Tomash1A/FPGAPlatformController/ALTIUM- UPDATED PCB DESIGN/projectHW_ADC_build/adc/adc.runs/impl_1/.init_design.begin.rst

<?xml version="1.0"?>
<ProcessHandle Version="1" Minor="0">
    <Process Command=".planAhead." Owner="shtomer" Host="CS-RO-PC29" Pid="99484">
    </Process>
</ProcessHandle>
