Tomash1A/FPGAPlatformController/ALTIUM- UPDATED PCB DESIGN/DAC_Sources_original_version/Project Outputs for DACֹֹ_Sources/DACֹֹ_Sources.xlsx

Comment | Description | Designator | Footprint | LibRef | Quantity
600F110JT250XT | CAP CER 11PF 50V 5% NP0 0805 | C1, C3, C4, C6, C10, C19, C145, C147, C148, C150, C154, C156, C157, C159, C163, C165, C166, C168, C172, C174, C175, C177, C181, C183, C184, C186, C190, C192, C193, C195, C199, C201 | C0805 | b4654b650e69147ec39a6b967a45e02 | 32
600F120JT250XT | CAP CER 11PF 50V 5% NP0 0805 | C2, C5, C11, C146, C149, C155, C158, C164, C167, C173, C176, C182, C185, C191, C194, C200 | C0805 | b4654b650e69147ec39a6b967a45e02 | 16
GJM1555C1H3R3CB01D | Multi-Layer Ceramic Capacitor 3.3pF C0G ±0.25pF 0402 Paper T/R | C7, C8, C9, C142, C143, C144, C151, C152, C153, C160, C161, C162, C169, C170, C171, C178, C179, C180, C187, C188, C189, C196, C197, C198 | C0402 | 02cd4be3c70576c341d710602a673aa | 24
CL31B103KHFNNNE | Cap Ceramic 10nF 630V X7R ±10% SMD 1206 +125°C Embossed T/R | C12, C14, C16, C18, C21, C22, C25, C26, C27, C29, C32, C309, C310, C311, C312, C313, C314, C315 | C1206 | b4654b650e69147ec39a6b967a45e02 | 18
C1206C150J5GACTU | 1206 C 15pF Ceramic Multilayer Capacitor; 50 VDC; +125degC; C0G Dielec; +/-5% | C13 | C1206 | b4654b650e69147ec39a6b967a45e02 | 1
CL10A475KP8NNNC | Cap Ceramic 4.7uF 10V X5R ±10% Pad SMD 0603 +85°C T/R | C15, C17, C20, C24, C28, C30, C31 | C0603 | b4654b650e69147ec39a6b967a45e02 | 7
C1005X7R1E102K050BA | Multilayer Ceramic Capacitors 1nF ±10% 25V X7R SMD 0402 | C23, C210, C213, C214, C217 | C0402 | b4654b650e69147ec39a6b967a45e02 | 5
GCM188R71C274KA37D | Ceramic Capacitor for Automotive 270nF ±10% 16VDC X7R 0603 Paper T/R | C33 | C0603 | 02cd4be3c70576c341d710602a673aa | 1
C0603C220J5GACTU | Cap Ceramic 22pF 50V C0G 5% SMD 0603 125°C Paper T/R | C34, C295 | C0603 | b4654b650e69147ec39a6b967a45e02 | 2
C1608X7R1C105K080AC | Multilayer Ceramic Capacitors 1μF ±10% 16V X7R SMD 0603 | C35, C39, C42, C53, C58, C64, C66, C71, C73, C88, C93, C99, C101, C106, C108, C289, C293, C297, C300, C304 | C0603 | 236180d848d6139a670b325ea6854c9 | 20
C1005X7R1E103K050BB | Multilayer Ceramic Capacitors 10nF ±10% 25V X7R SMD 0402 | C36, C48, C54, C59, C62, C65, C67, C72, C74, C89, C94, C97, C100, C102, C107, C109, C115, C123, C141, C270, C271, C272, C274, C275, C276, C277, C278, C279, C281, C282, C285, C286, C287, C290, C301, C306, C316, C317, C318, C319, C320, C321, C322, C323 | C0402 | b4654b650e69147ec39a6b967a45e02 | 44
GRM21BR71A106KE51L |  | C37, C38, C40, C46, C55, C56, C57, C63, C68, C69, C75, C76, C90, C91, C92, C98, C103, C104, C110, C111, C291, C292, C296, C299, C302, C303 | C0805 | CAP | 26
C1005X7R1C104K050BC | Multilayer Ceramic Capacitors 100nF ±10% 16V X7R SMD 0402 | C41, C43, C44, C47, C60, C95, C116, C117, C118, C119, C120, C124, C125, C126, C127, C128, C129, C130, C133, C134, C135, C136, C137, C138, C139, C140, C211, C212, C215, C216, C294, C298, C305 | C0402 | b4654b650e69147ec39a6b967a45e02 | 33
C1005X5R1C105K050BC | Chip Capacitor, 1 uF, +/- 10%, 16 V, -55 to 85 degC, 0402 (1005 Metric), RoHS, Tape and Reel | C45 | C0402 | CAP-NP-2 | 1
GRM31CR61A476ME15L | Chip Multilayer Ceramic Capacitors for General Purpose, 1206, 47uF, X5R, 15%, 20%, 10V | C49 | C1206 | 02cd4be3c70576c341d710602a673aa | 1
NFM31PC276B0J3L | Large Current 3 Terminals Low ESL Chip Multilayer Ceramic Capacitors for General Purpose, 1206, 27uF, 20%, 6.3V | C50, C85, FB8, FB9, FB14, FB24 | FP-NFM31-0_2-MFG | 968ca41a07abfef6fd4f7114a56c54f | 6
CL31A226MOCLNNC | Cap Ceramic 22uF 16V X5R ±20% SMD 1206 +85°C Embossed T/R | C51, C61, C86, C96 | C1206 | b4654b650e69147ec39a6b967a45e02 | 4
LMK105BJ225KV-F | None | C52, C70, C77, C87, C105, C112 | C0402 | b4654b650e69147ec39a6b967a45e02 | 6
GRM155R71C104KA88D | CAP CER 0.1UF 16V X7R 0402 | C78, C79, C81, C82, C83, C84 | C0402 | 236180d848d6139a670b325ea6854c9 | 6
C1206C479C5GACTU | CAP CER 4.7PF 50V C0G/NP0 1206 | C80 | C1206 | b4654b650e69147ec39a6b967a45e02 | 1
CL31B475KPHNNNE | Cap Ceramic 4.7uF 10V X7R ±10% SMD 1206 +125°C Embossed T/R | C113, C114, C121, C122, C131, C132, C266 | C1206 | b4654b650e69147ec39a6b967a45e02 | 7
LMK063BJ224MP-F | None | C202, C203, C204, C206, C207, C208, C219, C220, C221, C222, C223, C224, C225, C227, C228, C229, C230, C232, C233, C234, C236, C237, C240, C241, C242, C243, C244, C245, C246, C248, C249, C250, C251, C253, C254, C255, C257, C258, C260, C261, C262, C264 | C0201 | b4654b650e69147ec39a6b967a45e02 | 42
LMK107BJ106MALTD | CAP CER 10UF 10V X5R 0603 | C205, C209, C226, C231, C235, C238, C247, C252, C256, C259, C263 | C0603 | b4654b650e69147ec39a6b967a45e02 | 11
LMK063BJ104KP-F | None | C218, C239, C307, C308 | C0201 | b4654b650e69147ec39a6b967a45e02 | 4
CGB3B1X5R1A475K055AC | CAP CER 4.7UF 10V X5R 0603 | C265, C273, C280, C288 | C0603 | b4654b650e69147ec39a6b967a45e02 | 4
GRM21BR61A106KE19L | CAP, Ceramic, 10 uF, 10%, 10 V, 0805, RoHS, Tape and Reel | C267, C268 | C0805 | CAP-NP-2 | 2
GRM155R61A105KE15D | CAP CER 1UF 10V X5R 0402 | C269 | C0402 | 02cd4be3c70576c341d710602a673aa | 1
CC0603KRX7R9BB103 | CAP CER 10000PF 50V X7R 0603 | C283, C284 | C0603 | 11868f565c42a9108669ba33697ecf6 | 2
LTST-C170GKT | LED GREEN CLEAR SMD | D1 | FP-LTST-C170GKT-MFG | 8706943c75ba83719d021d2fdc84c58 | 1
LTST-C170TBKT | LED BLUE CLEAR SMD | D2 | FP-LTST-C170TBKT-MFG | 8706943c75ba83719d021d2fdc84c58 | 1
BLM15PD121SN1D | Chip Ferrite Bead, 0402, 120Ω @ 100MHz, 0.09Ω, 25%, 1.3A | FB1, FB2, FB3, FB4, FB5, FB6, FB21, FB22, FB23, FB25 | BLM15 | 5f30dd21d616792df468990f7003faa | 10
FBMJ3216HM600-T | Ind Chip Bead 60Ohm 25% Ferrite 4A 1206 T/R | FB7 | BEADC3216X130N | FBMJ3216HM600-T | 1
BLM41PG102SN1L | Ferrite Bead, 1806, 1000Ω @ 100MHz, 25%, 0.09Ω, 1.5A | FB10, FB12, FB13, FB15, FB16, FB17, FB19, FB20 | BLM41 | 5f30dd21d616792df468990f7003faa | 8
BLM18HE152SN1D | Chip Ferrite Bead, 0603, 1500Ω @ 100MHz, 0.5Ω, 25%, 500mA | FB11 | BLM18 | 5f30dd21d616792df468990f7003faa | 1
BLM18HE152SN1D | Chip Ferrite Bead, 0603, 1500Ω @ 100MHz, 0.5Ω, 25%, 500mA | FB18 | BLM41 | 5f30dd21d616792df468990f7003faa | 1
61083-104400LF | Conn Fine Pitch Connector PL 100 POS 0.8mm Solder ST Top Entry SMD BergstakÂ® Tube | J1, J2 | AMPHENOL_61083-104400LF | 61083-104400LF | 2
142-0701-801 | CONN SMA JACK STR 50OHM EDGE MNT | J3 | FP-142-0701-801-MFG | 89929399afe843c8b6880c6cbd0f99a | 1
731000114 | SMA Right-Angle PCB Jack Receptacle, Brass Body, Gold Plated, 50 Ohm, 5-Pin THD, RoHS, Tray | J4, J5, J7, J8, J9, J10, J11, J12, J13, J14, J15, J16 | MOLX-731000114_V | CN-S-4F-RF5 | 12
RAPC722X | Power Jack, 5 A, 3-Pin THD, RoHS, Bulk | J6 | SWITCH-RAPC712X-3_V | SWITCH-RAPC712X-3 | 1
85305-0232 | CONN SMP PLUG STR 50 OHM SMD | J25 | FP-85305-0232-MFG | d2a53f3a980517e545f22a6fb6569cc | 1
LPS3015-222MR |  | L1, L2, L3, L4, L5, L70 | lps3015 | Component_1 | 6
0805HQ-16NXGLC | 0805HQ-16NXGLC | L6, L9, L10, L13, L14, L17, L18, L21, L22, L25, L26, L29, L30, L33, L34, L37, L38, L41, L42, L45, L46, L49, L50, L53, L54, L57, L58, L61, L62, L65, L66, L69 | 0805HP | Inductor Iron | 32
0805HP-33NXGRC | 0805HP 33nH | L7, L8, L11, L12, L15, L16, L19, L20, L23, L24, L27, L28, L31, L32, L35, L36, L39, L40, L43, L44, L47, L48, L51, L52, L55, L56, L59, L60, L63, L64, L67, L68 | 0805HP | Inductor Iron | 32
Header 10X2 | Header, 10-Pin, Dual row | P1 | HEADER_10X2 | Header 10X2 | 1
Header 2 | Header, 2-Pin | P2 | HEADER_2X1 | Header 2 | 1
Header 3 | Header, 3-Pin | P3, P4, P5, P6, P7, P8, P9, P13, P14, P15 | HEADER_3X1 | Header 3 | 10
Header 4X2 | Header, 4-Pin, Dual row | P10 | HEADER_4X2 | Header 4X2 | 1
CSD18532Q5BT | MOSFET N-CH 60V 100A 8VSON | Q1 | FP-DNK0008A-MFG | 7382af88e928fdc71488234cfaaf11c | 1
RMCF0402FT100R | 100Ω ±1% 0.063W 0402 Thick Film Chip Resistor AEC-Q200 compliant | R1, R7, R10, R11, R12, R59, R60, R61, R62, R63, R64, R65, R66, R67, R68, R69 | R0402 | 1029c3af85768c4190bb7ad29bc67b5 | 16
CRCW020149R9FKED |  | R2, R3, R4, R5, R6, R8, R13, R14, R15, R16, R17, R18, R19, R20, R21, R22, R48 | R0201 | RES | 17
ERJ2RKF1002X | Chip Resistor, 10 KOhm, +/- 1%, 0.1 W, -55 to 155 degC, 0402 (1005 Metric), RoHS, Tape and Reel | R9, R80, R81 | R0402 | RES-2 | 3
RNCP1206FTD10K0 | 10kΩ ±1% 0.5W 1206 High Power Anti-Sulfur Thin Film Chip Resistor | R23, R24 | R1206 | 1029c3af85768c4190bb7ad29bc67b5 | 2
ERJ-2RKF82R5X |  | R25, R28, R84 | R0402 | RES | 3
ERJ-2RKF1300X |  | R26, R29, R85, R86, R87, R89, R90, R116, R117, R118, R119 | R0402 | RES | 11
ERJ-2RKF49R9X | RES SMD 49.9 OHM 1% 1/10W 0402 | R27, R91, R93 | R0402 | 8db39607336c341a927600551d01821 | 3
RC0603FR-071KL | RES 1K OHM 1% 1/10W 0603 | R30 | R0603 | 1029c3af85768c4190bb7ad29bc67b5 | 1
CRCW0402301RFKED |  | R31 | R0402 | RES | 1
750K 5% 0402(1005) | 750K 0.063W 5% 0402 (1005 Metric) SMD | R32, R107 | R0402 | RES | 2
ERJ-3EKF3092V |  | R33, R105, R109 | R0603 | RES | 3
ERJ3EKF1002V | Chip Resistor, 10 KOhm, +/- 1%, 0.1 W, -55 to 155 degC, 0603 (1608 Metric), RoHS, Tape and Reel | R34, R35, R106, R110 | R0603 | RES-2 | 4
RC0402FR-07150KL | RES 150K OHM 1% 1/16W 0402 | R36, R108 | R0402 | 1029c3af85768c4190bb7ad29bc67b5 | 2
CRCW0603750KFKEA |  | R37, R51 | R0603 | RES | 2
RC0603FR-07150KL |  | R38, R52 | R0603 | 1029c3af85768c4190bb7ad29bc67b5 | 2
CRCW0603191KFKEA |  | R39, R53 | R0603 | RES | 2
ERJ-2RKF1743X |  | R40, R43, R54, R57 | R0402 | RES | 4
ERJ-3EKF1823V |  | R41, R55 | R0603 | RES | 2
ERJ2RKF3303X |  | R42, R44, R56, R58 | R0402 | RES | 4
RMCF1206ZT0R00 | 0Ω ±0 0.25W 1206 Thick Film Chip Resistor AEC-Q200 compliant | R45, R47, R49 | R1206 | 1029c3af85768c4190bb7ad29bc67b5 | 3
RMCF1206JT33R0 | 33Ω ±5% 0.25W 1206 Thick Film Chip Resistor AEC-Q200 compliant | R46, R50 | R1206 | 1029c3af85768c4190bb7ad29bc67b5 | 2
ERJ-2RKF1001X | Chip Resistor, 1 KOhm, +/- 1%, 100 mW, -55 to 155 degC, 0402 (1005 Metric), RoHS, Tape and Reel | R70, R73, R75, R78 | R0402 | RES-2 | 4
ERJ-2RKF1271X |  | R71, R76 | R0402 | RES | 2
CRCW040210R0FKED |  | R72, R77 | R0402 | RES | 2
ERJ2GE0R00X | Chip Resistor, 0 Ohm, 0.1 W, -55 to 155 degC, 0402 (1005 Metric), RoHS, Tape and Reel | R74, R79, R82, R92, R122, R123, R124, R125, R126 | R0402 | RES-2 | 9
CRCW0402100RFKED | RES Thick Film, 100Ω, 1%, 0.063W, 100ppm/°C, 0402 | R83, R111, R120, R121 | R0402 | CMP-1011-00397-3 | 4
RC1206FR-0760K4L |  | R88, R94, R95, R96, R97, R98 | R1206 | RES | 6
CRCW060349R9FKEA |  | R99, R100 | R0603 | RES | 2
CRCW0603100RJNEA | RES Thick Film, 100Ω, 5%, 0.1W, 200ppm/°C, 0603 | R101, R102, R103, R104 | R0603 | 1029c3af85768c4190bb7ad29bc67b5 | 4
ERJ-2RKF1500X | RES SMD 150 OHM 1% 1/10W 0402 | R112, R113, R114, R115 | R0402 | CMP-1011-00415-3, 1029c3af85768c4190bb7ad29bc67b5 | 4
EXB-2HV470JV | EXB-2HV470JV | RN1, RN2 | EXB-2HV470JV | Component_1 | 2
KT11P3JM34LFS | SWITCH TACTILE SPST-NO 1VA 32V | SW1, SW2 | FP-KT11P3JM34LFS-MFG | a6a22157dac91622554311b1edc5dcf | 2
ETC1-1-13TR | BALUN 4.5MHZ-3GHZ 1:1 5SMD | T1, T2, T3, T4, T5, T6, T7, T8, T9, T10 | FP-ETC1-1-13TR-MFG | 4f5dfae470883114705f86a4213dd5e | 10
5010 | Test Point, Red, Through Hole, RoHS, Bulk | TP5, TP6, TP7, TP8 | 5010 | TESTPOINT_RED | 4
DAC3484IRKDT | 4-Channel 16-Bit 1.25 GSPS DAC, -40 to 85 degC, 88-pin QFN (RKD88), Green (RoHS & no Sb/Br) | U1, U6 | TI-RKD88-6300X6300TP_V | TI-DAC348XRKD88-6300X6300TP | 2
CDCE62005RGZT | IC CLK SYNTH/JITTER CLEANR 48QFN | U2 | FP-RGZ0048D-IPC_A | 79e6de338fe35b6fdc3d186d6aa1691 | 1
ADR130AUJZ-REEL7 | Precision Series Sub-Band Gap Voltage Reference, 1 V Output, 2 to 18 V Supply, Industrial, 6-pin SOT23 (UJ-6), Reel | U3 | 6-TSOT | ADI-ADR130-UJ-6 | 1
CDCP1803RGET | 1:3 LVPECL clock buffer with programable divider | U4 | QFN25 | CDCP1803RGET | 1
LTC6957HMS-2#PBF | IC CLK BUFFER DVR 1:2 12MSOP | U5 | 12_MSOP | 599d8c5e20d6343fb63873f0ba23ec7 | 1
AD6641 |  | U7 | QFN56 | Component_1 | 1
TPS62290DRVR | IC REG BUCK ADJUSTABLE 1A 6SON | U8, U32 | FP-DRV0006A-IPC_A | e18bba32e79127f802312c6d0d2e879 | 2
TPS7A8001DRBR | Single Output LDO, 1 A, Adjustable 0.8 to 6 V Output, 2.2 to 6.5 V Input, with High-Bandwidth PSRR, 8-pin SON (DRB), -40 to 125 degC, Green (RoHS & no Sb/Br) | U9, U31, U33 | DRB0008A_V | TI-TPS7A8X01DRB8-1750X1500TP | 3
TPS79633QDCQRQ1 | Single Output High PSRR LDO, 1 A, Fixed 3.3 V Output, 2.7 to 5.5 V Input, 6-pin SOT-223 (DCQ), -40 to 125 degC, Green (RoHS & no Sb/Br) | U10, U15 | DCQ0006A | TI-TPS7XXXXXXXX | 2
TPS62420DRCR | Buck Adjustable Regulator with 2.5 to 6 V Input and 0.6 to 6 V Output, -40 to 85 degC, 10-Pin SON (DRC), Green (RoHS & no Sb/Br) | U11, U16 | DRC0010G | TI-TPS62420DRC10-2400X1650TP | 2
TPS71701DCKR | Single Output LDO, 150 mA, Adjustable 0.9 to 6.2 V Output, 2.5 to 6.5 V Input, with High-Bandwidth PSRR, 5-pin SC70 (DCK), -40 to 125 degC, Green (RoHS & no Sb/Br) | U12, U13, U17, U18 | DCK | TI-TPS7XX01-5 | 4
TPS2400DBVT | 5.5-V over voltage protection controller with 100-V input transient protection 5-SOT-23 -40 to 85 | U14 | DBV0005A | TPS2400DBVT | 1
ADP1706ARDZ-3.3-R7 | 1 A, Low Dropout, CMOS Linear Regulator, 2.5 to 5.5 V Vin, 3.3 V Vout, Industrial, 8-pin SOIC (RD-8-2), Reel | U19 | ADI-RD-8-2_M | ADI-ADP1706-RD-8-2 | 1
ADP1706ARDZ-1.8-R7 | 1 A, Low Dropout, CMOS Linear Regulator, 2.5 to 5.5 V Vin, 1.8 V Vout, Industrial, 8-pin SOIC (RD-8-2), Reel | U20, U21 | ADI-RD-8-2_M | ADI-ADP1706-RD-8-2 | 2
ADT4-1WT |  | U22, U23, U24, U25, U26, U27, U28, U29 | CD542 | Component_1 | 8
DS90LV001TMX/NOPB | IC REDRIVER LVDS 1CH 8SOIC | U30 | SOIC_8 | 30cb43c013c66b9f7606d7aff426576 | 1
ASE-10.000MHZ-LC-T | XTAL Oscillator 10MHz ±50ppm CMOS 3.3V 4-SMD 3.2mm x 2.5mm | Y1 | ASE | 61a724e6190563596ac712fef61ad37 | 1
