Tomash1A/FPGAPlatformController/ALTIUM- UPDATED PCB DESIGN/projectHW_ADC_build/adc/adc.runs/projectHW_auto_pc_0_synth_1/.vivado.begin.rst

<?xml version="1.0"?>
<ProcessHandle Version="1" Minor="0">
    <Process Command="vivado.bat" Owner="shtomer" Host="CS-RO-PC29" Pid="97404" HostCore="24" HostMemory="068373053440">
    </Process>
</ProcessHandle>
