Tomash1A/FPGAPlatformController/VIVADO- PROJECT BUILDER SCRIPT/ADC and Single Tone Vivado BD Breakdown.pptx

## ADC and Single Tone Vivado BD Breakdown

## Slide 2

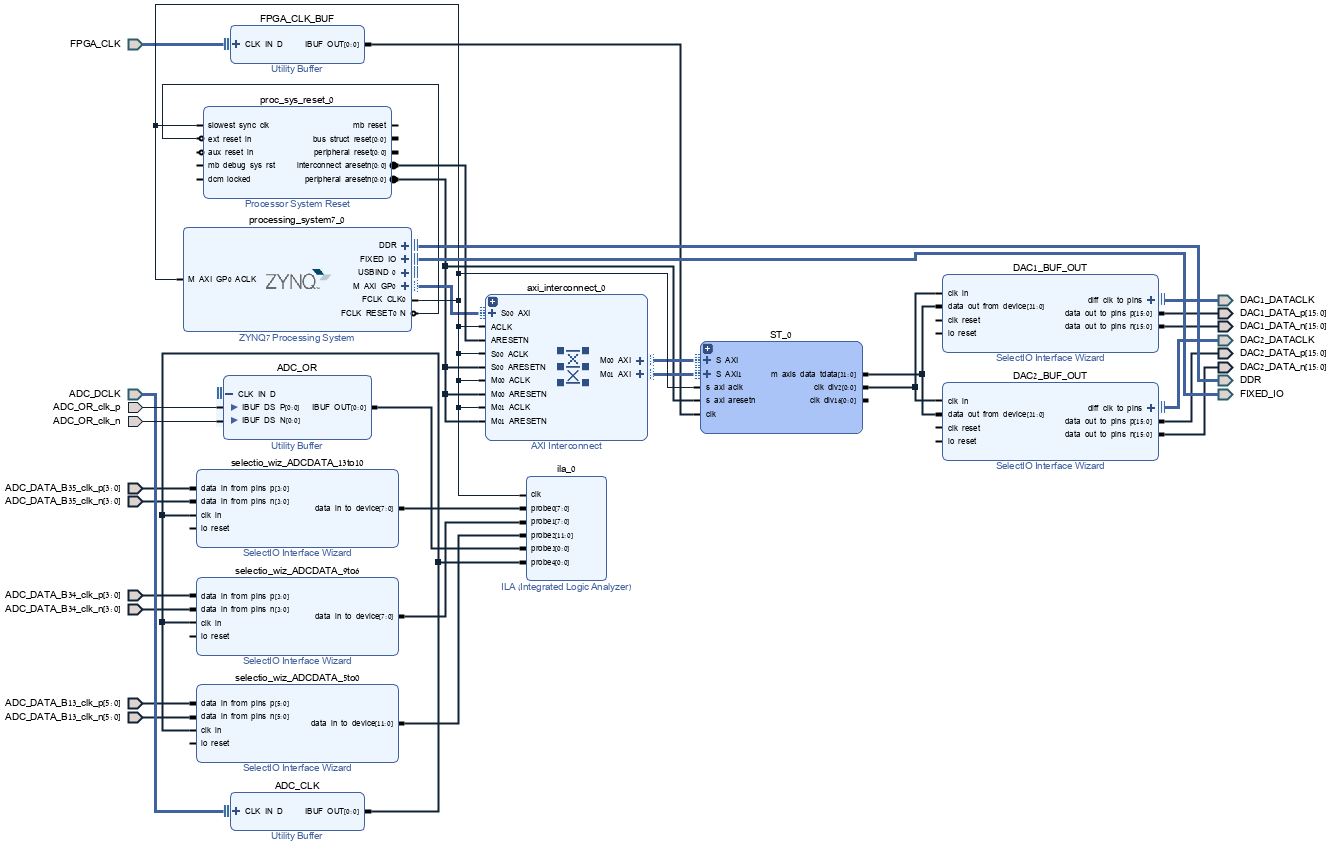
[picture p15: figure]

## Slide 3

AXI Controls for the ST. two channels, all outputs, 32b output

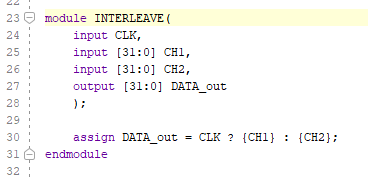
[picture p16: figure]
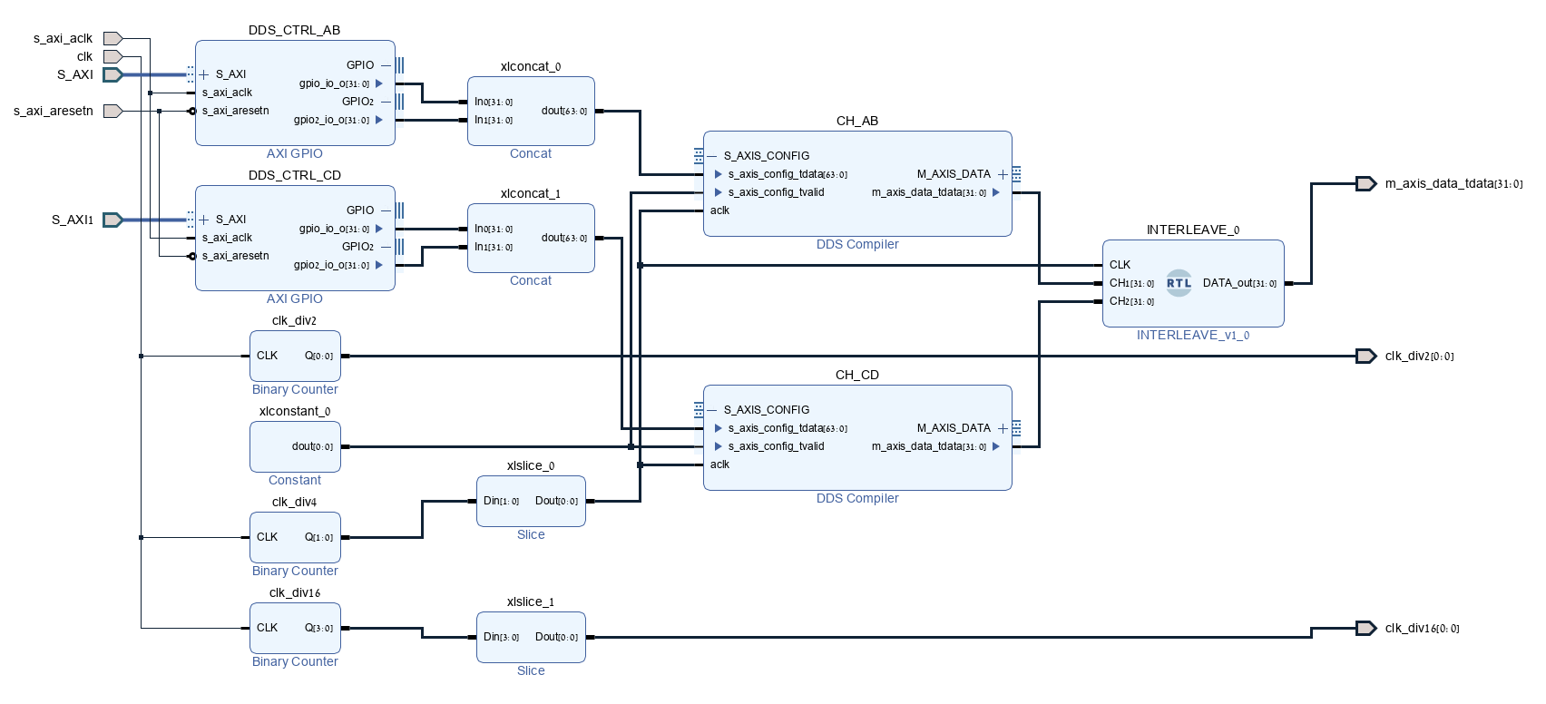
[picture p17: figure]

FPGA_CLK 250MHz

## Slide 4

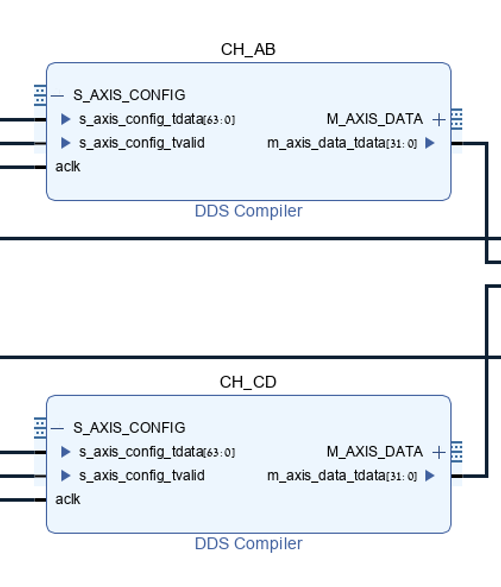
[picture p18: figure]
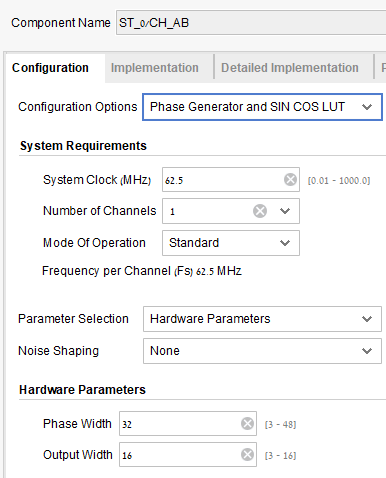
[picture p19: figure]
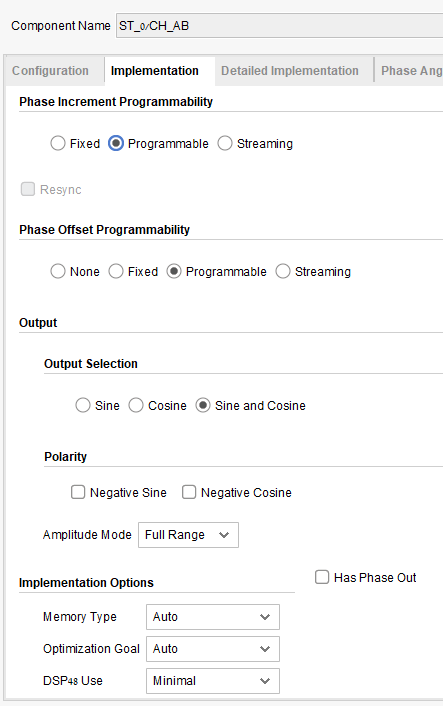
[picture p20: figure]
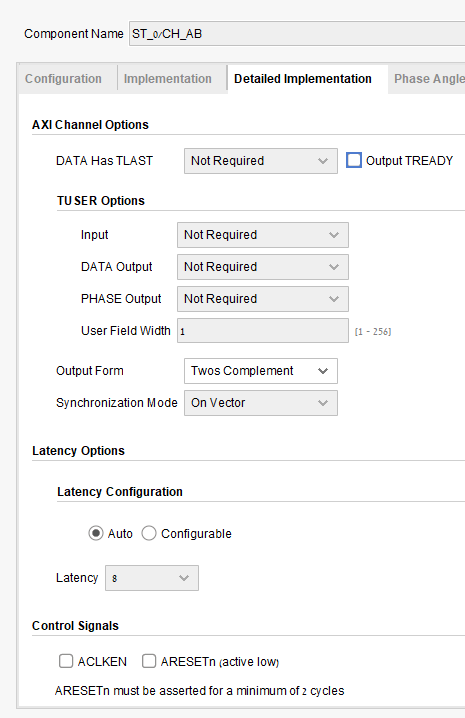
[picture p21: figure]

## Slide 5

DATA INPUTS TO ADC.
SHARED WITH MT PROFILE_ADDR AND AM_onoff AND WILL NOT WORK IN PARALLEL.
ADC_DATA BITS ARE SCATTERED IN ALL BANKS SO THEY ARE DEVIDED HERE AS WELL

ADC OUPUTS IN DDR, CH1 RISING_EDGE CH2 FALLING_EDGE
