Tomash1A/FPGAPlatformController/VIVADO- PROJECT BUILDER SCRIPT/projectHW_ADC_build/adc/adc.runs/impl_1/tight_setup_hold_pins.txt

+--------------------------+--------------------------+----------------------------------------------------------------------------------------------------------+
|       Launch Clock       |      Capture Clock       |                                                 Pin                                                      |
+--------------------------+--------------------------+----------------------------------------------------------------------------------------------------------+
|               clk_fpga_1 |               clk_fpga_1 |    projectHW_i/ila_1/inst/ila_core_inst/u_ila_regs/reg_stream_ffe/I_EN_STAT_EQ1.U_STAT/xsdb_reg_reg[15]/D|
|               clk_fpga_1 |               clk_fpga_1 |                             projectHW_i/ila_1/inst/ila_core_inst/u_ila_regs/U_XSDB_SLAVE/reg_do_reg[12]/D|
+--------------------------+--------------------------+----------------------------------------------------------------------------------------------------------+
