Tomash1A/FPGAPlatformController/VIVADO- PROJECT BUILDER SCRIPT/Multi Tone Vivado BD Breakdown.pptx

## Multi Tone Vivado BD Breakdown

## Slide 2

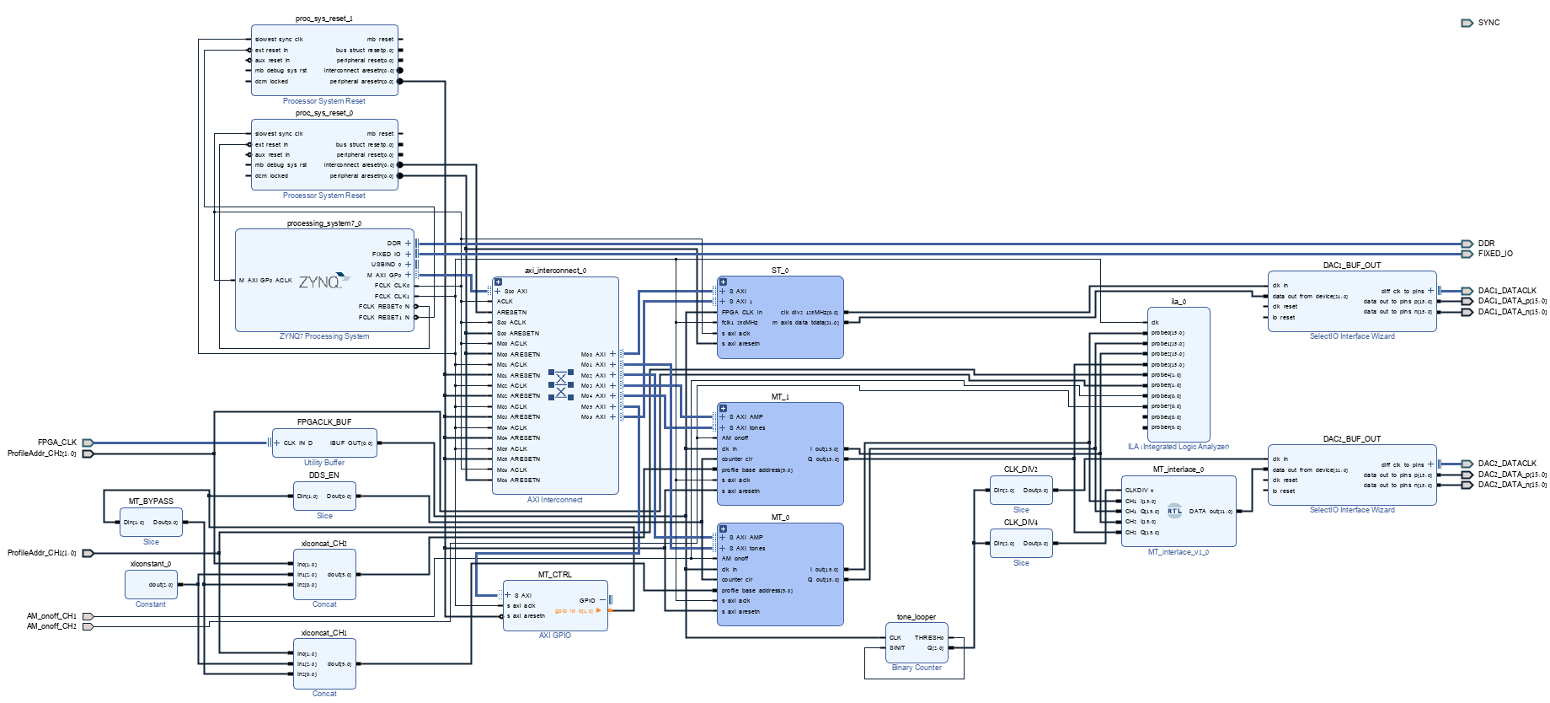
[picture p22: figure]

FPGACLK FROM CDCE = 250MHz

Interleaves MT1 with MT0 so rising edge of FPGA_CLK/4: OUT = {CH1I,CH1Q}
FALLINGEDGE: OUT=
{CH2I,CH2Q}

OUTPUTS DATA TO DAC2 WITH DATACLK= FPGACLK/2

CONTROLS BYPASS AND DDS_EN

I/Os controlling ch1/2

Profile address[5:0]: {BYPASS, 000,PR1,PR0}

CONNECTED TO FPGA_CLK and divides the clock

## Slide 3

DOES (I/Q_OUT)*AMP
USE MULTS, SPEED OPTIMISED, 1 CYCLE DELAY. I/Q 16B SIGNED, AMP 16B UNSIGNED

SMOOTHS OUPUT USING INTERPOLATION OVER 4 SAMPLES

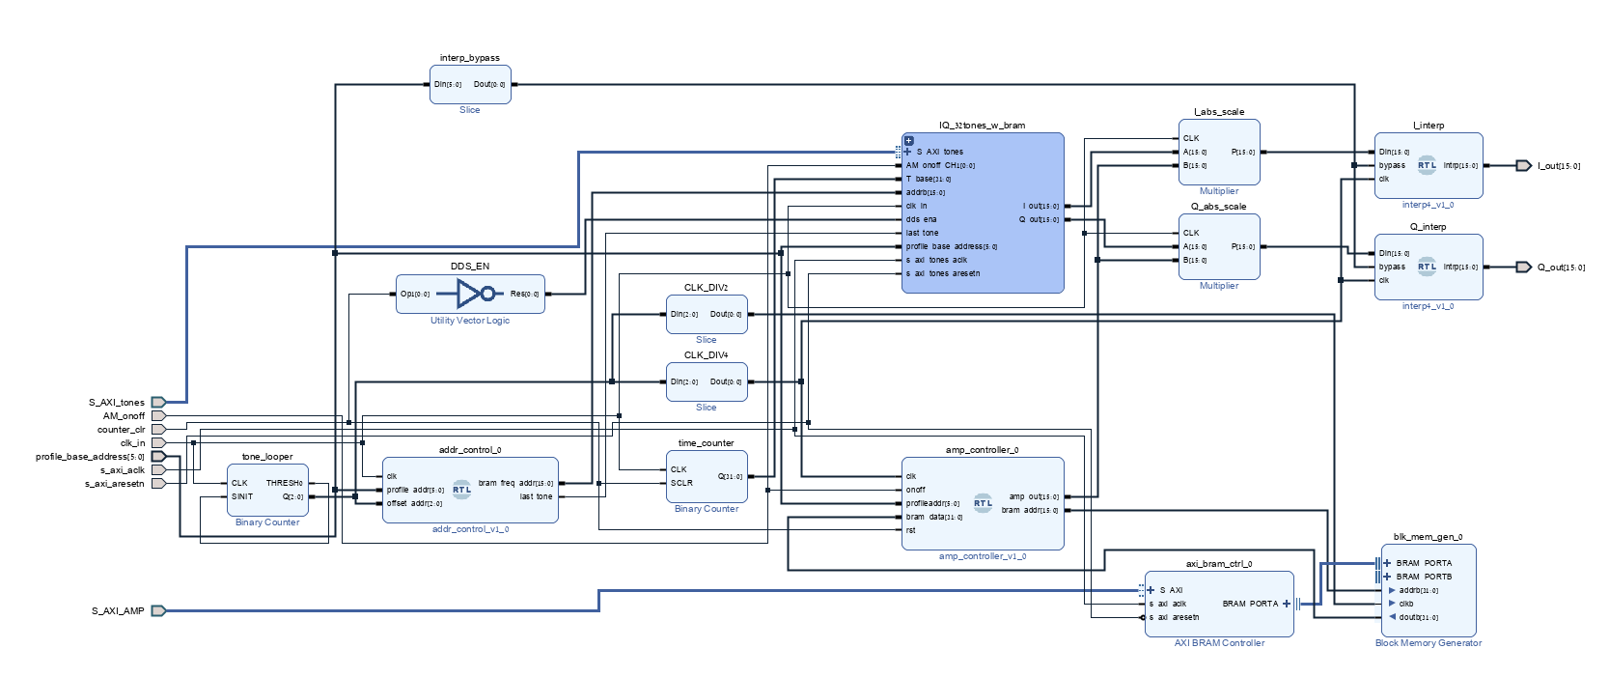
[picture p23: figure]

CLK_DIV2: BIT0
CLK_DIV4: BIT1

CHOOSES THE SIZE OF THE AMPLITUDE. SAVED IN BRAM AS AMP_PROFILES OF [NUM_STEPS, STEP_SIZE]. STEP SIZE COULD BE NEGATIVE TO REDUCE THE SIZE OF THE AMPLITUDE.

COUNTS 0 TO 7

CREATES THE TIME VECTOR FOR THE SINE

## Slide 4

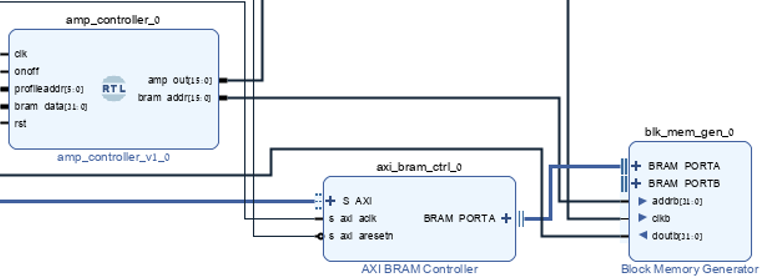
[picture p24: figure]
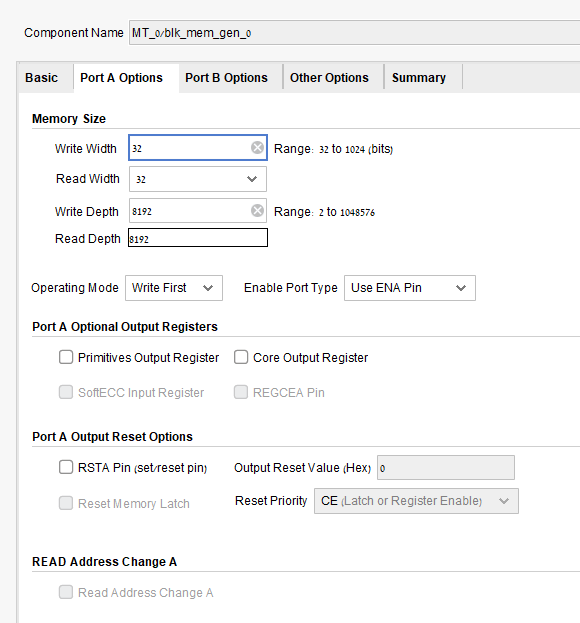
[picture p25: figure]
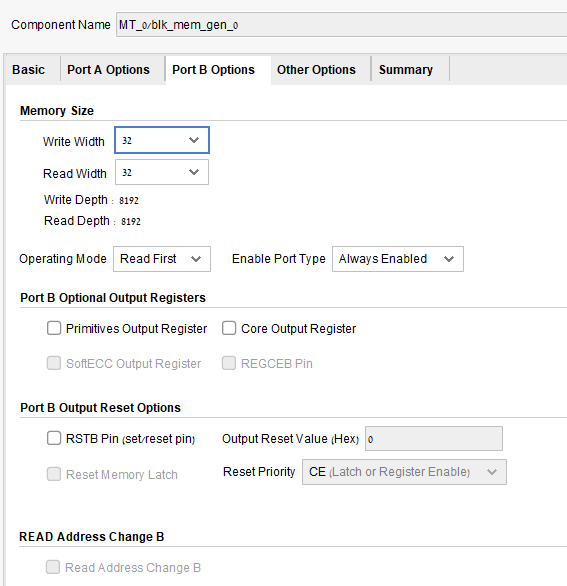
[picture p26: figure]
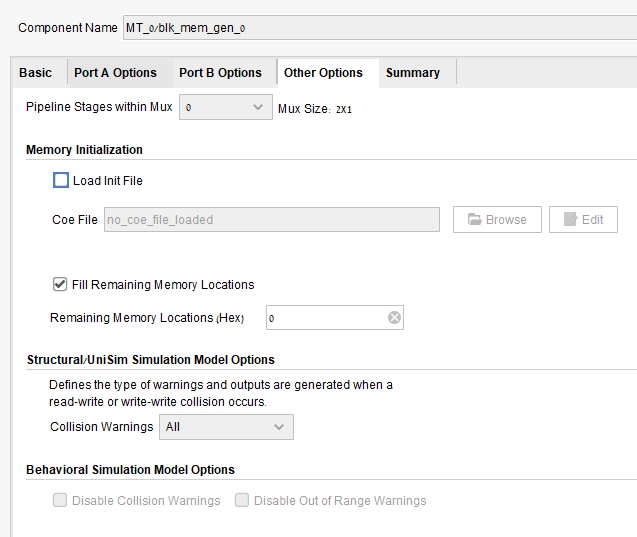
[picture p27: figure]

## Slide 5

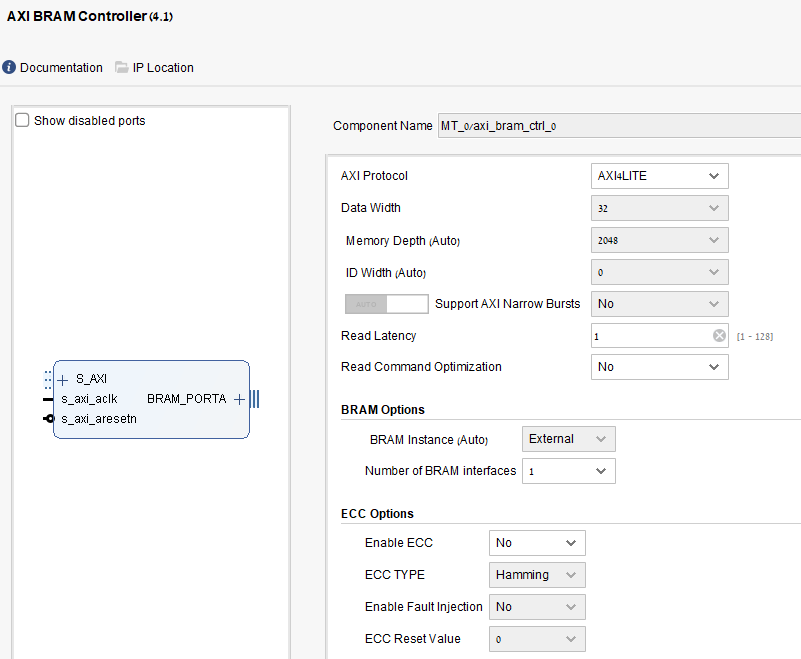
[picture p28: figure]

## Slide 6

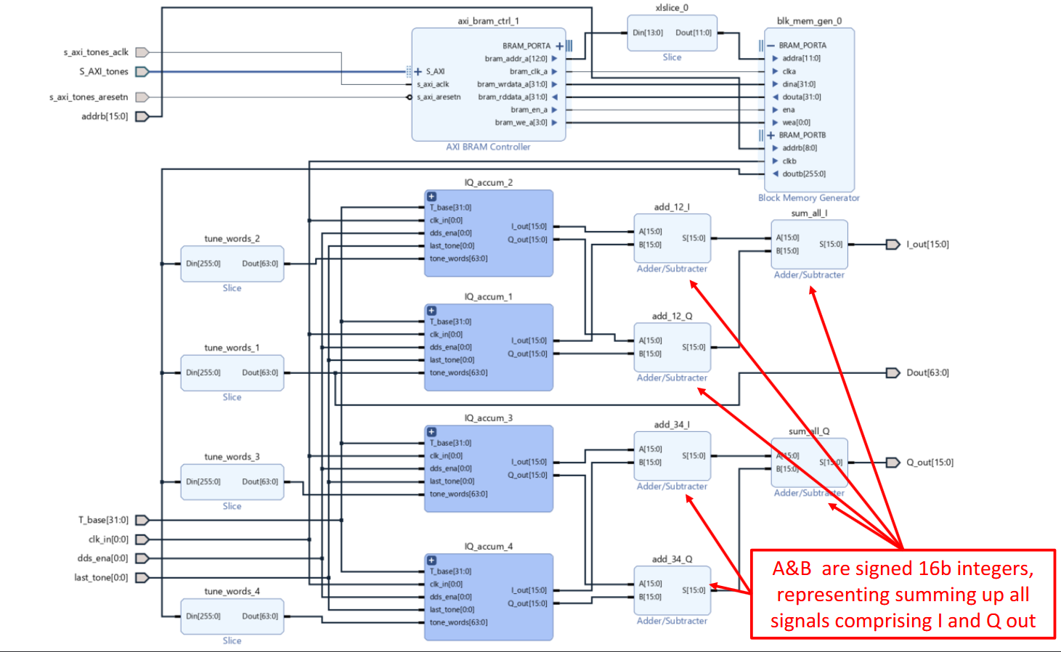
[picture p29: figure]

INSIDE SLICING OF EACH TONE WORD

SHOULD BE [14:0]. IN ADDRESS EDITOR:
/MT_x/IQ_32tones_w_bram/axi_bram_ctrl_0/S_AXI SIZE SHOULD BE 32K

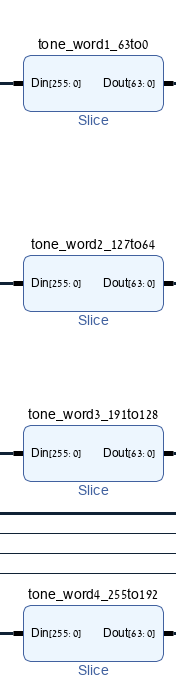
[picture p30: figure]

## Slide 7

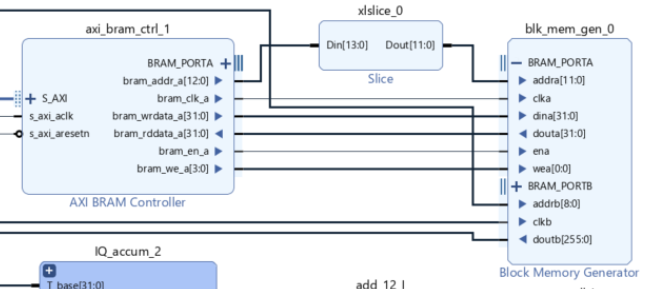
[picture p31: figure]
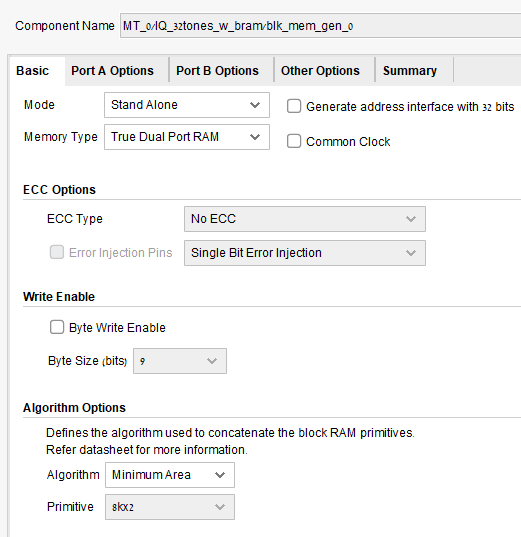
[picture p32: figure]
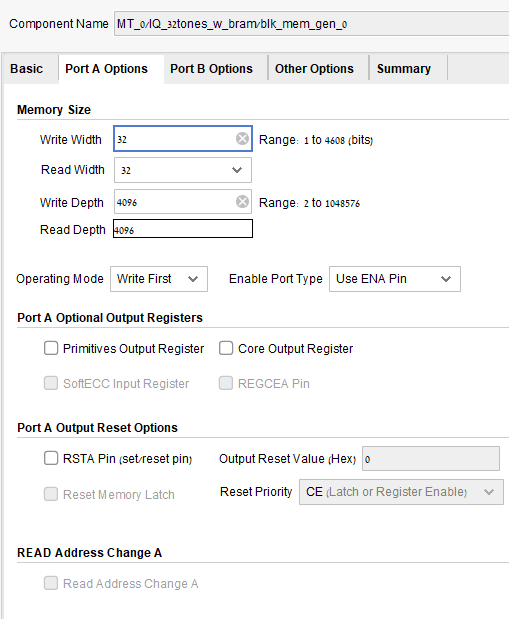
[picture p33: figure]
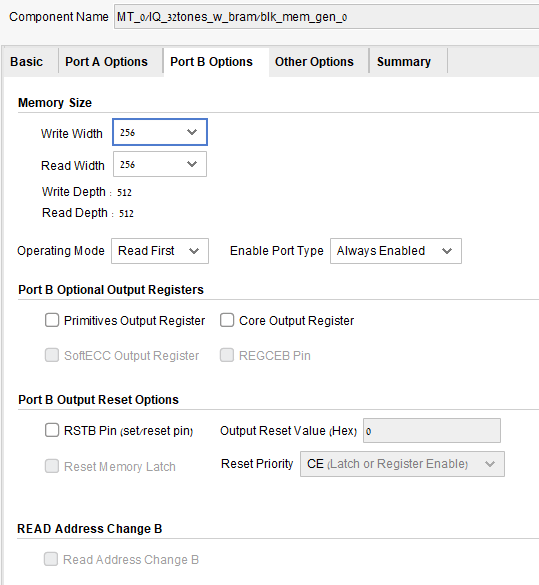
[picture p34: figure]
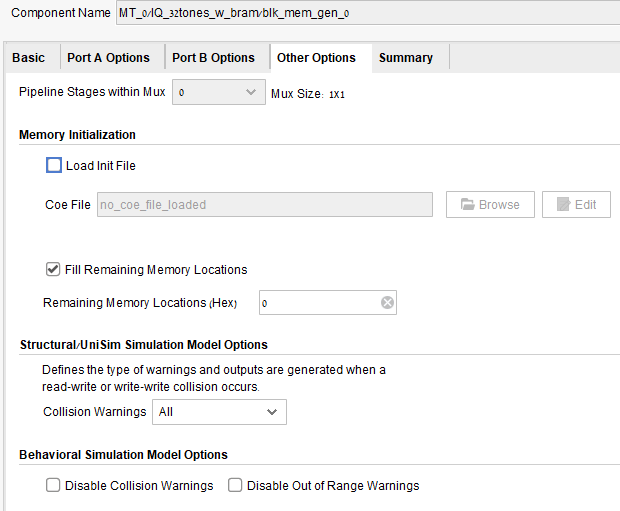
[picture p35: figure]

## Slide 8

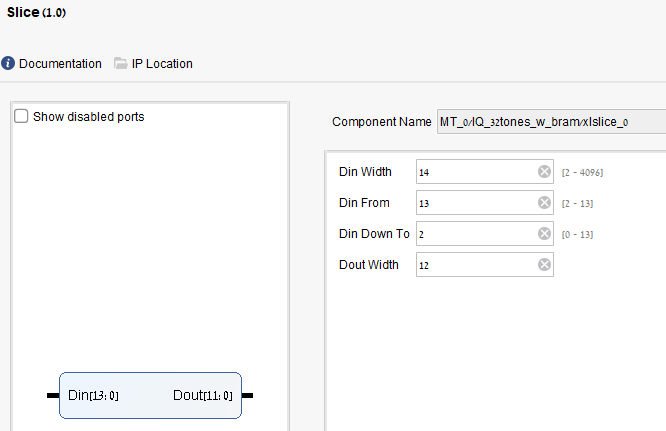
[picture p36: figure]
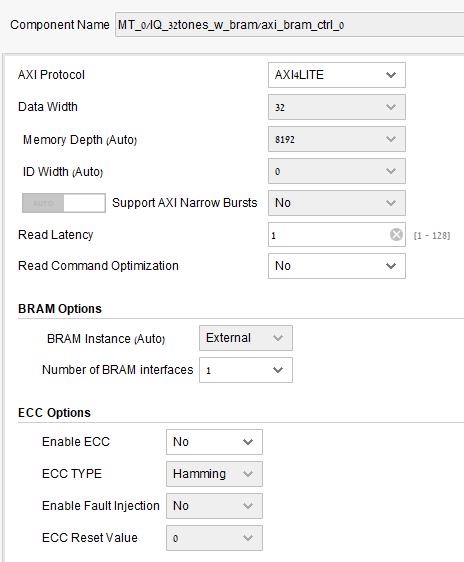
[picture p37: figure]

## Slide 9

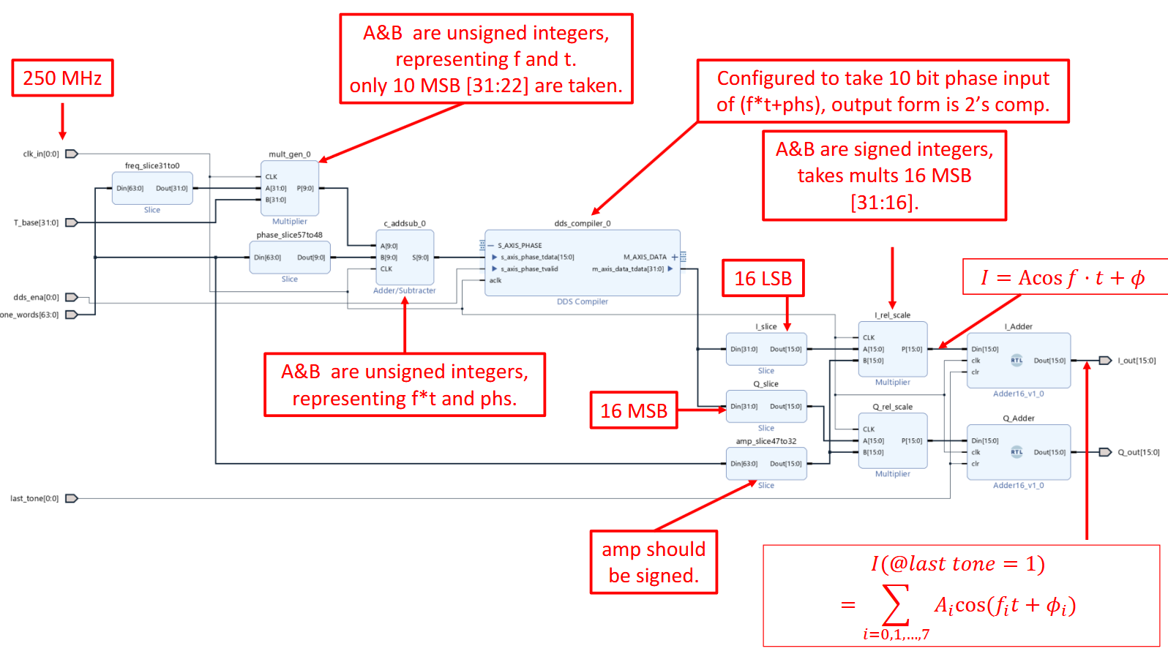
[picture p38: figure]

Delay 4 cycles, use mults, speed optimized

Delay 3 cycles

Delay 4 cycles, use mults, speed optimized

Phase delay may ne unsynced. Add an adder/substracter with 4 cycles delay to make it work.
