Tomash1A/FPGAPlatformController/VIVADO- PROJECT BUILDER SCRIPT/projectHW_ADC_build/projectHW/projectHW_wADC.PNG

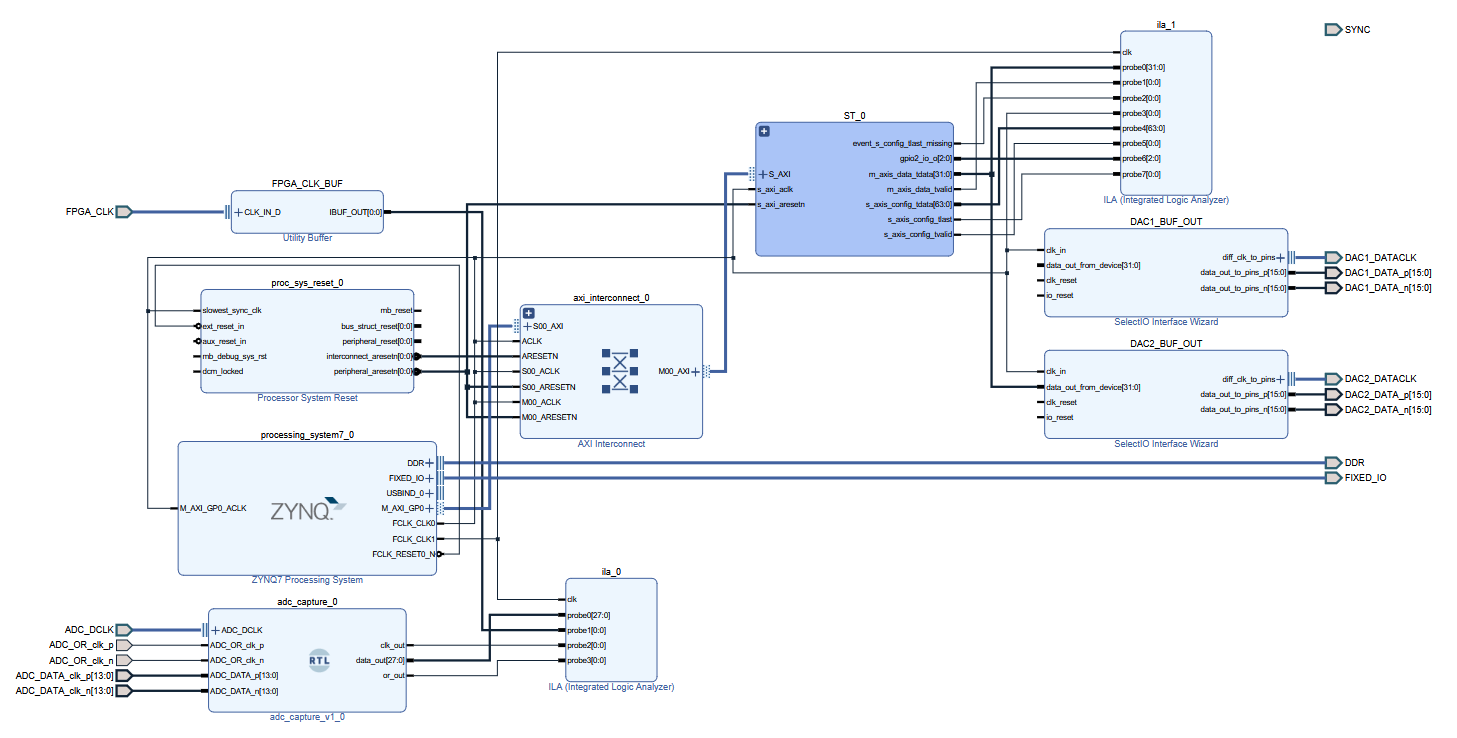
VIVADO- PROJECT BUILDER SCRIPT/projectHW_ADC_build/projectHW/projectHW_wADC.PNG
