Tomash1A/FPGAPlatformController/ALTIUM- UPDATED PCB DESIGN/DACֹֹ_Sources_REV2_FOR_FUTURE_VERSIONS/DACֹֹ_Sources_REV2.pdf

# GJM1555C1H3R3CB01D 1 2

D10- | 33 D10+ | 34 D11- | 35 D11+ | 36 DRVDD | 37 D12- | 38 D12+ | 39 D13-(MSB) | 40 D13+(MSB) | 41 OR- | 42 OR+ | 43 SDIO | 44 SCLK | 45 CSB | 46 OEB | 47 PDWN | 48 AVDD | 49 AVDD | 50 VIN+A | 51 VIN-A | 52 AVDD | 53 AVDD | 54 DNC | 55 DNC | 56 VCM | 57 DNC | 58 AVDD | 59 AVDD | 60 VIN-B | 61 VIN+B | 62 AVDD | 63 AVDD | 64 EPAD | 65

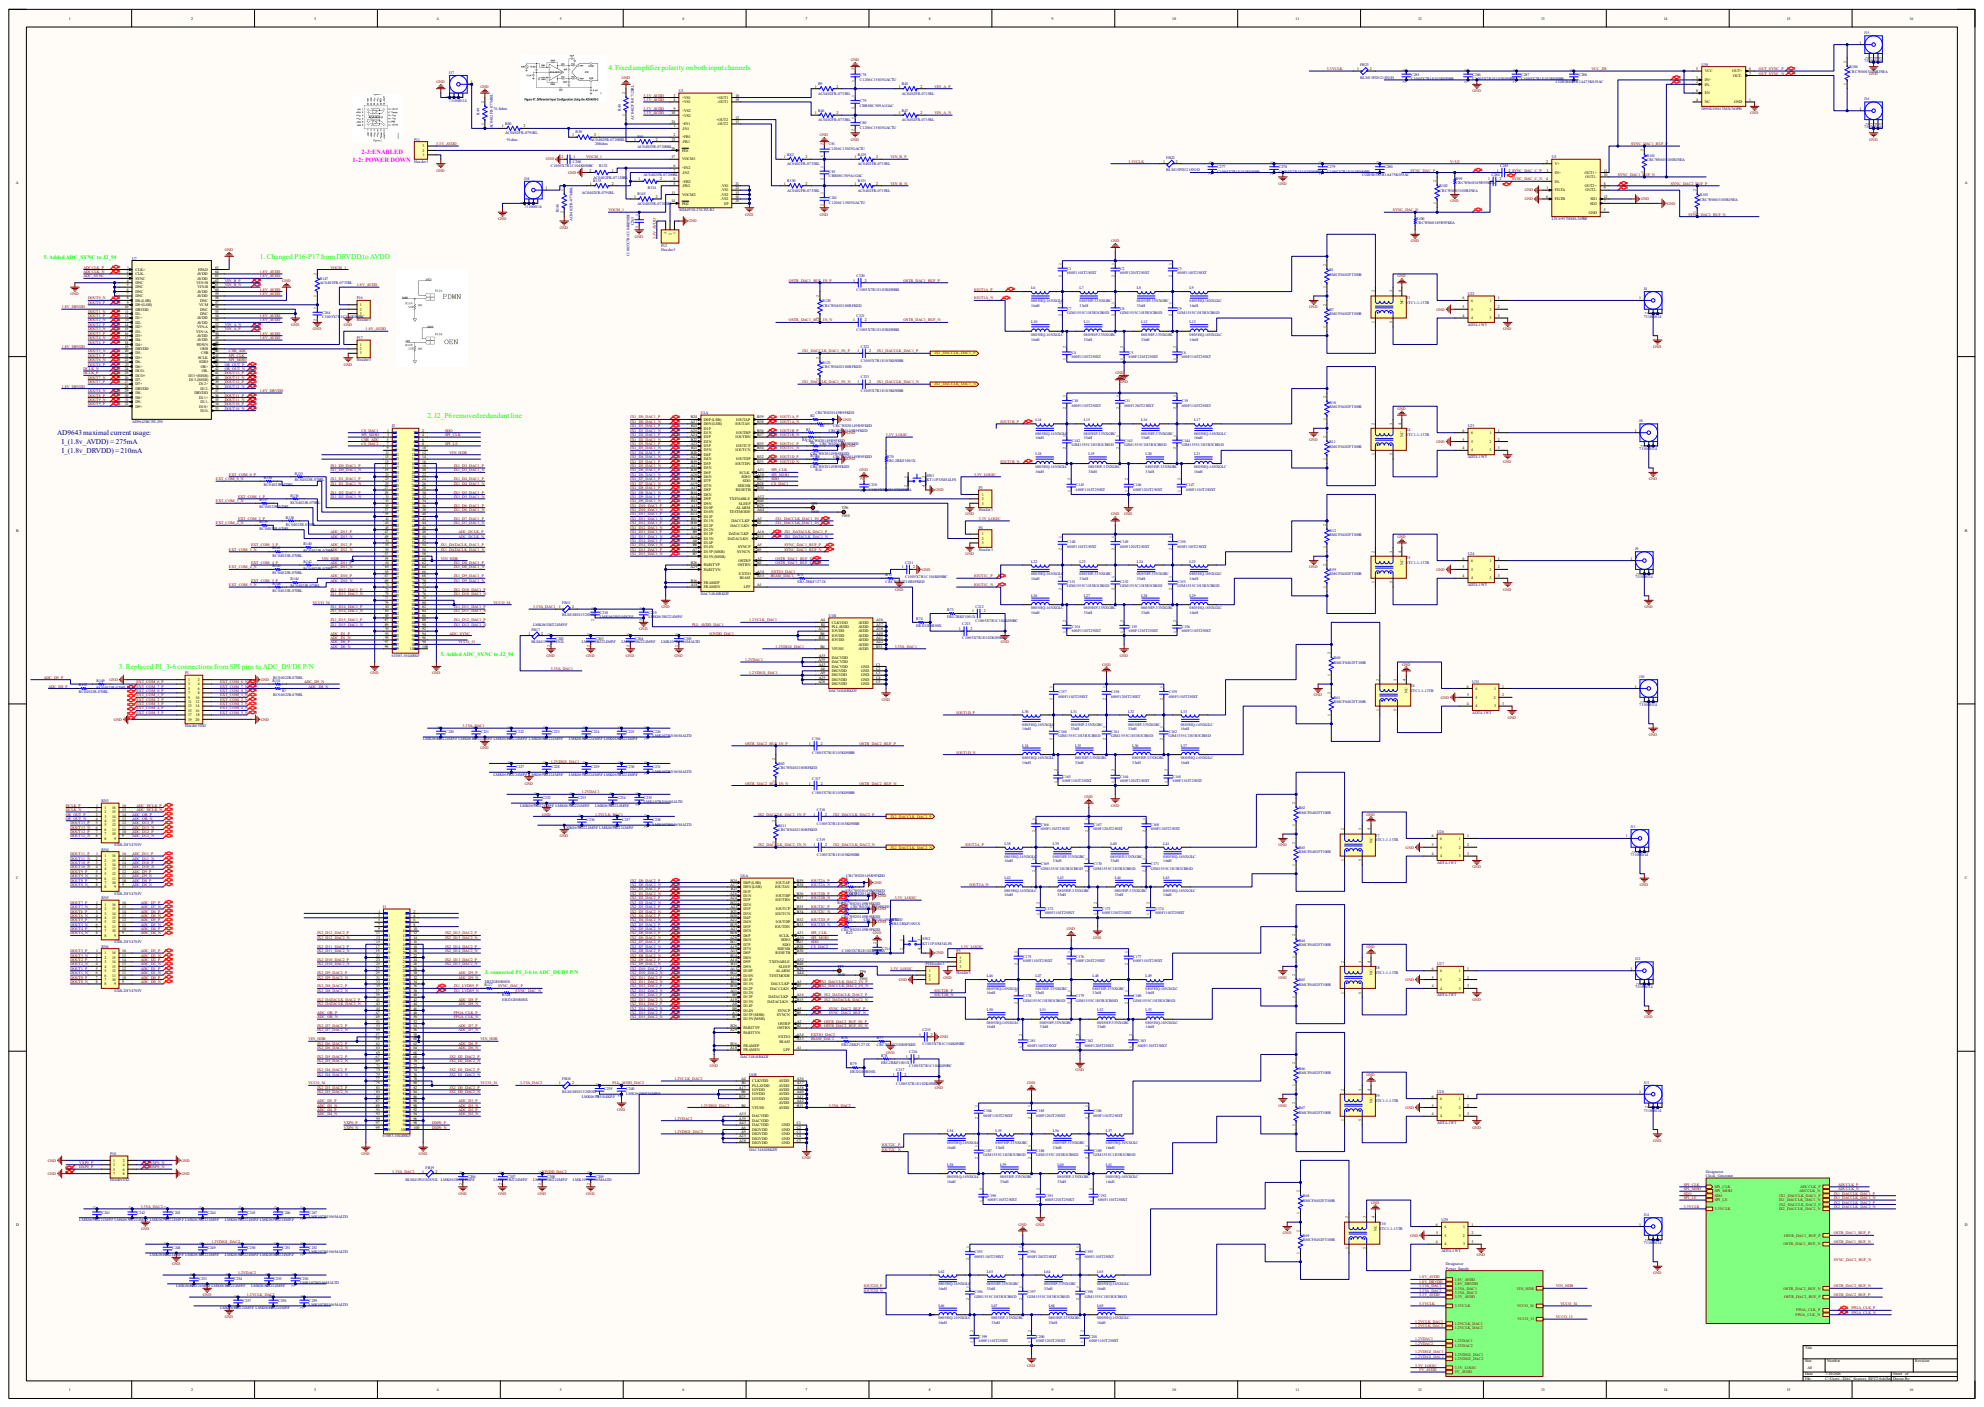
[picture p40: page 1]

4. Fixed amplifier polarity on both input channels

1. Changed P16-P17 from DRVDD to AVDD

3. Replaced P1_3-6 connections from SPI pins to ADC_D9/D8 P/N

A A

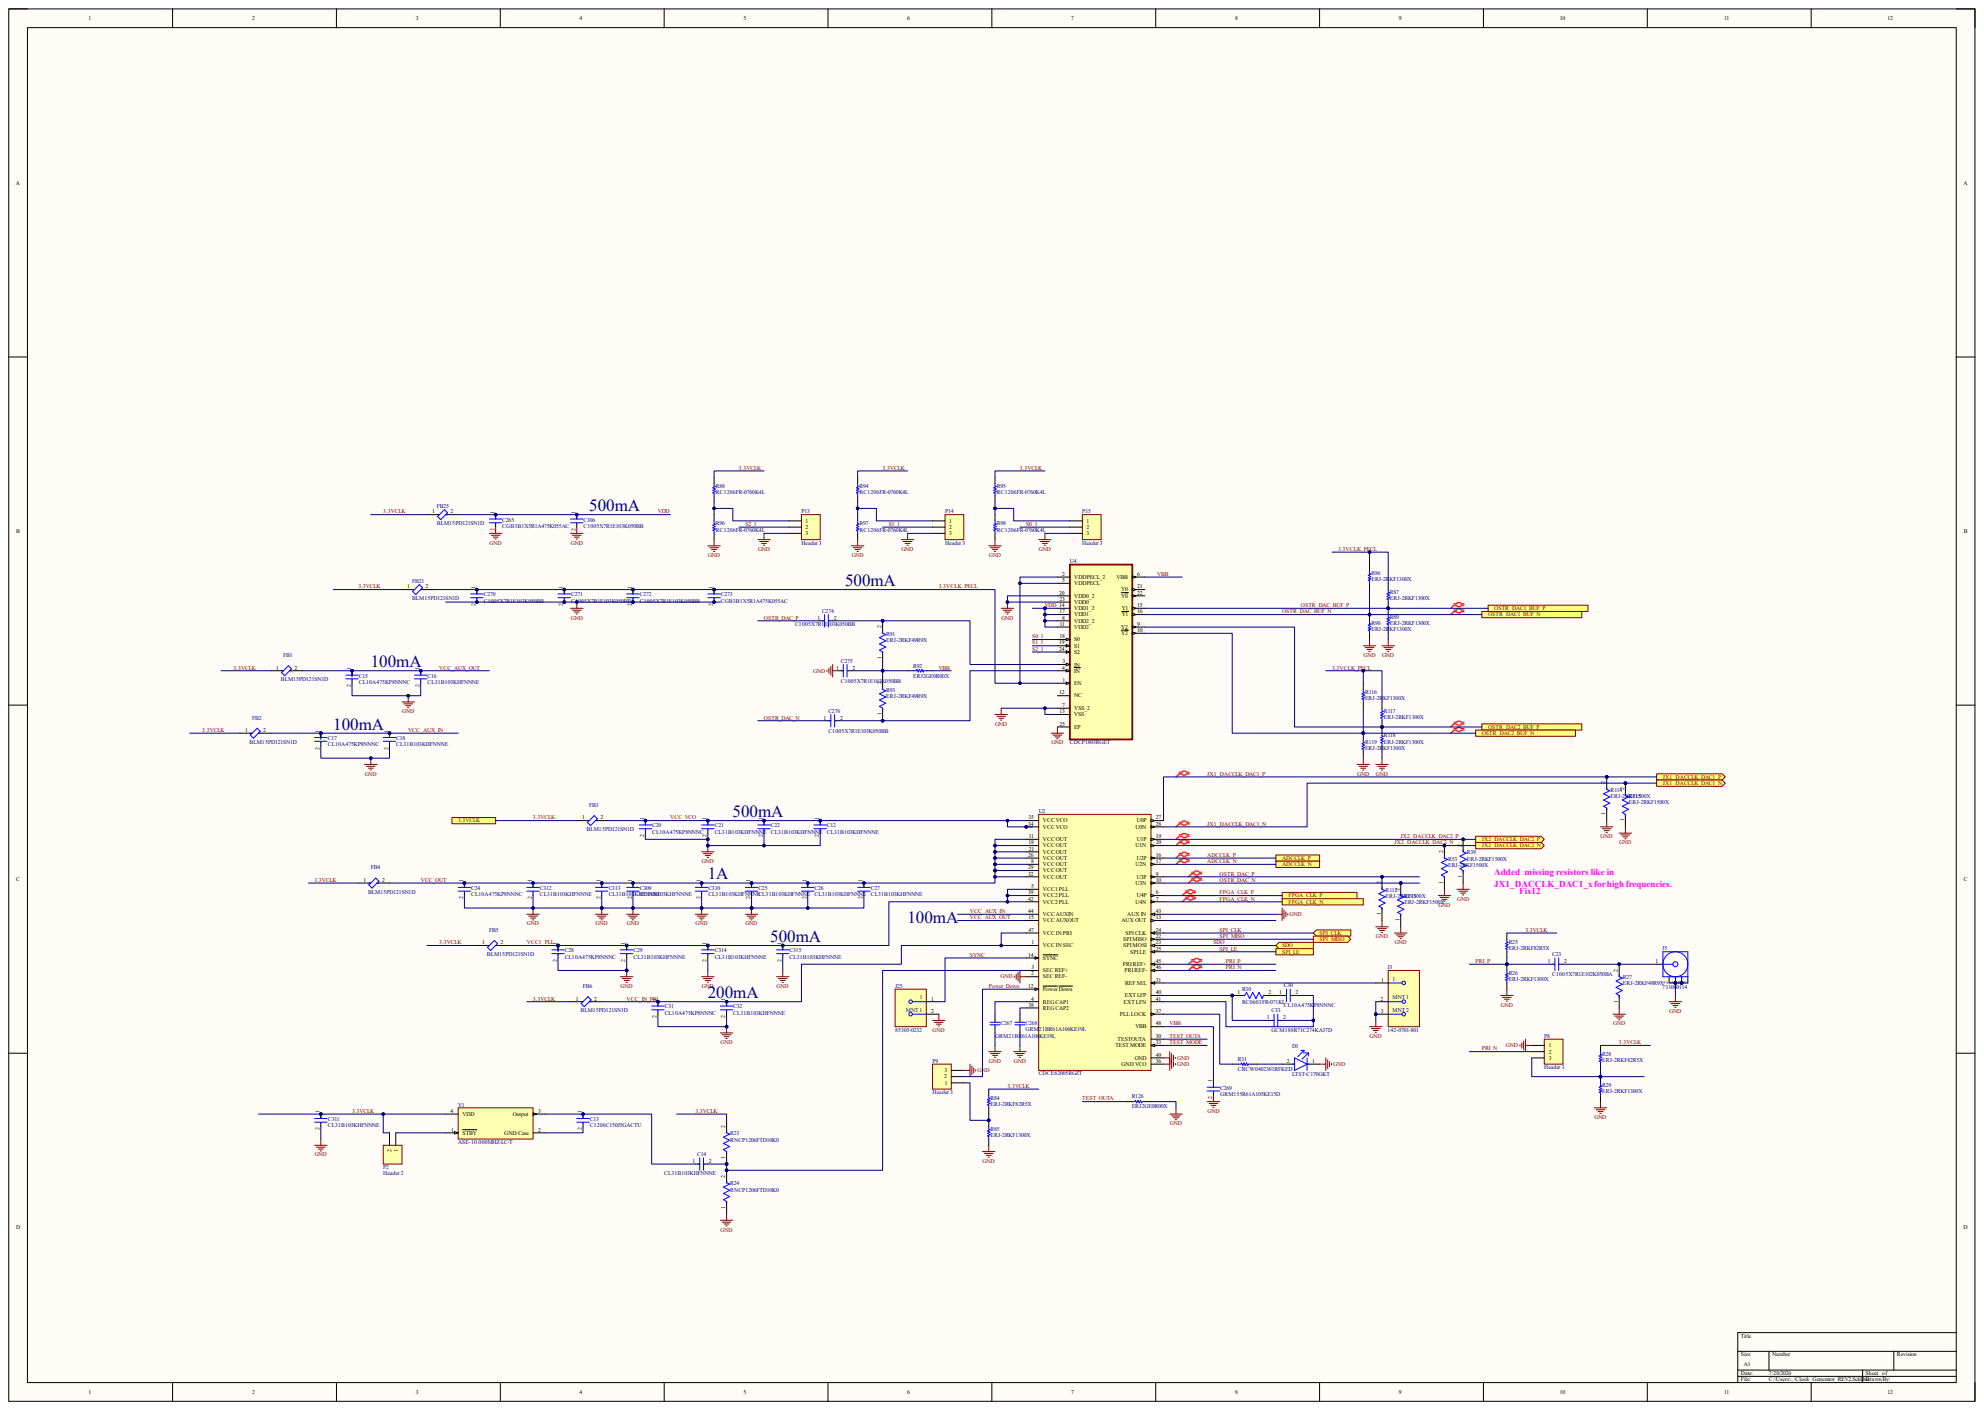
[picture p41: page 2]

Added missing resistors like in
JX1_DACCLK_DAC1_x for high frequencies.
Fix12

A A

5-6-7-8 | 1

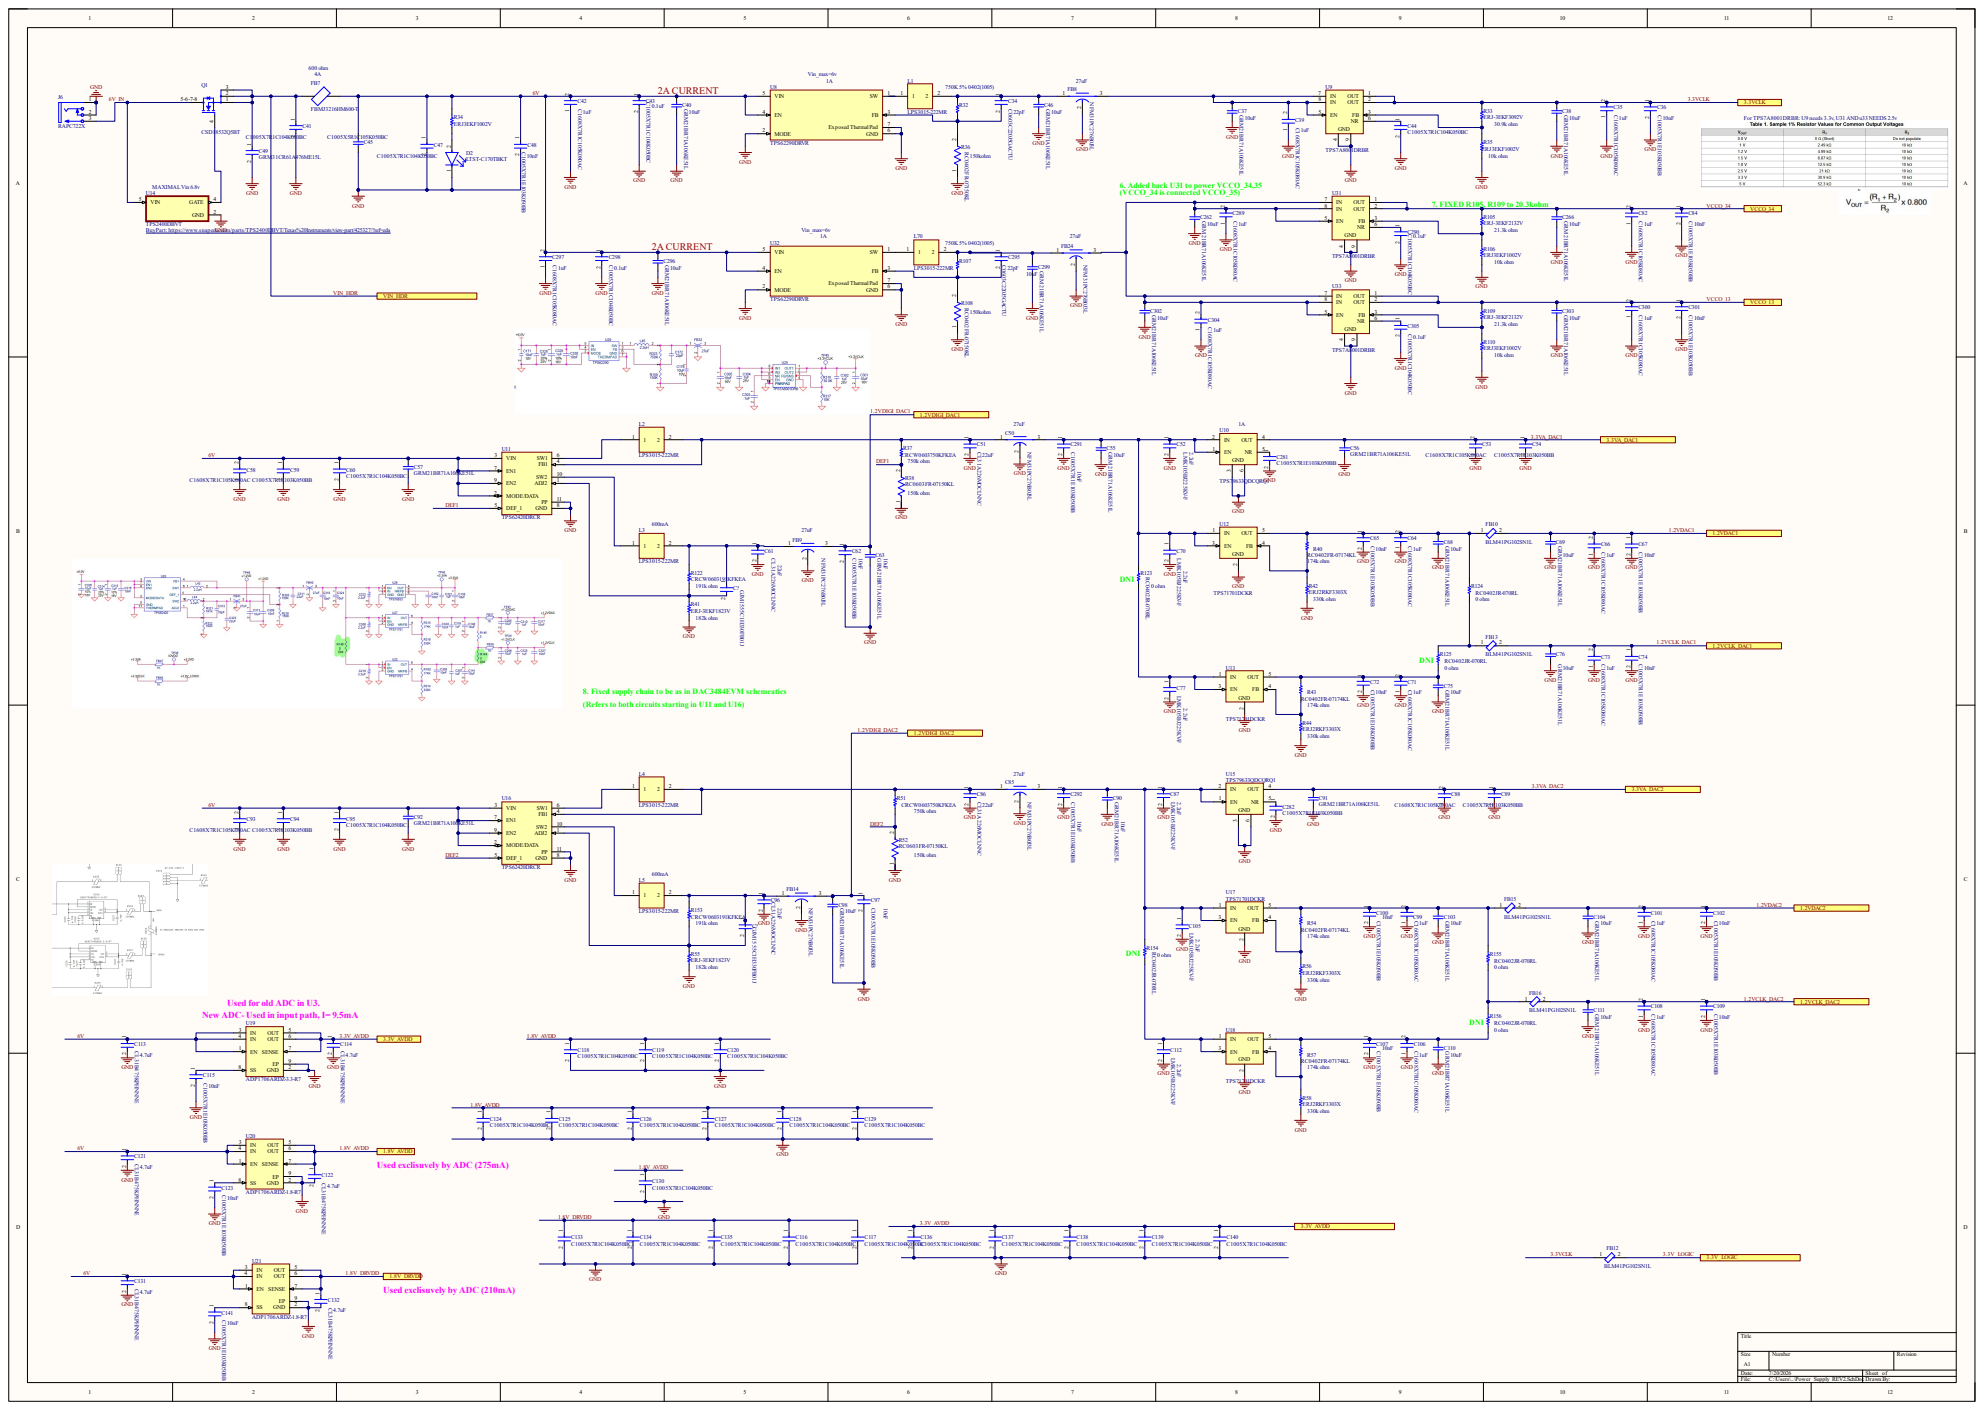
[picture p42: page 3]

For TPS7A8001DRBR: U9 needs 3.3v, U31 AND u33 NEEDS 2.5v

6. Added back U31 to power VCCO_34,35
(VCCO_34 is connected VCCO_35)
C262 GRM21BR71A106KE51L GND

TPS2400DBVT
BuyPart: https://www.snapeda.com/parts/TPS2400DBVT/Texas%20Instruments/view-part/425327/?ref=eda

8. Fixed supply chain to be as in DAC3484EVM schemeatics
(Refers to both circuits starting in U11 and U16)

Used for old ADC in U3.
New ADC- Used in input path, I= 9.5mA

1.8V_AVDD
Used exclisuvely by ADC (275mA)

1.8V_DRVDD
Used exclisuvely by ADC (210mA)
