Tomash1A/FPGAPlatformController/VIVADO- PROJECT BUILDER SCRIPT/projectHW_ADC_build/projectHW/projectHW_wADC.pdf

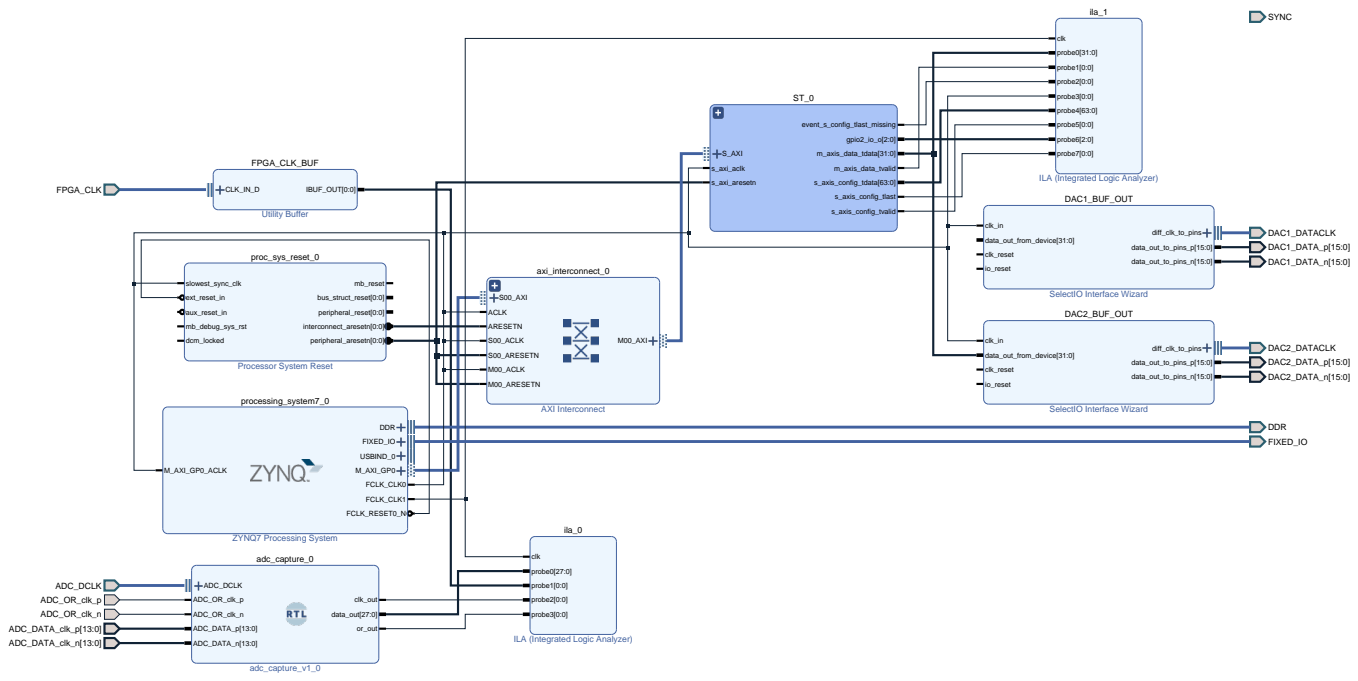
[picture p43: page 1]
ADC_DATA_clk_n[13:0]; ADC_DATA_clk_p[13:0]; ADC_DCLK; DAC1_BUF_OUT; diff_clk_to_pins; data_out_to_pins_p[15:0]; data_out_to_pins_n[15:0]; clk_in; data_out_from_device[31:0]; clk_reset; io_reset; DAC1_DATACLK; DAC1_DATA_n[15:0]; DAC1_DATA_p[15:0]; DAC2_BUF_OUT; DAC2_DATACLK; DAC2_DATA_n[15:0]; DAC2_DATA_p[15:0]; DDR FIXED_IO; FPGA_CLK; FPGA_CLK_BUF; Utility Buffer; CLK_IN_D; IBUF_OUT[0:0]; S_AXI; event_s_config_tlast_missing; gpio2_io_o[2:0] m_axis_data_tdata[31:0]; s_axi_aclk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

ILA (Integrated Logic Analyzer)

SelectIO Interface Wizard

Processor System Reset
