Tomash1A/FPGAPlatformController/(list of files, drawings)

Other design files:
ALTIUM- UPDATED PCB DESIGN/DAC_Sources_original_version/Clock_Generator.SchDoc
ALTIUM- UPDATED PCB DESIGN/DAC_Sources_original_version/DACֹֹ_Sources.PrjPcb
ALTIUM- UPDATED PCB DESIGN/DAC_Sources_original_version/DACֹֹ_Sources.SchDoc
ALTIUM- UPDATED PCB DESIGN/DAC_Sources_original_version/Power_Supply.SchDoc
ALTIUM- UPDATED PCB DESIGN/DAC_Sources_REV/Clock_Generator.SchDoc
ALTIUM- UPDATED PCB DESIGN/DAC_Sources_REV/DACֹֹ_Sources.PrjPcb
ALTIUM- UPDATED PCB DESIGN/DAC_Sources_REV/DACֹֹ_Sources.SchDoc
ALTIUM- UPDATED PCB DESIGN/DAC_Sources_REV/Power_Supply.SchDoc
ALTIUM- UPDATED PCB DESIGN/DACֹֹ_Sources_REV2_FOR_FUTURE_VERSIONS/Clock_Generator_REV2.SchDoc
ALTIUM- UPDATED PCB DESIGN/DACֹֹ_Sources_REV2_FOR_FUTURE_VERSIONS/DACֹֹ_Sources_REV2.PrjPcb
ALTIUM- UPDATED PCB DESIGN/DACֹֹ_Sources_REV2_FOR_FUTURE_VERSIONS/DACֹֹ_Sources_REV2.SchDoc
ALTIUM- UPDATED PCB DESIGN/DACֹֹ_Sources_REV2_FOR_FUTURE_VERSIONS/Power_Supply_REV2.SchDoc
