Tomash1A/FPGAPlatformController/projectHW_ADC_build/constrs/REV.xdc

# ADC Pin Assignments:
set_property IOSTANDARD LVDS_25 [get_ports {ADC_DATA_clk_p[*] ADC_DATA_clk_n[*] ADC_DCLK_clk_p ADC_DCLK_clk_n ADC_OR_clk_p ADC_OR_clk_n}]

set_property IOSTANDARD LVDS_25 [get_ports {ADC_DATA_clk_p[13]}]
set_property IOSTANDARD LVDS_25 [get_ports {ADC_DATA_clk_p[12]}]
set_property IOSTANDARD LVDS_25 [get_ports {ADC_DATA_clk_p[11]}]
set_property IOSTANDARD LVDS_25 [get_ports {ADC_DATA_clk_p[10]}]
set_property IOSTANDARD LVDS_25 [get_ports {ADC_DATA_clk_p[9]}]
set_property IOSTANDARD LVDS_25 [get_ports {ADC_DATA_clk_p[8]}]
set_property IOSTANDARD LVDS_25 [get_ports {ADC_DATA_clk_p[7]}]
set_property IOSTANDARD LVDS_25 [get_ports {ADC_DATA_clk_p[6]}]
set_property IOSTANDARD LVDS_25 [get_ports {ADC_DATA_clk_p[5]}]
set_property IOSTANDARD LVDS_25 [get_ports {ADC_DATA_clk_p[4]}]
set_property IOSTANDARD LVDS_25 [get_ports {ADC_DATA_clk_p[3]}]
set_property IOSTANDARD LVDS_25 [get_ports {ADC_DATA_clk_p[2]}]
set_property IOSTANDARD LVDS_25 [get_ports {ADC_DATA_clk_p[1]}]
set_property IOSTANDARD LVDS_25 [get_ports {ADC_DATA_clk_p[0]}]

set_property IOSTANDARD LVDS_25 [get_ports {ADC_DATA_clk_n[13]}]
set_property IOSTANDARD LVDS_25 [get_ports {ADC_DATA_clk_n[12]}]
set_property IOSTANDARD LVDS_25 [get_ports {ADC_DATA_clk_n[11]}]
set_property IOSTANDARD LVDS_25 [get_ports {ADC_DATA_clk_n[10]}]
set_property IOSTANDARD LVDS_25 [get_ports {ADC_DATA_clk_n[9]}]
set_property IOSTANDARD LVDS_25 [get_ports {ADC_DATA_clk_n[8]}]
set_property IOSTANDARD LVDS_25 [get_ports {ADC_DATA_clk_n[7]}]
set_property IOSTANDARD LVDS_25 [get_ports {ADC_DATA_clk_n[6]}]
set_property IOSTANDARD LVDS_25 [get_ports {ADC_DATA_clk_n[5]}]
set_property IOSTANDARD LVDS_25 [get_ports {ADC_DATA_clk_n[4]}]
set_property IOSTANDARD LVDS_25 [get_ports {ADC_DATA_clk_n[3]}]
set_property IOSTANDARD LVDS_25 [get_ports {ADC_DATA_clk_n[2]}]
set_property IOSTANDARD LVDS_25 [get_ports {ADC_DATA_clk_n[1]}]
set_property IOSTANDARD LVDS_25 [get_ports {ADC_DATA_clk_n[0]}]
set_property IOSTANDARD LVDS_25 [get_ports ADC_DCLK_clk_p]
set_property IOSTANDARD LVDS_25 [get_ports ADC_DCLK_clk_n]
set_property IOSTANDARD LVDS_25 [get_ports ADC_OR_clk_p]
set_property IOSTANDARD LVDS_25 [get_ports ADC_OR_clk_n]

set_property PACKAGE_PIN L16 [get_ports {ADC_DATA_clk_p[13]}]
set_property PACKAGE_PIN L17 [get_ports {ADC_DATA_clk_n[13]}]
set_property PACKAGE_PIN H16 [get_ports {ADC_DATA_clk_p[12]}]
set_property PACKAGE_PIN H17 [get_ports {ADC_DATA_clk_n[12]}]
set_property PACKAGE_PIN G17 [get_ports {ADC_DATA_clk_p[11]}]
set_property PACKAGE_PIN G18 [get_ports {ADC_DATA_clk_n[11]}]
set_property PACKAGE_PIN G19 [get_ports {ADC_DATA_clk_p[10]}]
set_property PACKAGE_PIN G20 [get_ports {ADC_DATA_clk_n[10]}]
set_property PACKAGE_PIN W14 [get_ports {ADC_DATA_clk_p[9]}]
set_property PACKAGE_PIN Y14 [get_ports {ADC_DATA_clk_n[9]}]
set_property PACKAGE_PIN U18 [get_ports {ADC_DATA_clk_p[8]}]
set_property PACKAGE_PIN U19 [get_ports {ADC_DATA_clk_n[8]}]
set_property PACKAGE_PIN V20 [get_ports {ADC_DATA_clk_p[7]}]
set_property PACKAGE_PIN W20 [get_ports {ADC_DATA_clk_n[7]}]
set_property PACKAGE_PIN V16 [get_ports {ADC_DATA_clk_p[6]}]
set_property PACKAGE_PIN W16 [get_ports {ADC_DATA_clk_n[6]}]
set_property PACKAGE_PIN U7 [get_ports {ADC_DATA_clk_p[5]}]
set_property PACKAGE_PIN V7 [get_ports {ADC_DATA_clk_n[5]}]
set_property PACKAGE_PIN V8 [get_ports {ADC_DATA_clk_p[4]}]
set_property PACKAGE_PIN W8 [get_ports {ADC_DATA_clk_n[4]}]
set_property PACKAGE_PIN T9 [get_ports {ADC_DATA_clk_p[3]}]
set_property PACKAGE_PIN U10 [get_ports {ADC_DATA_clk_n[3]}]
set_property PACKAGE_PIN T5 [get_ports {ADC_DATA_clk_p[2]}]
set_property PACKAGE_PIN U5 [get_ports {ADC_DATA_clk_n[2]}]
set_property PACKAGE_PIN Y12 [get_ports {ADC_DATA_clk_p[1]}]
set_property PACKAGE_PIN Y13 [get_ports {ADC_DATA_clk_n[1]}]
set_property PACKAGE_PIN V6 [get_ports {ADC_DATA_clk_p[0]}]
set_property PACKAGE_PIN W6 [get_ports {ADC_DATA_clk_n[0]}]
set_property PACKAGE_PIN K17 [get_ports ADC_DCLK_clk_p]
set_property PACKAGE_PIN K18 [get_ports ADC_DCLK_clk_n]
set_property PACKAGE_PIN N18 [get_ports ADC_OR_clk_p]
set_property PACKAGE_PIN P19 [get_ports ADC_OR_clk_n]


# DAC1 LVDS Pins Assignments
set_property IOSTANDARD LVDS_25 [get_ports {DAC1_DATA_p[15]}]
set_property IOSTANDARD LVDS_25 [get_ports {DAC1_DATA_p[14]}]
set_property IOSTANDARD LVDS_25 [get_ports {DAC1_DATA_p[13]}]
set_property IOSTANDARD LVDS_25 [get_ports {DAC1_DATA_p[12]}]
set_property IOSTANDARD LVDS_25 [get_ports {DAC1_DATA_p[11]}]
set_property IOSTANDARD LVDS_25 [get_ports {DAC1_DATA_p[10]}]
set_property IOSTANDARD LVDS_25 [get_ports {DAC1_DATA_p[9]}]
set_property IOSTANDARD LVDS_25 [get_ports {DAC1_DATA_p[8]}]
set_property IOSTANDARD LVDS_25 [get_ports {DAC1_DATA_p[7]}]
set_property IOSTANDARD LVDS_25 [get_ports {DAC1_DATA_p[6]}]
set_property IOSTANDARD LVDS_25 [get_ports {DAC1_DATA_p[5]}]
set_property IOSTANDARD LVDS_25 [get_ports {DAC1_DATA_p[4]}]
set_property IOSTANDARD LVDS_25 [get_ports {DAC1_DATA_p[3]}]
set_property IOSTANDARD LVDS_25 [get_ports {DAC1_DATA_p[2]}]
set_property IOSTANDARD LVDS_25 [get_ports {DAC1_DATA_p[1]}]
set_property IOSTANDARD LVDS_25 [get_ports {DAC1_DATA_p[0]}]
set_property IOSTANDARD LVDS_25 [get_ports {DAC1_DATA_n[15]}]
set_property IOSTANDARD LVDS_25 [get_ports {DAC1_DATA_n[14]}]
set_property IOSTANDARD LVDS_25 [get_ports {DAC1_DATA_n[13]}]
set_property IOSTANDARD LVDS_25 [get_ports {DAC1_DATA_n[12]}]
set_property IOSTANDARD LVDS_25 [get_ports {DAC1_DATA_n[11]}]
set_property IOSTANDARD LVDS_25 [get_ports {DAC1_DATA_n[10]}]
set_property IOSTANDARD LVDS_25 [get_ports {DAC1_DATA_n[9]}]
set_property IOSTANDARD LVDS_25 [get_ports {DAC1_DATA_n[8]}]
set_property IOSTANDARD LVDS_25 [get_ports {DAC1_DATA_n[7]}]
set_property IOSTANDARD LVDS_25 [get_ports {DAC1_DATA_n[6]}]
set_property IOSTANDARD LVDS_25 [get_ports {DAC1_DATA_n[5]}]
set_property IOSTANDARD LVDS_25 [get_ports {DAC1_DATA_n[4]}]
set_property IOSTANDARD LVDS_25 [get_ports {DAC1_DATA_n[3]}]
set_property IOSTANDARD LVDS_25 [get_ports {DAC1_DATA_n[2]}]
set_property IOSTANDARD LVDS_25 [get_ports {DAC1_DATA_n[1]}]
set_property IOSTANDARD LVDS_25 [get_ports {DAC1_DATA_n[0]}]
set_property IOSTANDARD LVDS_25 [get_ports DAC1_DATACLK_clk_p]
set_property IOSTANDARD LVDS_25 [get_ports DAC1_DATACLK_clk_n]
set_property PACKAGE_PIN C20 [get_ports {DAC1_DATA_p[0]}]
set_property PACKAGE_PIN B20 [get_ports {DAC1_DATA_n[0]}]
set_property PACKAGE_PIN E17 [get_ports {DAC1_DATA_p[1]}]
set_property PACKAGE_PIN D18 [get_ports {DAC1_DATA_n[1]}]
set_property PACKAGE_PIN E18 [get_ports {DAC1_DATA_p[2]}]
set_property PACKAGE_PIN E19 [get_ports {DAC1_DATA_n[2]}]
set_property PACKAGE_PIN B19 [get_ports {DAC1_DATA_p[3]}]
set_property PACKAGE_PIN A20 [get_ports {DAC1_DATA_n[3]}]
set_property PACKAGE_PIN D19 [get_ports {DAC1_DATA_p[4]}]
set_property PACKAGE_PIN D20 [get_ports {DAC1_DATA_n[4]}]
set_property PACKAGE_PIN F16 [get_ports {DAC1_DATA_p[5]}]
set_property PACKAGE_PIN F17 [get_ports {DAC1_DATA_n[5]}]
set_property PACKAGE_PIN M19 [get_ports {DAC1_DATA_p[6]}]
set_property PACKAGE_PIN M20 [get_ports {DAC1_DATA_n[6]}]
set_property PACKAGE_PIN K19 [get_ports {DAC1_DATA_p[7]}]
set_property PACKAGE_PIN J19 [get_ports {DAC1_DATA_n[7]}]
set_property PACKAGE_PIN F19 [get_ports {DAC1_DATA_p[8]}]
set_property PACKAGE_PIN F20 [get_ports {DAC1_DATA_n[8]}]
set_property PACKAGE_PIN J20 [get_ports {DAC1_DATA_p[9]}]
set_property PACKAGE_PIN H20 [get_ports {DAC1_DATA_n[9]}]
set_property PACKAGE_PIN H15 [get_ports {DAC1_DATA_p[10]}]
set_property PACKAGE_PIN G15 [get_ports {DAC1_DATA_n[10]}]
set_property PACKAGE_PIN L14 [get_ports {DAC1_DATA_p[11]}]
set_property PACKAGE_PIN L15 [get_ports {DAC1_DATA_n[11]}]
set_property PACKAGE_PIN K16 [get_ports {DAC1_DATA_p[12]}]
set_property PACKAGE_PIN J16 [get_ports {DAC1_DATA_n[12]}]
set_property PACKAGE_PIN K14 [get_ports {DAC1_DATA_p[13]}]
set_property PACKAGE_PIN J14 [get_ports {DAC1_DATA_n[13]}]
set_property PACKAGE_PIN N15 [get_ports {DAC1_DATA_p[14]}]
set_property PACKAGE_PIN N16 [get_ports {DAC1_DATA_n[14]}]
set_property PACKAGE_PIN M14 [get_ports {DAC1_DATA_p[15]}]
set_property PACKAGE_PIN M15 [get_ports {DAC1_DATA_n[15]}]
set_property PACKAGE_PIN J18 [get_ports DAC1_DATACLK_clk_p]
set_property PACKAGE_PIN H18 [get_ports DAC1_DATACLK_clk_n]

# DAC2 LVDS Pins Assignments
set_property IOSTANDARD LVDS_25 [get_ports {DAC2_DATA_p[15]}]
set_property IOSTANDARD LVDS_25 [get_ports {DAC2_DATA_p[14]}]
set_property IOSTANDARD LVDS_25 [get_ports {DAC2_DATA_p[13]}]
set_property IOSTANDARD LVDS_25 [get_ports {DAC2_DATA_p[12]}]
set_property IOSTANDARD LVDS_25 [get_ports {DAC2_DATA_p[11]}]
set_property IOSTANDARD LVDS_25 [get_ports {DAC2_DATA_p[10]}]
set_property IOSTANDARD LVDS_25 [get_ports {DAC2_DATA_p[9]}]
set_property IOSTANDARD LVDS_25 [get_ports {DAC2_DATA_p[8]}]
set_property IOSTANDARD LVDS_25 [get_ports {DAC2_DATA_p[7]}]
set_property IOSTANDARD LVDS_25 [get_ports {DAC2_DATA_p[6]}]
set_property IOSTANDARD LVDS_25 [get_ports {DAC2_DATA_p[5]}]
set_property IOSTANDARD LVDS_25 [get_ports {DAC2_DATA_p[4]}]
set_property IOSTANDARD LVDS_25 [get_ports {DAC2_DATA_p[3]}]
set_property IOSTANDARD LVDS_25 [get_ports {DAC2_DATA_p[2]}]
set_property IOSTANDARD LVDS_25 [get_ports {DAC2_DATA_p[1]}]
set_property IOSTANDARD LVDS_25 [get_ports {DAC2_DATA_p[0]}]
set_property IOSTANDARD LVDS_25 [get_ports {DAC2_DATA_n[15]}]
set_property IOSTANDARD LVDS_25 [get_ports {DAC2_DATA_n[14]}]
set_property IOSTANDARD LVDS_25 [get_ports {DAC2_DATA_n[13]}]
set_property IOSTANDARD LVDS_25 [get_ports {DAC2_DATA_n[12]}]
set_property IOSTANDARD LVDS_25 [get_ports {DAC2_DATA_n[11]}]
set_property IOSTANDARD LVDS_25 [get_ports {DAC2_DATA_n[10]}]
set_property IOSTANDARD LVDS_25 [get_ports {DAC2_DATA_n[9]}]
set_property IOSTANDARD LVDS_25 [get_ports {DAC2_DATA_n[8]}]
set_property IOSTANDARD LVDS_25 [get_ports {DAC2_DATA_n[7]}]
set_property IOSTANDARD LVDS_25 [get_ports {DAC2_DATA_n[6]}]
set_property IOSTANDARD LVDS_25 [get_ports {DAC2_DATA_n[5]}]
set_property IOSTANDARD LVDS_25 [get_ports {DAC2_DATA_n[4]}]
set_property IOSTANDARD LVDS_25 [get_ports {DAC2_DATA_n[3]}]
set_property IOSTANDARD LVDS_25 [get_ports {DAC2_DATA_n[2]}]
set_property IOSTANDARD LVDS_25 [get_ports {DAC2_DATA_n[1]}]
set_property IOSTANDARD LVDS_25 [get_ports {DAC2_DATA_n[0]}]
set_property IOSTANDARD LVDS_25 [get_ports DAC2_DATACLK_clk_p]
set_property IOSTANDARD LVDS_25 [get_ports DAC2_DATACLK_clk_n]
set_property PACKAGE_PIN P15 [get_ports {DAC2_DATA_p[0]}]
set_property PACKAGE_PIN P16 [get_ports {DAC2_DATA_n[0]}]
set_property PACKAGE_PIN W18 [get_ports {DAC2_DATA_p[1]}]
set_property PACKAGE_PIN W19 [get_ports {DAC2_DATA_n[1]}]
set_property PACKAGE_PIN T17 [get_ports {DAC2_DATA_p[2]}]
set_property PACKAGE_PIN R18 [get_ports {DAC2_DATA_n[2]}]
set_property PACKAGE_PIN N17 [get_ports {DAC2_DATA_p[3]}]
set_property PACKAGE_PIN P18 [get_ports {DAC2_DATA_n[3]}]
set_property PACKAGE_PIN V17 [get_ports {DAC2_DATA_p[4]}]
set_property PACKAGE_PIN V18 [get_ports {DAC2_DATA_n[4]}]
set_property PACKAGE_PIN R16 [get_ports {DAC2_DATA_p[5]}]
set_property PACKAGE_PIN R17 [get_ports {DAC2_DATA_n[5]}]
set_property PACKAGE_PIN Y18 [get_ports {DAC2_DATA_p[6]}]
set_property PACKAGE_PIN Y19 [get_ports {DAC2_DATA_n[6]}]
set_property PACKAGE_PIN T20 [get_ports {DAC2_DATA_p[7]}]
set_property PACKAGE_PIN U20 [get_ports {DAC2_DATA_n[7]}]
set_property PACKAGE_PIN T16 [get_ports {DAC2_DATA_p[8]}]
set_property PACKAGE_PIN U17 [get_ports {DAC2_DATA_n[8]}]
set_property PACKAGE_PIN Y16 [get_ports {DAC2_DATA_p[9]}]
set_property PACKAGE_PIN Y17 [get_ports {DAC2_DATA_n[9]}]
set_property PACKAGE_PIN T14 [get_ports {DAC2_DATA_p[10]}]
set_property PACKAGE_PIN T15 [get_ports {DAC2_DATA_n[10]}]
set_property PACKAGE_PIN U13 [get_ports {DAC2_DATA_p[11]}]
set_property PACKAGE_PIN V13 [get_ports {DAC2_DATA_n[11]}]
set_property PACKAGE_PIN T11 [get_ports {DAC2_DATA_p[12]}]
set_property PACKAGE_PIN T10 [get_ports {DAC2_DATA_n[12]}]
set_property PACKAGE_PIN P14 [get_ports {DAC2_DATA_p[13]}]
set_property PACKAGE_PIN R14 [get_ports {DAC2_DATA_n[13]}]
set_property PACKAGE_PIN V12 [get_ports {DAC2_DATA_p[14]}]
set_property PACKAGE_PIN W13 [get_ports {DAC2_DATA_n[14]}]
set_property PACKAGE_PIN T12 [get_ports {DAC2_DATA_p[15]}]
set_property PACKAGE_PIN U12 [get_ports {DAC2_DATA_n[15]}]
set_property PACKAGE_PIN U14 [get_ports DAC2_DATACLK_clk_p]
set_property PACKAGE_PIN U15 [get_ports DAC2_DATACLK_clk_n]



#set_property IOSTANDARD LVCMOS25 [get_ports {ProfileAddr_CH1[1]}]
#set_property IOSTANDARD LVCMOS25 [get_ports {ProfileAddr_CH1[0]}]
#set_property IOSTANDARD LVCMOS25 [get_ports {ProfileAddr_CH2[1]}]
#set_property IOSTANDARD LVCMOS25 [get_ports {ProfileAddr_CH2[0]}]
#set_property IOSTANDARD LVCMOS25 [get_ports {ProfileAddr_CH3[1]}]
#set_property IOSTANDARD LVCMOS25 [get_ports {ProfileAddr_CH3[0]}]
#set_property IOSTANDARD LVCMOS25 [get_ports {ProfileAddr_CH4[1]}]
#set_property IOSTANDARD LVCMOS25 [get_ports {ProfileAddr_CH4[0]}]
#set_property IOSTANDARD LVCMOS25 [get_ports AM_onoff_CH1]
#set_property IOSTANDARD LVCMOS25 [get_ports AM_onoff_CH2]
#set_property IOSTANDARD LVCMOS25 [get_ports AM_onoff_CH3]
#set_property IOSTANDARD LVCMOS25 [get_ports AM_onoff_CH4]


#set_property PACKAGE_PIN L19 [get_ports AM_onoff_CH1]
#set_property PACKAGE_PIN L20 [get_ports {ProfileAddr_CH1[1]}]
#set_property PACKAGE_PIN M17 [get_ports {ProfileAddr_CH1[0]}]

#set_property PACKAGE_PIN M18 [get_ports AM_onoff_CH2]
#set_property PACKAGE_PIN L16 [get_ports {ProfileAddr_CH2[1]}]
#set_property PACKAGE_PIN L17 [get_ports {ProfileAddr_CH2[0]}]

#set_property PACKAGE_PIN H16 [get_ports AM_onoff_CH3]
#set_property PACKAGE_PIN H17 [get_ports {ProfileAddr_CH3[1]}]
#set_property PACKAGE_PIN G17 [get_ports {ProfileAddr_CH3[0]}]

#set_property PACKAGE_PIN G18 [get_ports AM_onoff_CH4]
#set_property PACKAGE_PIN G19 [get_ports {ProfileAddr_CH4[1]}]
#set_property PACKAGE_PIN G20 [get_ports {ProfileAddr_CH4[0]}]





# Additional LVDS Pin Assignments
set_property IOSTANDARD LVDS_25 [get_ports {FPGA_CLK_clk_p[0]}]
set_property IOSTANDARD LVDS_25 [get_ports {FPGA_CLK_clk_n[0]}]
set_property PACKAGE_PIN N20 [get_ports {FPGA_CLK_clk_p[0]}]
set_property PACKAGE_PIN P20 [get_ports {FPGA_CLK_clk_n[0]}]



set_property C_CLK_INPUT_FREQ_HZ 300000000 [get_debug_cores dbg_hub]
set_property C_ENABLE_CLK_DIVIDER false [get_debug_cores dbg_hub]
set_property C_USER_SCAN_CHAIN 1 [get_debug_cores dbg_hub]
connect_debug_port dbg_hub/clk [get_nets clk]
