Tomash1A/FPGAPlatformController/VIVADO- PROJECT BUILDER SCRIPT/projectHW_ADC_build/adc/adc.runs/projectHW_processing_system7_0_0_synth_1/.Xil/projectHW_processing_system7_0_0_propImpl.xdc

set_property SRC_FILE_INFO {cfile:c:/Users/shtomer/WIS_work/WIP/build_Test/projectHW_ADC_build/adc/adc.gen/sources_1/bd/projectHW/ip/projectHW_processing_system7_0_0/projectHW_processing_system7_0_0.xdc rfile:../../../adc.gen/sources_1/bd/projectHW/ip/projectHW_processing_system7_0_0/projectHW_processing_system7_0_0.xdc id:1 order:EARLY scoped_inst:inst} [current_design]
current_instance inst
set_property src_info {type:SCOPED_XDC file:1 line:21 export:INPUT save:INPUT read:READ} [current_design]
set_input_jitter clk_fpga_1 0.12
set_property src_info {type:SCOPED_XDC file:1 line:24 export:INPUT save:INPUT read:READ} [current_design]
set_input_jitter clk_fpga_0 0.24
set_property src_info {type:SCOPED_XDC file:1 line:34 export:INPUT save:INPUT read:READ} [current_design]
set_property PACKAGE_PIN "C11" [get_ports "MIO[53]"]
set_property src_info {type:SCOPED_XDC file:1 line:41 export:INPUT save:INPUT read:READ} [current_design]
set_property PACKAGE_PIN "C10" [get_ports "MIO[52]"]
set_property src_info {type:SCOPED_XDC file:1 line:48 export:INPUT save:INPUT read:READ} [current_design]
set_property PACKAGE_PIN "B9" [get_ports "MIO[51]"]
set_property src_info {type:SCOPED_XDC file:1 line:55 export:INPUT save:INPUT read:READ} [current_design]
set_property PACKAGE_PIN "B13" [get_ports "MIO[50]"]
set_property src_info {type:SCOPED_XDC file:1 line:62 export:INPUT save:INPUT read:READ} [current_design]
set_property PACKAGE_PIN "C12" [get_ports "MIO[49]"]
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
set_property PACKAGE_PIN "B7" [get_ports "MIO[4]"]
set_property src_info {type:SCOPED_XDC file:1 line:377 export:INPUT save:INPUT read:READ} [current_design]
set_property PACKAGE_PIN "D6" [get_ports "MIO[3]"]
set_property src_info {type:SCOPED_XDC file:1 line:383 export:INPUT save:INPUT read:READ} [current_design]
set_property PACKAGE_PIN "B8" [get_ports "MIO[2]"]
set_property src_info {type:SCOPED_XDC file:1 line:389 export:INPUT save:INPUT read:READ} [current_design]
set_property PACKAGE_PIN "A7" [get_ports "MIO[1]"]
set_property src_info {type:SCOPED_XDC file:1 line:396 export:INPUT save:INPUT read:READ} [current_design]
set_property PACKAGE_PIN "E6" [get_ports "MIO[0]"]
set_property src_info {type:SCOPED_XDC file:1 line:402 export:INPUT save:INPUT read:READ} [current_design]
set_property PACKAGE_PIN "H5" [get_ports "DDR_VRP"]
set_property src_info {type:SCOPED_XDC file:1 line:406 export:INPUT save:INPUT read:READ} [current_design]
set_property PACKAGE_PIN "G5" [get_ports "DDR_VRN"]
set_property src_info {type:SCOPED_XDC file:1 line:410 export:INPUT save:INPUT read:READ} [current_design]
set_property PACKAGE_PIN "M5" [get_ports "DDR_WEB"]
set_property src_info {type:SCOPED_XDC file:1 line:414 export:INPUT save:INPUT read:READ} [current_design]
set_property PACKAGE_PIN "P4" [get_ports "DDR_RAS_n"]
set_property src_info {type:SCOPED_XDC file:1 line:418 export:INPUT save:INPUT read:READ} [current_design]
set_property PACKAGE_PIN "N5" [get_ports "DDR_ODT"]
set_property src_info {type:SCOPED_XDC file:1 line:422 export:INPUT save:INPUT read:READ} [current_design]
set_property PACKAGE_PIN "B4" [get_ports "DDR_DRSTB"]
set_property src_info {type:SCOPED_XDC file:1 line:426 export:INPUT save:INPUT read:READ} [current_design]
set_property PACKAGE_PIN "W5" [get_ports "DDR_DQS[3]"]
set_property src_info {type:SCOPED_XDC file:1 line:430 export:INPUT save:INPUT read:READ} [current_design]
set_property PACKAGE_PIN "R2" [get_ports "DDR_DQS[2]"]
set_property src_info {type:SCOPED_XDC file:1 line:434 export:INPUT save:INPUT read:READ} [current_design]
set_property PACKAGE_PIN "G2" [get_ports "DDR_DQS[1]"]
set_property src_info {type:SCOPED_XDC file:1 line:438 export:INPUT save:INPUT read:READ} [current_design]
set_property PACKAGE_PIN "C2" [get_ports "DDR_DQS[0]"]
set_property src_info {type:SCOPED_XDC file:1 line:442 export:INPUT save:INPUT read:READ} [current_design]
set_property PACKAGE_PIN "W4" [get_ports "DDR_DQS_n[3]"]
set_property src_info {type:SCOPED_XDC file:1 line:446 export:INPUT save:INPUT read:READ} [current_design]
set_property PACKAGE_PIN "T2" [get_ports "DDR_DQS_n[2]"]
set_property src_info {type:SCOPED_XDC file:1 line:450 export:INPUT save:INPUT read:READ} [current_design]
set_property PACKAGE_PIN "F2" [get_ports "DDR_DQS_n[1]"]
set_property src_info {type:SCOPED_XDC file:1 line:454 export:INPUT save:INPUT read:READ} [current_design]
set_property PACKAGE_PIN "B2" [get_ports "DDR_DQS_n[0]"]
set_property src_info {type:SCOPED_XDC file:1 line:458 export:INPUT save:INPUT read:READ} [current_design]
set_property PACKAGE_PIN "E3" [get_ports "DDR_DQ[9]"]
set_property src_info {type:SCOPED_XDC file:1 line:462 export:INPUT save:INPUT read:READ} [current_design]
set_property PACKAGE_PIN "E2" [get_ports "DDR_DQ[8]"]
set_property src_info {type:SCOPED_XDC file:1 line:466 export:INPUT save:INPUT read:READ} [current_design]
set_property PACKAGE_PIN "E1" [get_ports "DDR_DQ[7]"]
set_property src_info {type:SCOPED_XDC file:1 line:470 export:INPUT save:INPUT read:READ} [current_design]
set_property PACKAGE_PIN "C1" [get_ports "DDR_DQ[6]"]
set_property src_info {type:SCOPED_XDC file:1 line:474 export:INPUT save:INPUT read:READ} [current_design]
set_property PACKAGE_PIN "D1" [get_ports "DDR_DQ[5]"]
set_property src_info {type:SCOPED_XDC file:1 line:478 export:INPUT save:INPUT read:READ} [current_design]
set_property PACKAGE_PIN "D3" [get_ports "DDR_DQ[4]"]
set_property src_info {type:SCOPED_XDC file:1 line:482 export:INPUT save:INPUT read:READ} [current_design]
set_property PACKAGE_PIN "A4" [get_ports "DDR_DQ[3]"]
set_property src_info {type:SCOPED_XDC file:1 line:486 export:INPUT save:INPUT read:READ} [current_design]
set_property PACKAGE_PIN "V3" [get_ports "DDR_DQ[31]"]
set_property src_info {type:SCOPED_XDC file:1 line:490 export:INPUT save:INPUT read:READ} [current_design]
set_property PACKAGE_PIN "V2" [get_ports "DDR_DQ[30]"]
set_property src_info {type:SCOPED_XDC file:1 line:494 export:INPUT save:INPUT read:READ} [current_design]
set_property PACKAGE_PIN "A2" [get_ports "DDR_DQ[2]"]
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
set_property PACKAGE_PIN "A1" [get_ports "DDR_DM[0]"]
set_property src_info {type:SCOPED_XDC file:1 line:602 export:INPUT save:INPUT read:READ} [current_design]
set_property PACKAGE_PIN "N1" [get_ports "DDR_CS_n"]
set_property src_info {type:SCOPED_XDC file:1 line:606 export:INPUT save:INPUT read:READ} [current_design]
set_property PACKAGE_PIN "N3" [get_ports "DDR_CKE"]
set_property src_info {type:SCOPED_XDC file:1 line:610 export:INPUT save:INPUT read:READ} [current_design]
set_property PACKAGE_PIN "L2" [get_ports "DDR_Clk"]
set_property src_info {type:SCOPED_XDC file:1 line:614 export:INPUT save:INPUT read:READ} [current_design]
set_property PACKAGE_PIN "M2" [get_ports "DDR_Clk_n"]
set_property src_info {type:SCOPED_XDC file:1 line:618 export:INPUT save:INPUT read:READ} [current_design]
set_property PACKAGE_PIN "P5" [get_ports "DDR_CAS_n"]
set_property src_info {type:SCOPED_XDC file:1 line:622 export:INPUT save:INPUT read:READ} [current_design]
set_property PACKAGE_PIN "J5" [get_ports "DDR_BankAddr[2]"]
set_property src_info {type:SCOPED_XDC file:1 line:626 export:INPUT save:INPUT read:READ} [current_design]
set_property PACKAGE_PIN "R4" [get_ports "DDR_BankAddr[1]"]
set_property src_info {type:SCOPED_XDC file:1 line:630 export:INPUT save:INPUT read:READ} [current_design]
set_property PACKAGE_PIN "L5" [get_ports "DDR_BankAddr[0]"]
set_property src_info {type:SCOPED_XDC file:1 line:634 export:INPUT save:INPUT read:READ} [current_design]
set_property PACKAGE_PIN "J4" [get_ports "DDR_Addr[9]"]
set_property src_info {type:SCOPED_XDC file:1 line:638 export:INPUT save:INPUT read:READ} [current_design]
set_property PACKAGE_PIN "K1" [get_ports "DDR_Addr[8]"]
set_property src_info {type:SCOPED_XDC file:1 line:642 export:INPUT save:INPUT read:READ} [current_design]
set_property PACKAGE_PIN "K4" [get_ports "DDR_Addr[7]"]
set_property src_info {type:SCOPED_XDC file:1 line:646 export:INPUT save:INPUT read:READ} [current_design]
set_property PACKAGE_PIN "L4" [get_ports "DDR_Addr[6]"]
set_property src_info {type:SCOPED_XDC file:1 line:650 export:INPUT save:INPUT read:READ} [current_design]
set_property PACKAGE_PIN "L1" [get_ports "DDR_Addr[5]"]
set_property src_info {type:SCOPED_XDC file:1 line:654 export:INPUT save:INPUT read:READ} [current_design]
set_property PACKAGE_PIN "M4" [get_ports "DDR_Addr[4]"]
set_property src_info {type:SCOPED_XDC file:1 line:658 export:INPUT save:INPUT read:READ} [current_design]
set_property PACKAGE_PIN "K3" [get_ports "DDR_Addr[3]"]
set_property src_info {type:SCOPED_XDC file:1 line:662 export:INPUT save:INPUT read:READ} [current_design]
set_property PACKAGE_PIN "M3" [get_ports "DDR_Addr[2]"]
set_property src_info {type:SCOPED_XDC file:1 line:666 export:INPUT save:INPUT read:READ} [current_design]
set_property PACKAGE_PIN "K2" [get_ports "DDR_Addr[1]"]
set_property src_info {type:SCOPED_XDC file:1 line:670 export:INPUT save:INPUT read:READ} [current_design]
set_property PACKAGE_PIN "F4" [get_ports "DDR_Addr[14]"]
set_property src_info {type:SCOPED_XDC file:1 line:674 export:INPUT save:INPUT read:READ} [current_design]
set_property PACKAGE_PIN "D4" [get_ports "DDR_Addr[13]"]
set_property src_info {type:SCOPED_XDC file:1 line:678 export:INPUT save:INPUT read:READ} [current_design]
set_property PACKAGE_PIN "E4" [get_ports "DDR_Addr[12]"]
set_property src_info {type:SCOPED_XDC file:1 line:682 export:INPUT save:INPUT read:READ} [current_design]
set_property PACKAGE_PIN "G4" [get_ports "DDR_Addr[11]"]
set_property src_info {type:SCOPED_XDC file:1 line:686 export:INPUT save:INPUT read:READ} [current_design]
set_property PACKAGE_PIN "F5" [get_ports "DDR_Addr[10]"]
set_property src_info {type:SCOPED_XDC file:1 line:690 export:INPUT save:INPUT read:READ} [current_design]
set_property PACKAGE_PIN "N2" [get_ports "DDR_Addr[0]"]
set_property src_info {type:SCOPED_XDC file:1 line:694 export:INPUT save:INPUT read:READ} [current_design]
set_property PACKAGE_PIN "C7" [get_ports "PS_PORB"]
set_property src_info {type:SCOPED_XDC file:1 line:697 export:INPUT save:INPUT read:READ} [current_design]
set_property PACKAGE_PIN "B10" [get_ports "PS_SRSTB"]
set_property src_info {type:SCOPED_XDC file:1 line:700 export:INPUT save:INPUT read:READ} [current_design]
set_property PACKAGE_PIN "E7" [get_ports "PS_CLK"]
