Tomash1A/FPGAPlatformController/VIVADO- PROJECT BUILDER SCRIPT/projectHW_ADC_build/adc/adc.runs/synth_1/.Xil/projectHW_wrapper_propImpl.xdc

set_property SRC_FILE_INFO {cfile:C:/Users/shtomer/WIS_work/WIP/build_Test/projectHW_ADC_build/constrs/REV.xdc rfile:../../../../constrs/REV.xdc id:1} [current_design]
set_property src_info {type:XDC file:1 line:2 export:INPUT save:INPUT read:READ} [current_design]
set_property IOSTANDARD LVDS_25 [get_ports {ADC_DATA_clk_p[*] ADC_DATA_clk_n[*] ADC_DCLK_clk_p ADC_DCLK_clk_n ADC_OR_clk_p ADC_OR_clk_n}]
set_property src_info {type:XDC file:1 line:3 export:INPUT save:INPUT read:READ} [current_design]
set_property IOSTANDARD LVDS_25 [get_ports {ADC_DATA_B35_clk_p[*] ADC_DATA_B35_clk_n[*]}]
set_property src_info {type:XDC file:1 line:4 export:INPUT save:INPUT read:READ} [current_design]
set_property IOSTANDARD LVDS_25 [get_ports {ADC_DATA_B34_clk_p[*] ADC_DATA_B34_clk_n[*]}]
set_property src_info {type:XDC file:1 line:5 export:INPUT save:INPUT read:READ} [current_design]
set_property IOSTANDARD LVDS_25 [get_ports {ADC_DATA_B13_clk_p[*] ADC_DATA_B13_clk_n[*]}]
set_property src_info {type:XDC file:1 line:7 export:INPUT save:INPUT read:READ} [current_design]
set_property IOSTANDARD LVDS_25 [get_ports {ADC_DATA_B35_clk_p[3]}]
set_property src_info {type:XDC file:1 line:8 export:INPUT save:INPUT read:READ} [current_design]
set_property IOSTANDARD LVDS_25 [get_ports {ADC_DATA_B35_clk_p[2]}]
set_property src_info {type:XDC file:1 line:9 export:INPUT save:INPUT read:READ} [current_design]
set_property IOSTANDARD LVDS_25 [get_ports {ADC_DATA_B35_clk_p[1]}]
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
set_property IOSTANDARD LVDS_25 [get_ports ADC_DCLK_clk_p]
set_property src_info {type:XDC file:1 line:47 export:INPUT save:INPUT read:READ} [current_design]
set_property IOSTANDARD LVDS_25 [get_ports ADC_DCLK_clk_n]
set_property src_info {type:XDC file:1 line:48 export:INPUT save:INPUT read:READ} [current_design]
set_property IOSTANDARD LVDS_25 [get_ports ADC_OR_clk_p]
set_property src_info {type:XDC file:1 line:49 export:INPUT save:INPUT read:READ} [current_design]
set_property IOSTANDARD LVDS_25 [get_ports ADC_OR_clk_n]
set_property src_info {type:XDC file:1 line:51 export:INPUT save:INPUT read:READ} [current_design]
set_property PACKAGE_PIN L16 [get_ports {ADC_DATA_B35_clk_p[3]}]
set_property src_info {type:XDC file:1 line:52 export:INPUT save:INPUT read:READ} [current_design]
set_property PACKAGE_PIN L17 [get_ports {ADC_DATA_B35_clk_n[3]}]
set_property src_info {type:XDC file:1 line:53 export:INPUT save:INPUT read:READ} [current_design]
set_property PACKAGE_PIN H16 [get_ports {ADC_DATA_B35_clk_p[2]}]
set_property src_info {type:XDC file:1 line:54 export:INPUT save:INPUT read:READ} [current_design]
set_property PACKAGE_PIN H17 [get_ports {ADC_DATA_B35_clk_n[2]}]
set_property src_info {type:XDC file:1 line:55 export:INPUT save:INPUT read:READ} [current_design]
set_property PACKAGE_PIN G17 [get_ports {ADC_DATA_B35_clk_p[1]}]
set_property src_info {type:XDC file:1 line:56 export:INPUT save:INPUT read:READ} [current_design]
set_property PACKAGE_PIN G18 [get_ports {ADC_DATA_B35_clk_n[1]}]
set_property src_info {type:XDC file:1 line:57 export:INPUT save:INPUT read:READ} [current_design]
set_property PACKAGE_PIN G19 [get_ports {ADC_DATA_B35_clk_p[0]}]
set_property src_info {type:XDC file:1 line:58 export:INPUT save:INPUT read:READ} [current_design]
set_property PACKAGE_PIN G20 [get_ports {ADC_DATA_B35_clk_n[0]}]
set_property src_info {type:XDC file:1 line:60 export:INPUT save:INPUT read:READ} [current_design]
set_property PACKAGE_PIN W14 [get_ports {ADC_DATA_B34_clk_p[3]}]
set_property src_info {type:XDC file:1 line:61 export:INPUT save:INPUT read:READ} [current_design]
set_property PACKAGE_PIN Y14 [get_ports {ADC_DATA_B34_clk_n[3]}]
set_property src_info {type:XDC file:1 line:62 export:INPUT save:INPUT read:READ} [current_design]
set_property PACKAGE_PIN U18 [get_ports {ADC_DATA_B34_clk_p[2]}]
set_property src_info {type:XDC file:1 line:63 export:INPUT save:INPUT read:READ} [current_design]
set_property PACKAGE_PIN U19 [get_ports {ADC_DATA_B34_clk_n[2]}]
set_property src_info {type:XDC file:1 line:64 export:INPUT save:INPUT read:READ} [current_design]
set_property PACKAGE_PIN V20 [get_ports {ADC_DATA_B34_clk_p[1]}]
set_property src_info {type:XDC file:1 line:65 export:INPUT save:INPUT read:READ} [current_design]
set_property PACKAGE_PIN W20 [get_ports {ADC_DATA_B34_clk_n[1]}]
set_property src_info {type:XDC file:1 line:66 export:INPUT save:INPUT read:READ} [current_design]
set_property PACKAGE_PIN V16 [get_ports {ADC_DATA_B34_clk_p[0]}]
set_property src_info {type:XDC file:1 line:67 export:INPUT save:INPUT read:READ} [current_design]
set_property PACKAGE_PIN W16 [get_ports {ADC_DATA_B34_clk_n[0]}]
set_property src_info {type:XDC file:1 line:69 export:INPUT save:INPUT read:READ} [current_design]
set_property PACKAGE_PIN U7 [get_ports {ADC_DATA_B13_clk_p[5]}]
set_property src_info {type:XDC file:1 line:70 export:INPUT save:INPUT read:READ} [current_design]
set_property PACKAGE_PIN V7 [get_ports {ADC_DATA_B13_clk_n[5]}]
set_property src_info {type:XDC file:1 line:71 export:INPUT save:INPUT read:READ} [current_design]
set_property PACKAGE_PIN V8 [get_ports {ADC_DATA_B13_clk_p[4]}]
set_property src_info {type:XDC file:1 line:72 export:INPUT save:INPUT read:READ} [current_design]
set_property PACKAGE_PIN W8 [get_ports {ADC_DATA_B13_clk_n[4]}]
set_property src_info {type:XDC file:1 line:73 export:INPUT save:INPUT read:READ} [current_design]
set_property PACKAGE_PIN T9 [get_ports {ADC_DATA_B13_clk_p[3]}]
set_property src_info {type:XDC file:1 line:74 export:INPUT save:INPUT read:READ} [current_design]
set_property PACKAGE_PIN U10 [get_ports {ADC_DATA_B13_clk_n[3]}]
set_property src_info {type:XDC file:1 line:75 export:INPUT save:INPUT read:READ} [current_design]
set_property PACKAGE_PIN T5 [get_ports {ADC_DATA_B13_clk_p[2]}]
set_property src_info {type:XDC file:1 line:76 export:INPUT save:INPUT read:READ} [current_design]
set_property PACKAGE_PIN U5 [get_ports {ADC_DATA_B13_clk_n[2]}]
set_property src_info {type:XDC file:1 line:77 export:INPUT save:INPUT read:READ} [current_design]
set_property PACKAGE_PIN Y12 [get_ports {ADC_DATA_B13_clk_p[1]}]
set_property src_info {type:XDC file:1 line:78 export:INPUT save:INPUT read:READ} [current_design]
set_property PACKAGE_PIN Y13 [get_ports {ADC_DATA_B13_clk_n[1]}]
set_property src_info {type:XDC file:1 line:79 export:INPUT save:INPUT read:READ} [current_design]
set_property PACKAGE_PIN V6 [get_ports {ADC_DATA_B13_clk_p[0]}]
set_property src_info {type:XDC file:1 line:80 export:INPUT save:INPUT read:READ} [current_design]
set_property PACKAGE_PIN W6 [get_ports {ADC_DATA_B13_clk_n[0]}]
set_property src_info {type:XDC file:1 line:81 export:INPUT save:INPUT read:READ} [current_design]
set_property PACKAGE_PIN K17 [get_ports ADC_DCLK_clk_p]
set_property src_info {type:XDC file:1 line:82 export:INPUT save:INPUT read:READ} [current_design]
set_property PACKAGE_PIN K18 [get_ports ADC_DCLK_clk_n]
set_property src_info {type:XDC file:1 line:83 export:INPUT save:INPUT read:READ} [current_design]
set_property PACKAGE_PIN N18 [get_ports ADC_OR_clk_p]
set_property src_info {type:XDC file:1 line:84 export:INPUT save:INPUT read:READ} [current_design]
set_property PACKAGE_PIN P19 [get_ports ADC_OR_clk_n]
set_property src_info {type:XDC file:1 line:122 export:INPUT save:INPUT read:READ} [current_design]
set_property PACKAGE_PIN C20 [get_ports {DAC1_DATA_p[0]}]
set_property src_info {type:XDC file:1 line:123 export:INPUT save:INPUT read:READ} [current_design]
set_property PACKAGE_PIN B20 [get_ports {DAC1_DATA_n[0]}]
set_property src_info {type:XDC file:1 line:124 export:INPUT save:INPUT read:READ} [current_design]
set_property PACKAGE_PIN E17 [get_ports {DAC1_DATA_p[1]}]
set_property src_info {type:XDC file:1 line:125 export:INPUT save:INPUT read:READ} [current_design]
set_property PACKAGE_PIN D18 [get_ports {DAC1_DATA_n[1]}]
set_property src_info {type:XDC file:1 line:126 export:INPUT save:INPUT read:READ} [current_design]
set_property PACKAGE_PIN E18 [get_ports {DAC1_DATA_p[2]}]
set_property src_info {type:XDC file:1 line:127 export:INPUT save:INPUT read:READ} [current_design]
set_property PACKAGE_PIN E19 [get_ports {DAC1_DATA_n[2]}]
set_property src_info {type:XDC file:1 line:128 export:INPUT save:INPUT read:READ} [current_design]
set_property PACKAGE_PIN B19 [get_ports {DAC1_DATA_p[3]}]
set_property src_info {type:XDC file:1 line:129 export:INPUT save:INPUT read:READ} [current_design]
set_property PACKAGE_PIN A20 [get_ports {DAC1_DATA_n[3]}]
set_property src_info {type:XDC file:1 line:130 export:INPUT save:INPUT read:READ} [current_design]
set_property PACKAGE_PIN D19 [get_ports {DAC1_DATA_p[4]}]
set_property src_info {type:XDC file:1 line:131 export:INPUT save:INPUT read:READ} [current_design]
set_property PACKAGE_PIN D20 [get_ports {DAC1_DATA_n[4]}]
set_property src_info {type:XDC file:1 line:132 export:INPUT save:INPUT read:READ} [current_design]
set_property PACKAGE_PIN F16 [get_ports {DAC1_DATA_p[5]}]
set_property src_info {type:XDC file:1 line:133 export:INPUT save:INPUT read:READ} [current_design]
set_property PACKAGE_PIN F17 [get_ports {DAC1_DATA_n[5]}]
set_property src_info {type:XDC file:1 line:134 export:INPUT save:INPUT read:READ} [current_design]
set_property PACKAGE_PIN M19 [get_ports {DAC1_DATA_p[6]}]
set_property src_info {type:XDC file:1 line:135 export:INPUT save:INPUT read:READ} [current_design]
set_property PACKAGE_PIN M20 [get_ports {DAC1_DATA_n[6]}]
set_property src_info {type:XDC file:1 line:136 export:INPUT save:INPUT read:READ} [current_design]
set_property PACKAGE_PIN K19 [get_ports {DAC1_DATA_p[7]}]
set_property src_info {type:XDC file:1 line:137 export:INPUT save:INPUT read:READ} [current_design]
set_property PACKAGE_PIN J19 [get_ports {DAC1_DATA_n[7]}]
set_property src_info {type:XDC file:1 line:138 export:INPUT save:INPUT read:READ} [current_design]
set_property PACKAGE_PIN F19 [get_ports {DAC1_DATA_p[8]}]
set_property src_info {type:XDC file:1 line:139 export:INPUT save:INPUT read:READ} [current_design]
set_property PACKAGE_PIN F20 [get_ports {DAC1_DATA_n[8]}]
set_property src_info {type:XDC file:1 line:140 export:INPUT save:INPUT read:READ} [current_design]
set_property PACKAGE_PIN J20 [get_ports {DAC1_DATA_p[9]}]
set_property src_info {type:XDC file:1 line:141 export:INPUT save:INPUT read:READ} [current_design]
set_property PACKAGE_PIN H20 [get_ports {DAC1_DATA_n[9]}]
set_property src_info {type:XDC file:1 line:142 export:INPUT save:INPUT read:READ} [current_design]
set_property PACKAGE_PIN H15 [get_ports {DAC1_DATA_p[10]}]
set_property src_info {type:XDC file:1 line:143 export:INPUT save:INPUT read:READ} [current_design]
set_property PACKAGE_PIN G15 [get_ports {DAC1_DATA_n[10]}]
set_property src_info {type:XDC file:1 line:144 export:INPUT save:INPUT read:READ} [current_design]
set_property PACKAGE_PIN L14 [get_ports {DAC1_DATA_p[11]}]
set_property src_info {type:XDC file:1 line:145 export:INPUT save:INPUT read:READ} [current_design]
set_property PACKAGE_PIN L15 [get_ports {DAC1_DATA_n[11]}]
set_property src_info {type:XDC file:1 line:146 export:INPUT save:INPUT read:READ} [current_design]
set_property PACKAGE_PIN K16 [get_ports {DAC1_DATA_p[12]}]
set_property src_info {type:XDC file:1 line:147 export:INPUT save:INPUT read:READ} [current_design]
set_property PACKAGE_PIN J16 [get_ports {DAC1_DATA_n[12]}]
set_property src_info {type:XDC file:1 line:148 export:INPUT save:INPUT read:READ} [current_design]
set_property PACKAGE_PIN K14 [get_ports {DAC1_DATA_p[13]}]
set_property src_info {type:XDC file:1 line:149 export:INPUT save:INPUT read:READ} [current_design]
set_property PACKAGE_PIN J14 [get_ports {DAC1_DATA_n[13]}]
set_property src_info {type:XDC file:1 line:150 export:INPUT save:INPUT read:READ} [current_design]
set_property PACKAGE_PIN N15 [get_ports {DAC1_DATA_p[14]}]
set_property src_info {type:XDC file:1 line:151 export:INPUT save:INPUT read:READ} [current_design]
set_property PACKAGE_PIN N16 [get_ports {DAC1_DATA_n[14]}]
set_property src_info {type:XDC file:1 line:152 export:INPUT save:INPUT read:READ} [current_design]
set_property PACKAGE_PIN M14 [get_ports {DAC1_DATA_p[15]}]
set_property src_info {type:XDC file:1 line:153 export:INPUT save:INPUT read:READ} [current_design]
set_property PACKAGE_PIN M15 [get_ports {DAC1_DATA_n[15]}]
set_property src_info {type:XDC file:1 line:154 export:INPUT save:INPUT read:READ} [current_design]
set_property PACKAGE_PIN J18 [get_ports DAC1_DATACLK_clk_p]
set_property src_info {type:XDC file:1 line:155 export:INPUT save:INPUT read:READ} [current_design]
set_property PACKAGE_PIN H18 [get_ports DAC1_DATACLK_clk_n]
set_property src_info {type:XDC file:1 line:192 export:INPUT save:INPUT read:READ} [current_design]
set_property PACKAGE_PIN P15 [get_ports {DAC2_DATA_p[0]}]
set_property src_info {type:XDC file:1 line:193 export:INPUT save:INPUT read:READ} [current_design]
set_property PACKAGE_PIN P16 [get_ports {DAC2_DATA_n[0]}]
set_property src_info {type:XDC file:1 line:194 export:INPUT save:INPUT read:READ} [current_design]
set_property PACKAGE_PIN W18 [get_ports {DAC2_DATA_p[1]}]
set_property src_info {type:XDC file:1 line:195 export:INPUT save:INPUT read:READ} [current_design]
set_property PACKAGE_PIN W19 [get_ports {DAC2_DATA_n[1]}]
set_property src_info {type:XDC file:1 line:196 export:INPUT save:INPUT read:READ} [current_design]
set_property PACKAGE_PIN T17 [get_ports {DAC2_DATA_p[2]}]
set_property src_info {type:XDC file:1 line:197 export:INPUT save:INPUT read:READ} [current_design]
set_property PACKAGE_PIN R18 [get_ports {DAC2_DATA_n[2]}]
set_property src_info {type:XDC file:1 line:198 export:INPUT save:INPUT read:READ} [current_design]
set_property PACKAGE_PIN N17 [get_ports {DAC2_DATA_p[3]}]
set_property src_info {type:XDC file:1 line:199 export:INPUT save:INPUT read:READ} [current_design]
set_property PACKAGE_PIN P18 [get_ports {DAC2_DATA_n[3]}]
set_property src_info {type:XDC file:1 line:200 export:INPUT save:INPUT read:READ} [current_design]
set_property PACKAGE_PIN V17 [get_ports {DAC2_DATA_p[4]}]
set_property src_info {type:XDC file:1 line:201 export:INPUT save:INPUT read:READ} [current_design]
set_property PACKAGE_PIN V18 [get_ports {DAC2_DATA_n[4]}]
set_property src_info {type:XDC file:1 line:202 export:INPUT save:INPUT read:READ} [current_design]
set_property PACKAGE_PIN R16 [get_ports {DAC2_DATA_p[5]}]
set_property src_info {type:XDC file:1 line:203 export:INPUT save:INPUT read:READ} [current_design]
set_property PACKAGE_PIN R17 [get_ports {DAC2_DATA_n[5]}]
set_property src_info {type:XDC file:1 line:204 export:INPUT save:INPUT read:READ} [current_design]
set_property PACKAGE_PIN Y18 [get_ports {DAC2_DATA_p[6]}]
set_property src_info {type:XDC file:1 line:205 export:INPUT save:INPUT read:READ} [current_design]
set_property PACKAGE_PIN Y19 [get_ports {DAC2_DATA_n[6]}]
set_property src_info {type:XDC file:1 line:206 export:INPUT save:INPUT read:READ} [current_design]
set_property PACKAGE_PIN T20 [get_ports {DAC2_DATA_p[7]}]
set_property src_info {type:XDC file:1 line:207 export:INPUT save:INPUT read:READ} [current_design]
set_property PACKAGE_PIN U20 [get_ports {DAC2_DATA_n[7]}]
set_property src_info {type:XDC file:1 line:208 export:INPUT save:INPUT read:READ} [current_design]
set_property PACKAGE_PIN T16 [get_ports {DAC2_DATA_p[8]}]
set_property src_info {type:XDC file:1 line:209 export:INPUT save:INPUT read:READ} [current_design]
set_property PACKAGE_PIN U17 [get_ports {DAC2_DATA_n[8]}]
set_property src_info {type:XDC file:1 line:210 export:INPUT save:INPUT read:READ} [current_design]
set_property PACKAGE_PIN Y16 [get_ports {DAC2_DATA_p[9]}]
set_property src_info {type:XDC file:1 line:211 export:INPUT save:INPUT read:READ} [current_design]
set_property PACKAGE_PIN Y17 [get_ports {DAC2_DATA_n[9]}]
set_property src_info {type:XDC file:1 line:212 export:INPUT save:INPUT read:READ} [current_design]
set_property PACKAGE_PIN T14 [get_ports {DAC2_DATA_p[10]}]
set_property src_info {type:XDC file:1 line:213 export:INPUT save:INPUT read:READ} [current_design]
set_property PACKAGE_PIN T15 [get_ports {DAC2_DATA_n[10]}]
set_property src_info {type:XDC file:1 line:214 export:INPUT save:INPUT read:READ} [current_design]
set_property PACKAGE_PIN U13 [get_ports {DAC2_DATA_p[11]}]
set_property src_info {type:XDC file:1 line:215 export:INPUT save:INPUT read:READ} [current_design]
set_property PACKAGE_PIN V13 [get_ports {DAC2_DATA_n[11]}]
set_property src_info {type:XDC file:1 line:216 export:INPUT save:INPUT read:READ} [current_design]
set_property PACKAGE_PIN T11 [get_ports {DAC2_DATA_p[12]}]
set_property src_info {type:XDC file:1 line:217 export:INPUT save:INPUT read:READ} [current_design]
set_property PACKAGE_PIN T10 [get_ports {DAC2_DATA_n[12]}]
set_property src_info {type:XDC file:1 line:218 export:INPUT save:INPUT read:READ} [current_design]
set_property PACKAGE_PIN P14 [get_ports {DAC2_DATA_p[13]}]
set_property src_info {type:XDC file:1 line:219 export:INPUT save:INPUT read:READ} [current_design]
set_property PACKAGE_PIN R14 [get_ports {DAC2_DATA_n[13]}]
set_property src_info {type:XDC file:1 line:220 export:INPUT save:INPUT read:READ} [current_design]
set_property PACKAGE_PIN V12 [get_ports {DAC2_DATA_p[14]}]
set_property src_info {type:XDC file:1 line:221 export:INPUT save:INPUT read:READ} [current_design]
set_property PACKAGE_PIN W13 [get_ports {DAC2_DATA_n[14]}]
set_property src_info {type:XDC file:1 line:222 export:INPUT save:INPUT read:READ} [current_design]
set_property PACKAGE_PIN T12 [get_ports {DAC2_DATA_p[15]}]
set_property src_info {type:XDC file:1 line:223 export:INPUT save:INPUT read:READ} [current_design]
set_property PACKAGE_PIN U12 [get_ports {DAC2_DATA_n[15]}]
set_property src_info {type:XDC file:1 line:224 export:INPUT save:INPUT read:READ} [current_design]
set_property PACKAGE_PIN U14 [get_ports DAC2_DATACLK_clk_p]
set_property src_info {type:XDC file:1 line:225 export:INPUT save:INPUT read:READ} [current_design]
set_property PACKAGE_PIN U15 [get_ports DAC2_DATACLK_clk_n]
set_property src_info {type:XDC file:1 line:266 export:INPUT save:INPUT read:READ} [current_design]
set_property PACKAGE_PIN N20 [get_ports {FPGA_CLK_clk_p[0]}]
set_property src_info {type:XDC file:1 line:267 export:INPUT save:INPUT read:READ} [current_design]
set_property PACKAGE_PIN P20 [get_ports {FPGA_CLK_clk_n[0]}]
set_property src_info {type:XDC file:1 line:271 export:INPUT save:INPUT read:READ} [current_design]
set_property C_CLK_INPUT_FREQ_HZ 300000000 [get_debug_cores dbg_hub]
set_property src_info {type:XDC file:1 line:272 export:INPUT save:INPUT read:READ} [current_design]
set_property C_ENABLE_CLK_DIVIDER false [get_debug_cores dbg_hub]
set_property src_info {type:XDC file:1 line:273 export:INPUT save:INPUT read:READ} [current_design]
set_property C_USER_SCAN_CHAIN 1 [get_debug_cores dbg_hub]
set_property src_info {type:XDC file:1 line:274 export:INPUT save:INPUT read:READ} [current_design]
connect_debug_port dbg_hub/clk [get_nets clk]
