Tomash1A/FPGAPlatformController/VIVADO- PROJECT BUILDER SCRIPT/projectHW_ADC_build/adc/adc.cache/ip/2021.1/39b302ce77940c59/projectHW_DAC2_CTRL_0_sim_netlist.v

// Copyright 1986-2021 Xilinx, Inc. All Rights Reserved.
// --------------------------------------------------------------------------------
// Tool Version: Vivado v.2021.1 (win64) Build 3247384 Thu Jun 10 19:36:33 MDT 2021
// Date        : Mon Jun 29 12:03:29 2026
// Host        : CS-RO-PC29 running 64-bit major release  (build 9200)
// Command     : write_verilog -force -mode funcsim -rename_top decalper_eb_ot_sdeen_pot_pi_dehcac_xnilix -prefix
//               decalper_eb_ot_sdeen_pot_pi_dehcac_xnilix_ projectHW_DAC2_CTRL_0_sim_netlist.v
// Design      : projectHW_DAC2_CTRL_0
// Purpose     : This verilog netlist is a functional simulation representation of the design and should not be modified
//               or synthesized. This netlist cannot be used for SDF annotated simulation.
// Device      : xc7z020clg400-1
// --------------------------------------------------------------------------------
`timescale 1 ps / 1 ps

module decalper_eb_ot_sdeen_pot_pi_dehcac_xnilix_GPIO_Core
   (\Dual.ALLOUT0_ND_G1.READ_REG_GEN[31].reg1_reg ,
    gpio_io_o,
    \Dual.ALLOUT0_ND_G1.READ_REG_GEN[30].reg1_reg ,
    \Dual.ALLOUT0_ND_G1.READ_REG_GEN[29].reg1_reg ,
    \Dual.ALLOUT0_ND_G1.READ_REG_GEN[28].reg1_reg ,
    \Dual.ALLOUT0_ND_G1.READ_REG_GEN[27].reg1_reg ,
    \Dual.ALLOUT0_ND_G1.READ_REG_GEN[26].reg1_reg ,
    \Dual.ALLOUT0_ND_G1.READ_REG_GEN[25].reg1_reg ,
    \Dual.ALLOUT0_ND_G1.READ_REG_GEN[24].reg1_reg ,
    \Dual.ALLOUT0_ND_G1.READ_REG_GEN[23].reg1_reg ,
    \Dual.ALLOUT0_ND_G1.READ_REG_GEN[22].reg1_reg ,
    \Dual.ALLOUT0_ND_G1.READ_REG_GEN[21].reg1_reg ,
    \Dual.ALLOUT0_ND_G1.READ_REG_GEN[20].reg1_reg ,
    \Dual.ALLOUT0_ND_G1.READ_REG_GEN[19].reg1_reg ,
    \Dual.ALLOUT0_ND_G1.READ_REG_GEN[18].reg1_reg ,
    \Dual.ALLOUT0_ND_G1.READ_REG_GEN[17].reg1_reg ,
    \Dual.ALLOUT0_ND_G1.READ_REG_GEN[16].reg1_reg ,
    \Dual.ALLOUT0_ND_G1.READ_REG_GEN[15].reg1_reg ,
    \Dual.ALLOUT0_ND_G1.READ_REG_GEN[14].reg1_reg ,
    \Dual.ALLOUT0_ND_G1.READ_REG_GEN[13].reg1_reg ,
    \Dual.ALLOUT0_ND_G1.READ_REG_GEN[12].reg1_reg ,
    \Dual.ALLOUT0_ND_G1.READ_REG_GEN[11].reg1_reg ,
    \Dual.ALLOUT0_ND_G1.READ_REG_GEN[10].reg1_reg ,
    \Dual.ALLOUT0_ND_G1.READ_REG_GEN[9].reg1_reg ,
    \Dual.ALLOUT0_ND_G1.READ_REG_GEN[8].reg1_reg ,
    \Dual.ALLOUT0_ND_G1.READ_REG_GEN[7].reg1_reg ,
    \Dual.ALLOUT0_ND_G1.READ_REG_GEN[6].reg1_reg ,
    \Dual.ALLOUT0_ND_G1.READ_REG_GEN[5].reg1_reg ,
    \Dual.ALLOUT0_ND_G1.READ_REG_GEN[4].reg1_reg ,
    \Dual.ALLOUT0_ND_G1.READ_REG_GEN[3].reg1_reg ,
    \Dual.ALLOUT0_ND_G1.READ_REG_GEN[2].reg1_reg ,
    \Dual.ALLOUT0_ND_G1.READ_REG_GEN[1].reg1_reg ,
    \Dual.ALLOUT0_ND_G1.READ_REG_GEN[0].reg1_reg ,
    reg3,
    gpio2_io_o,
    GPIO_xferAck_i,
    gpio_xferAck_Reg,
    ip2bus_wrack_i,
    ip2bus_rdack_i,
    \Dual.ALLOUT1_ND_G2.READ_REG2_GEN[0].reg3_reg[0]_0 ,
    s_axi_aclk,
    bus2ip_reset,
    bus2ip_cs,
    bus2ip_rnw,
    E,
    s_axi_wdata,
    \Dual.gpio2_Data_Out_reg[0]_0 );
  output \Dual.ALLOUT0_ND_G1.READ_REG_GEN[31].reg1_reg ;
  output [31:0]gpio_io_o;
  output \Dual.ALLOUT0_ND_G1.READ_REG_GEN[30].reg1_reg ;
  output \Dual.ALLOUT0_ND_G1.READ_REG_GEN[29].reg1_reg ;
  output \Dual.ALLOUT0_ND_G1.READ_REG_GEN[28].reg1_reg ;
  output \Dual.ALLOUT0_ND_G1.READ_REG_GEN[27].reg1_reg ;
  output \Dual.ALLOUT0_ND_G1.READ_REG_GEN[26].reg1_reg ;
  output \Dual.ALLOUT0_ND_G1.READ_REG_GEN[25].reg1_reg ;
  output \Dual.ALLOUT0_ND_G1.READ_REG_GEN[24].reg1_reg ;
  output \Dual.ALLOUT0_ND_G1.READ_REG_GEN[23].reg1_reg ;
  output \Dual.ALLOUT0_ND_G1.READ_REG_GEN[22].reg1_reg ;
  output \Dual.ALLOUT0_ND_G1.READ_REG_GEN[21].reg1_reg ;
  output \Dual.ALLOUT0_ND_G1.READ_REG_GEN[20].reg1_reg ;
  output \Dual.ALLOUT0_ND_G1.READ_REG_GEN[19].reg1_reg ;
  output \Dual.ALLOUT0_ND_G1.READ_REG_GEN[18].reg1_reg ;
  output \Dual.ALLOUT0_ND_G1.READ_REG_GEN[17].reg1_reg ;
  output \Dual.ALLOUT0_ND_G1.READ_REG_GEN[16].reg1_reg ;
  output \Dual.ALLOUT0_ND_G1.READ_REG_GEN[15].reg1_reg ;
  output \Dual.ALLOUT0_ND_G1.READ_REG_GEN[14].reg1_reg ;
  output \Dual.ALLOUT0_ND_G1.READ_REG_GEN[13].reg1_reg ;
  output \Dual.ALLOUT0_ND_G1.READ_REG_GEN[12].reg1_reg ;
  output \Dual.ALLOUT0_ND_G1.READ_REG_GEN[11].reg1_reg ;
  output \Dual.ALLOUT0_ND_G1.READ_REG_GEN[10].reg1_reg ;
  output \Dual.ALLOUT0_ND_G1.READ_REG_GEN[9].reg1_reg ;
  output \Dual.ALLOUT0_ND_G1.READ_REG_GEN[8].reg1_reg ;
  output \Dual.ALLOUT0_ND_G1.READ_REG_GEN[7].reg1_reg ;
  output \Dual.ALLOUT0_ND_G1.READ_REG_GEN[6].reg1_reg ;
  output \Dual.ALLOUT0_ND_G1.READ_REG_GEN[5].reg1_reg ;
  output \Dual.ALLOUT0_ND_G1.READ_REG_GEN[4].reg1_reg ;
  output \Dual.ALLOUT0_ND_G1.READ_REG_GEN[3].reg1_reg ;
  output \Dual.ALLOUT0_ND_G1.READ_REG_GEN[2].reg1_reg ;
  output \Dual.ALLOUT0_ND_G1.READ_REG_GEN[1].reg1_reg ;
  output \Dual.ALLOUT0_ND_G1.READ_REG_GEN[0].reg1_reg ;
  output [0:31]reg3;
  output [31:0]gpio2_io_o;
  output GPIO_xferAck_i;
  output gpio_xferAck_Reg;
  output ip2bus_wrack_i;
  output ip2bus_rdack_i;
  input \Dual.ALLOUT1_ND_G2.READ_REG2_GEN[0].reg3_reg[0]_0 ;
  input s_axi_aclk;
  input bus2ip_reset;
  input bus2ip_cs;
  input bus2ip_rnw;
  input [0:0]E;
  input [31:0]s_axi_wdata;
  input [0:0]\Dual.gpio2_Data_Out_reg[0]_0 ;

  wire \Dual.ALLOUT0_ND_G1.READ_REG_GEN[0].reg1_reg ;
  wire \Dual.ALLOUT0_ND_G1.READ_REG_GEN[10].reg1_reg ;
  wire \Dual.ALLOUT0_ND_G1.READ_REG_GEN[11].reg1_reg ;
  wire \Dual.ALLOUT0_ND_G1.READ_REG_GEN[12].reg1_reg ;
  wire \Dual.ALLOUT0_ND_G1.READ_REG_GEN[13].reg1_reg ;
  wire \Dual.ALLOUT0_ND_G1.READ_REG_GEN[14].reg1_reg ;
  wire \Dual.ALLOUT0_ND_G1.READ_REG_GEN[15].reg1_reg ;
  wire \Dual.ALLOUT0_ND_G1.READ_REG_GEN[16].reg1_reg ;
  wire \Dual.ALLOUT0_ND_G1.READ_REG_GEN[17].reg1_reg ;
  wire \Dual.ALLOUT0_ND_G1.READ_REG_GEN[18].reg1_reg ;
  wire \Dual.ALLOUT0_ND_G1.READ_REG_GEN[19].reg1_reg ;
  wire \Dual.ALLOUT0_ND_G1.READ_REG_GEN[1].reg1_reg ;
  wire \Dual.ALLOUT0_ND_G1.READ_REG_GEN[20].reg1_reg ;
  wire \Dual.ALLOUT0_ND_G1.READ_REG_GEN[21].reg1_reg ;
  wire \Dual.ALLOUT0_ND_G1.READ_REG_GEN[22].reg1_reg ;
  wire \Dual.ALLOUT0_ND_G1.READ_REG_GEN[23].reg1_reg ;
  wire \Dual.ALLOUT0_ND_G1.READ_REG_GEN[24].reg1_reg ;
  wire \Dual.ALLOUT0_ND_G1.READ_REG_GEN[25].reg1_reg ;
  wire \Dual.ALLOUT0_ND_G1.READ_REG_GEN[26].reg1_reg ;
  wire \Dual.ALLOUT0_ND_G1.READ_REG_GEN[27].reg1_reg ;
  wire \Dual.ALLOUT0_ND_G1.READ_REG_GEN[28].reg1_reg ;
  wire \Dual.ALLOUT0_ND_G1.READ_REG_GEN[29].reg1_reg ;
  wire \Dual.ALLOUT0_ND_G1.READ_REG_GEN[2].reg1_reg ;
  wire \Dual.ALLOUT0_ND_G1.READ_REG_GEN[30].reg1_reg ;
  wire \Dual.ALLOUT0_ND_G1.READ_REG_GEN[31].reg1_reg ;
  wire \Dual.ALLOUT0_ND_G1.READ_REG_GEN[3].reg1_reg ;
  wire \Dual.ALLOUT0_ND_G1.READ_REG_GEN[4].reg1_reg ;
  wire \Dual.ALLOUT0_ND_G1.READ_REG_GEN[5].reg1_reg ;
  wire \Dual.ALLOUT0_ND_G1.READ_REG_GEN[6].reg1_reg ;
  wire \Dual.ALLOUT0_ND_G1.READ_REG_GEN[7].reg1_reg ;
  wire \Dual.ALLOUT0_ND_G1.READ_REG_GEN[8].reg1_reg ;
  wire \Dual.ALLOUT0_ND_G1.READ_REG_GEN[9].reg1_reg ;
  wire \Dual.ALLOUT1_ND_G2.READ_REG2_GEN[0].reg3_reg[0]_0 ;
  wire [0:0]\Dual.gpio2_Data_Out_reg[0]_0 ;
  wire [0:0]E;
  wire GPIO_xferAck_i;
  wire bus2ip_cs;
  wire bus2ip_reset;
  wire bus2ip_rnw;
  wire [31:0]gpio2_io_o;
  wire [31:0]gpio_io_o;
  wire gpio_xferAck_Reg;
  wire iGPIO_xferAck;
  wire ip2bus_rdack_i;
  wire ip2bus_wrack_i;
  wire [0:31]reg3;
  wire s_axi_aclk;
  wire [31:0]s_axi_wdata;

  (* SOFT_HLUTNM = "soft_lutpair6" *) 
  LUT3 #(
    .INIT(8'h04)) 
    \/i_ 
       (.I0(gpio_xferAck_Reg),
        .I1(bus2ip_cs),
        .I2(GPIO_xferAck_i),
        .O(iGPIO_xferAck));
  FDRE \Dual.ALLOUT0_ND_G1.READ_REG_GEN[0].reg1_reg[0] 
       (.C(s_axi_aclk),
        .CE(1'b1),
        .D(gpio_io_o[31]),
        .Q(\Dual.ALLOUT0_ND_G1.READ_REG_GEN[0].reg1_reg ),
        .R(\Dual.ALLOUT1_ND_G2.READ_REG2_GEN[0].reg3_reg[0]_0 ));
  FDRE \Dual.ALLOUT0_ND_G1.READ_REG_GEN[10].reg1_reg[10] 
       (.C(s_axi_aclk),
        .CE(1'b1),
        .D(gpio_io_o[21]),
        .Q(\Dual.ALLOUT0_ND_G1.READ_REG_GEN[10].reg1_reg ),
        .R(\Dual.ALLOUT1_ND_G2.READ_REG2_GEN[0].reg3_reg[0]_0 ));
  FDRE \Dual.ALLOUT0_ND_G1.READ_REG_GEN[11].reg1_reg[11] 
       (.C(s_axi_aclk),
        .CE(1'b1),
        .D(gpio_io_o[20]),
        .Q(\Dual.ALLOUT0_ND_G1.READ_REG_GEN[11].reg1_reg ),
        .R(\Dual.ALLOUT1_ND_G2.READ_REG2_GEN[0].reg3_reg[0]_0 ));
  FDRE \Dual.ALLOUT0_ND_G1.READ_REG_GEN[12].reg1_reg[12] 
       (.C(s_axi_aclk),
        .CE(1'b1),
        .D(gpio_io_o[19]),
        .Q(\Dual.ALLOUT0_ND_G1.READ_REG_GEN[12].reg1_reg ),
        .R(\Dual.ALLOUT1_ND_G2.READ_REG2_GEN[0].reg3_reg[0]_0 ));
  FDRE \Dual.ALLOUT0_ND_G1.READ_REG_GEN[13].reg1_reg[13] 
       (.C(s_axi_aclk),
        .CE(1'b1),
        .D(gpio_io_o[18]),
        .Q(\Dual.ALLOUT0_ND_G1.READ_REG_GEN[13].reg1_reg ),
        .R(\Dual.ALLOUT1_ND_G2.READ_REG2_GEN[0].reg3_reg[0]_0 ));
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
        .CE(E),
        .D(s_axi_wdata[0]),
        .Q(gpio_io_o[0]),
        .R(bus2ip_reset));
  FDRE #(
    .INIT(1'b0)) 
    \Dual.gpio_Data_Out_reg[3] 
       (.C(s_axi_aclk),
        .CE(E),
        .D(s_axi_wdata[28]),
        .Q(gpio_io_o[28]),
        .R(bus2ip_reset));
  FDRE #(
    .INIT(1'b0)) 
    \Dual.gpio_Data_Out_reg[4] 
       (.C(s_axi_aclk),
        .CE(E),
        .D(s_axi_wdata[27]),
        .Q(gpio_io_o[27]),
        .R(bus2ip_reset));
  FDRE #(
    .INIT(1'b0)) 
    \Dual.gpio_Data_Out_reg[5] 
       (.C(s_axi_aclk),
        .CE(E),
        .D(s_axi_wdata[26]),
        .Q(gpio_io_o[26]),
        .R(bus2ip_reset));
  FDRE #(
    .INIT(1'b0)) 
    \Dual.gpio_Data_Out_reg[6] 
       (.C(s_axi_aclk),
        .CE(E),
        .D(s_axi_wdata[25]),
        .Q(gpio_io_o[25]),
        .R(bus2ip_reset));
  FDRE #(
    .INIT(1'b0)) 
    \Dual.gpio_Data_Out_reg[7] 
       (.C(s_axi_aclk),
        .CE(E),
        .D(s_axi_wdata[24]),
        .Q(gpio_io_o[24]),
        .R(bus2ip_reset));
  FDRE #(
    .INIT(1'b0)) 
    \Dual.gpio_Data_Out_reg[8] 
       (.C(s_axi_aclk),
        .CE(E),
        .D(s_axi_wdata[23]),
        .Q(gpio_io_o[23]),
        .R(bus2ip_reset));
  FDRE #(
    .INIT(1'b0)) 
    \Dual.gpio_Data_Out_reg[9] 
       (.C(s_axi_aclk),
        .CE(E),
        .D(s_axi_wdata[22]),
        .Q(gpio_io_o[22]),
        .R(bus2ip_reset));
  FDRE gpio_xferAck_Reg_reg
       (.C(s_axi_aclk),
        .CE(1'b1),
        .D(GPIO_xferAck_i),
        .Q(gpio_xferAck_Reg),
        .R(bus2ip_reset));
  FDRE iGPIO_xferAck_reg
       (.C(s_axi_aclk),
        .CE(1'b1),
        .D(iGPIO_xferAck),
        .Q(GPIO_xferAck_i),
        .R(bus2ip_reset));
  LUT2 #(
    .INIT(4'h8)) 
    ip2bus_rdack_i_D1_i_1
       (.I0(GPIO_xferAck_i),
        .I1(bus2ip_rnw),
        .O(ip2bus_rdack_i));
  (* SOFT_HLUTNM = "soft_lutpair6" *) 
  LUT2 #(
    .INIT(4'h2)) 
    ip2bus_wrack_i_D1_i_1
       (.I0(GPIO_xferAck_i),
        .I1(bus2ip_rnw),
        .O(ip2bus_wrack_i));
endmodule

module decalper_eb_ot_sdeen_pot_pi_dehcac_xnilix_address_decoder
   (\MEM_DECODE_GEN[0].cs_out_i_reg[0]_0 ,
    E,
    bus2ip_rnw_i_reg,
    ip2bus_rdack_i_D1_reg,
    ip2bus_wrack_i_D1_reg,
    bus2ip_rnw_i_reg_0,
    D,
    Q,
    s_axi_aclk,
    \Dual.gpio_Data_Out_reg[0] ,
    \Dual.ALLOUT1_ND_G2.READ_REG2_GEN[0].reg3_reg[0] ,
    s_axi_aresetn,
    GPIO_xferAck_i,
    gpio_xferAck_Reg,
    ip2bus_rdack_i_D1,
    s_axi_arready,
    s_axi_arready_0,
    ip2bus_wrack_i_D1,
    s_axi_wready,
    \Dual.ALLOUT0_ND_G1.READ_REG_GEN[31].reg1_reg ,
    reg3,
    \Dual.ALLOUT0_ND_G1.READ_REG_GEN[30].reg1_reg ,
    \Dual.ALLOUT0_ND_G1.READ_REG_GEN[29].reg1_reg ,
    \Dual.ALLOUT0_ND_G1.READ_REG_GEN[28].reg1_reg ,
    \Dual.ALLOUT0_ND_G1.READ_REG_GEN[27].reg1_reg ,
    \Dual.ALLOUT0_ND_G1.READ_REG_GEN[26].reg1_reg ,
    \Dual.ALLOUT0_ND_G1.READ_REG_GEN[25].reg1_reg ,
    \Dual.ALLOUT0_ND_G1.READ_REG_GEN[24].reg1_reg ,
    \Dual.ALLOUT0_ND_G1.READ_REG_GEN[23].reg1_reg ,
    \Dual.ALLOUT0_ND_G1.READ_REG_GEN[22].reg1_reg ,
    \Dual.ALLOUT0_ND_G1.READ_REG_GEN[21].reg1_reg ,
    \Dual.ALLOUT0_ND_G1.READ_REG_GEN[20].reg1_reg ,
    \Dual.ALLOUT0_ND_G1.READ_REG_GEN[19].reg1_reg ,
    \Dual.ALLOUT0_ND_G1.READ_REG_GEN[18].reg1_reg ,
    \Dual.ALLOUT0_ND_G1.READ_REG_GEN[17].reg1_reg ,
    \Dual.ALLOUT0_ND_G1.READ_REG_GEN[16].reg1_reg ,
    \Dual.ALLOUT0_ND_G1.READ_REG_GEN[15].reg1_reg ,
    \Dual.ALLOUT0_ND_G1.READ_REG_GEN[14].reg1_reg ,
    \Dual.ALLOUT0_ND_G1.READ_REG_GEN[13].reg1_reg ,
    \Dual.ALLOUT0_ND_G1.READ_REG_GEN[12].reg1_reg ,
    \Dual.ALLOUT0_ND_G1.READ_REG_GEN[11].reg1_reg ,
    \Dual.ALLOUT0_ND_G1.READ_REG_GEN[10].reg1_reg ,
    \Dual.ALLOUT0_ND_G1.READ_REG_GEN[9].reg1_reg ,
    \Dual.ALLOUT0_ND_G1.READ_REG_GEN[8].reg1_reg ,
    \Dual.ALLOUT0_ND_G1.READ_REG_GEN[7].reg1_reg ,
    \Dual.ALLOUT0_ND_G1.READ_REG_GEN[6].reg1_reg ,
    \Dual.ALLOUT0_ND_G1.READ_REG_GEN[5].reg1_reg ,
    \Dual.ALLOUT0_ND_G1.READ_REG_GEN[4].reg1_reg ,
    \Dual.ALLOUT0_ND_G1.READ_REG_GEN[3].reg1_reg ,
    \Dual.ALLOUT0_ND_G1.READ_REG_GEN[2].reg1_reg ,
    \Dual.ALLOUT0_ND_G1.READ_REG_GEN[1].reg1_reg ,
    \Dual.ALLOUT0_ND_G1.READ_REG_GEN[0].reg1_reg );
  output \MEM_DECODE_GEN[0].cs_out_i_reg[0]_0 ;
  output [0:0]E;
  output [0:0]bus2ip_rnw_i_reg;
  output ip2bus_rdack_i_D1_reg;
  output ip2bus_wrack_i_D1_reg;
  output bus2ip_rnw_i_reg_0;
  output [31:0]D;
  input Q;
  input s_axi_aclk;
  input [2:0]\Dual.gpio_Data_Out_reg[0] ;
  input \Dual.ALLOUT1_ND_G2.READ_REG2_GEN[0].reg3_reg[0] ;
  input s_axi_aresetn;
  input GPIO_xferAck_i;
  input gpio_xferAck_Reg;
  input ip2bus_rdack_i_D1;
  input s_axi_arready;
  input [3:0]s_axi_arready_0;
  input ip2bus_wrack_i_D1;
  input s_axi_wready;
  input \Dual.ALLOUT0_ND_G1.READ_REG_GEN[31].reg1_reg ;
  input [0:31]reg3;
  input \Dual.ALLOUT0_ND_G1.READ_REG_GEN[30].reg1_reg ;
  input \Dual.ALLOUT0_ND_G1.READ_REG_GEN[29].reg1_reg ;
  input \Dual.ALLOUT0_ND_G1.READ_REG_GEN[28].reg1_reg ;
  input \Dual.ALLOUT0_ND_G1.READ_REG_GEN[27].reg1_reg ;
  input \Dual.ALLOUT0_ND_G1.READ_REG_GEN[26].reg1_reg ;
  input \Dual.ALLOUT0_ND_G1.READ_REG_GEN[25].reg1_reg ;
  input \Dual.ALLOUT0_ND_G1.READ_REG_GEN[24].reg1_reg ;
  input \Dual.ALLOUT0_ND_G1.READ_REG_GEN[23].reg1_reg ;
  input \Dual.ALLOUT0_ND_G1.READ_REG_GEN[22].reg1_reg ;
  input \Dual.ALLOUT0_ND_G1.READ_REG_GEN[21].reg1_reg ;
  input \Dual.ALLOUT0_ND_G1.READ_REG_GEN[20].reg1_reg ;
  input \Dual.ALLOUT0_ND_G1.READ_REG_GEN[19].reg1_reg ;
  input \Dual.ALLOUT0_ND_G1.READ_REG_GEN[18].reg1_reg ;
  input \Dual.ALLOUT0_ND_G1.READ_REG_GEN[17].reg1_reg ;
  input \Dual.ALLOUT0_ND_G1.READ_REG_GEN[16].reg1_reg ;
  input \Dual.ALLOUT0_ND_G1.READ_REG_GEN[15].reg1_reg ;
  input \Dual.ALLOUT0_ND_G1.READ_REG_GEN[14].reg1_reg ;
  input \Dual.ALLOUT0_ND_G1.READ_REG_GEN[13].reg1_reg ;
  input \Dual.ALLOUT0_ND_G1.READ_REG_GEN[12].reg1_reg ;
  input \Dual.ALLOUT0_ND_G1.READ_REG_GEN[11].reg1_reg ;
  input \Dual.ALLOUT0_ND_G1.READ_REG_GEN[10].reg1_reg ;
  input \Dual.ALLOUT0_ND_G1.READ_REG_GEN[9].reg1_reg ;
  input \Dual.ALLOUT0_ND_G1.READ_REG_GEN[8].reg1_reg ;
  input \Dual.ALLOUT0_ND_G1.READ_REG_GEN[7].reg1_reg ;
  input \Dual.ALLOUT0_ND_G1.READ_REG_GEN[6].reg1_reg ;
  input \Dual.ALLOUT0_ND_G1.READ_REG_GEN[5].reg1_reg ;
  input \Dual.ALLOUT0_ND_G1.READ_REG_GEN[4].reg1_reg ;
  input \Dual.ALLOUT0_ND_G1.READ_REG_GEN[3].reg1_reg ;
  input \Dual.ALLOUT0_ND_G1.READ_REG_GEN[2].reg1_reg ;
  input \Dual.ALLOUT0_ND_G1.READ_REG_GEN[1].reg1_reg ;
  input \Dual.ALLOUT0_ND_G1.READ_REG_GEN[0].reg1_reg ;

  wire Bus_RNW_reg;
  wire Bus_RNW_reg_i_1_n_0;
  wire [31:0]D;
  wire \Dual.ALLOUT0_ND_G1.READ_REG_GEN[0].reg1_reg ;
  wire \Dual.ALLOUT0_ND_G1.READ_REG_GEN[10].reg1_reg ;
  wire \Dual.ALLOUT0_ND_G1.READ_REG_GEN[11].reg1_reg ;
  wire \Dual.ALLOUT0_ND_G1.READ_REG_GEN[12].reg1_reg ;
  wire \Dual.ALLOUT0_ND_G1.READ_REG_GEN[13].reg1_reg ;
  wire \Dual.ALLOUT0_ND_G1.READ_REG_GEN[14].reg1_reg ;
  wire \Dual.ALLOUT0_ND_G1.READ_REG_GEN[15].reg1_reg ;
  wire \Dual.ALLOUT0_ND_G1.READ_REG_GEN[16].reg1_reg ;
  wire \Dual.ALLOUT0_ND_G1.READ_REG_GEN[17].reg1_reg ;
  wire \Dual.ALLOUT0_ND_G1.READ_REG_GEN[18].reg1_reg ;
  wire \Dual.ALLOUT0_ND_G1.READ_REG_GEN[19].reg1_reg ;
  wire \Dual.ALLOUT0_ND_G1.READ_REG_GEN[1].reg1_reg ;
  wire \Dual.ALLOUT0_ND_G1.READ_REG_GEN[20].reg1_reg ;
  wire \Dual.ALLOUT0_ND_G1.READ_REG_GEN[21].reg1_reg ;
  wire \Dual.ALLOUT0_ND_G1.READ_REG_GEN[22].reg1_reg ;
  wire \Dual.ALLOUT0_ND_G1.READ_REG_GEN[23].reg1_reg ;
  wire \Dual.ALLOUT0_ND_G1.READ_REG_GEN[24].reg1_reg ;
  wire \Dual.ALLOUT0_ND_G1.READ_REG_GEN[25].reg1_reg ;
  wire \Dual.ALLOUT0_ND_G1.READ_REG_GEN[26].reg1_reg ;
  wire \Dual.ALLOUT0_ND_G1.READ_REG_GEN[27].reg1_reg ;
  wire \Dual.ALLOUT0_ND_G1.READ_REG_GEN[28].reg1_reg ;
  wire \Dual.ALLOUT0_ND_G1.READ_REG_GEN[29].reg1_reg ;
  wire \Dual.ALLOUT0_ND_G1.READ_REG_GEN[2].reg1_reg ;
  wire \Dual.ALLOUT0_ND_G1.READ_REG_GEN[30].reg1_reg ;
  wire \Dual.ALLOUT0_ND_G1.READ_REG_GEN[31].reg1_reg ;
  wire \Dual.ALLOUT0_ND_G1.READ_REG_GEN[3].reg1_reg ;
  wire \Dual.ALLOUT0_ND_G1.READ_REG_GEN[4].reg1_reg ;
  wire \Dual.ALLOUT0_ND_G1.READ_REG_GEN[5].reg1_reg ;
  wire \Dual.ALLOUT0_ND_G1.READ_REG_GEN[6].reg1_reg ;
  wire \Dual.ALLOUT0_ND_G1.READ_REG_GEN[7].reg1_reg ;
  wire \Dual.ALLOUT0_ND_G1.READ_REG_GEN[8].reg1_reg ;
  wire \Dual.ALLOUT0_ND_G1.READ_REG_GEN[9].reg1_reg ;
  wire \Dual.ALLOUT1_ND_G2.READ_REG2_GEN[0].reg3_reg[0] ;
  wire [2:0]\Dual.gpio_Data_Out_reg[0] ;
  wire [0:0]E;
  wire \GEN_BKEND_CE_REGISTERS[0].ce_out_i_reg ;
  wire \GEN_BKEND_CE_REGISTERS[1].ce_out_i_reg ;
  wire \GEN_BKEND_CE_REGISTERS[2].ce_out_i_reg ;
  wire \GEN_BKEND_CE_REGISTERS[3].ce_out_i_reg ;
  wire GPIO_xferAck_i;
  wire \MEM_DECODE_GEN[0].cs_out_i[0]_i_1_n_0 ;
  wire \MEM_DECODE_GEN[0].cs_out_i_reg[0]_0 ;
  wire Q;
  wire [0:0]bus2ip_rnw_i_reg;
  wire bus2ip_rnw_i_reg_0;
  wire ce_expnd_i_0;
  wire ce_expnd_i_1;
  wire ce_expnd_i_2;
  wire ce_expnd_i_3;
  wire cs_ce_clr;
  wire gpio_xferAck_Reg;
  wire \ip2bus_data_i_D1[0]_i_2_n_0 ;
  wire \ip2bus_data_i_D1[0]_i_3_n_0 ;
  wire \ip2bus_data_i_D1[0]_i_4_n_0 ;
  wire ip2bus_rdack_i_D1;
  wire ip2bus_rdack_i_D1_reg;
  wire ip2bus_wrack_i_D1;
  wire ip2bus_wrack_i_D1_reg;
  wire [0:31]reg3;
  wire s_axi_aclk;
  wire s_axi_aresetn;
  wire s_axi_arready;
  wire [3:0]s_axi_arready_0;
  wire s_axi_wready;

  LUT3 #(
    .INIT(8'hB8)) 
    Bus_RNW_reg_i_1
       (.I0(\Dual.ALLOUT1_ND_G2.READ_REG2_GEN[0].reg3_reg[0] ),
        .I1(Q),
        .I2(Bus_RNW_reg),
        .O(Bus_RNW_reg_i_1_n_0));
  FDRE Bus_RNW_reg_reg
       (.C(s_axi_aclk),
        .CE(1'b1),
        .D(Bus_RNW_reg_i_1_n_0),
        .Q(Bus_RNW_reg),
        .R(1'b0));
  LUT4 #(
    .INIT(16'hFDFF)) 
    \Dual.ALLOUT0_ND_G1.READ_REG_GEN[31].reg1[31]_i_1 
       (.I0(\Dual.ALLOUT1_ND_G2.READ_REG2_GEN[0].reg3_reg[0] ),
        .I1(GPIO_xferAck_i),
        .I2(gpio_xferAck_Reg),
        .I3(\MEM_DECODE_GEN[0].cs_out_i_reg[0]_0 ),
        .O(bus2ip_rnw_i_reg_0));
  (* SOFT_HLUTNM = "soft_lutpair0" *) 
  LUT5 #(
    .INIT(32'h00100000)) 
    \Dual.gpio2_Data_Out[0]_i_1 
       (.I0(\Dual.ALLOUT1_ND_G2.READ_REG2_GEN[0].reg3_reg[0] ),
        .I1(\Dual.gpio_Data_Out_reg[0] [2]),
        .I2(\MEM_DECODE_GEN[0].cs_out_i_reg[0]_0 ),
        .I3(\Dual.gpio_Data_Out_reg[0] [0]),
        .I4(\Dual.gpio_Data_Out_reg[0] [1]),
        .O(bus2ip_rnw_i_reg));
  (* SOFT_HLUTNM = "soft_lutpair0" *) 
  LUT5 #(
    .INIT(32'h00000010)) 
    \Dual.gpio_Data_Out[0]_i_1 
       (.I0(\Dual.ALLOUT1_ND_G2.READ_REG2_GEN[0].reg3_reg[0] ),
        .I1(\Dual.gpio_Data_Out_reg[0] [2]),
        .I2(\MEM_DECODE_GEN[0].cs_out_i_reg[0]_0 ),
        .I3(\Dual.gpio_Data_Out_reg[0] [1]),
        .I4(\Dual.gpio_Data_Out_reg[0] [0]),
        .O(E));
  FDRE \GEN_BKEND_CE_REGISTERS[0].ce_out_i_reg[0] 
       (.C(s_axi_aclk),
        .CE(Q),
        .D(ce_expnd_i_3),
        .Q(\GEN_BKEND_CE_REGISTERS[0].ce_out_i_reg ),
        .R(cs_ce_clr));
  (* SOFT_HLUTNM = "soft_lutpair1" *) 
  LUT2 #(
    .INIT(4'h2)) 
    \GEN_BKEND_CE_REGISTERS[1].ce_out_i[1]_i_1 
       (.I0(\Dual.gpio_Data_Out_reg[0] [0]),
        .I1(\Dual.gpio_Data_Out_reg[0] [1]),
        .O(ce_expnd_i_2));
  FDRE \GEN_BKEND_CE_REGISTERS[1].ce_out_i_reg[1] 
       (.C(s_axi_aclk),
        .CE(Q),
        .D(ce_expnd_i_2),
        .Q(\GEN_BKEND_CE_REGISTERS[1].ce_out_i_reg ),
        .R(cs_ce_clr));
  FDRE \GEN_BKEND_CE_REGISTERS[2].ce_out_i_reg[2] 
       (.C(s_axi_aclk),
        .CE(Q),
        .D(ce_expnd_i_1),
        .Q(\GEN_BKEND_CE_REGISTERS[2].ce_out_i_reg ),
        .R(cs_ce_clr));
  LUT3 #(
    .INIT(8'hEF)) 
    \GEN_BKEND_CE_REGISTERS[3].ce_out_i[3]_i_1 
       (.I0(ip2bus_wrack_i_D1_reg),
        .I1(ip2bus_rdack_i_D1_reg),
        .I2(s_axi_aresetn),
        .O(cs_ce_clr));
  (* SOFT_HLUTNM = "soft_lutpair1" *) 
  LUT2 #(
    .INIT(4'h8)) 
    \GEN_BKEND_CE_REGISTERS[3].ce_out_i[3]_i_2 
       (.I0(\Dual.gpio_Data_Out_reg[0] [1]),
        .I1(\Dual.gpio_Data_Out_reg[0] [0]),
        .O(ce_expnd_i_0));
  FDRE \GEN_BKEND_CE_REGISTERS[3].ce_out_i_reg[3] 
       (.C(s_axi_aclk),
        .CE(Q),
        .D(ce_expnd_i_0),
        .Q(\GEN_BKEND_CE_REGISTERS[3].ce_out_i_reg ),
        .R(cs_ce_clr));
  decalper_eb_ot_sdeen_pot_pi_dehcac_xnilix_pselect_f \MEM_DECODE_GEN[0].PER_CE_GEN[0].MULTIPLE_CES_THIS_CS_GEN.CE_I 
       (.\GEN_BKEND_CE_REGISTERS[0].ce_out_i_reg[0] (\Dual.gpio_Data_Out_reg[0] [1:0]),
        .ce_expnd_i_3(ce_expnd_i_3));
  decalper_eb_ot_sdeen_pot_pi_dehcac_xnilix_pselect_f__parameterized1 \MEM_DECODE_GEN[0].PER_CE_GEN[2].MULTIPLE_CES_THIS_CS_GEN.CE_I 
       (.\GEN_BKEND_CE_REGISTERS[2].ce_out_i_reg[2] (\Dual.gpio_Data_Out_reg[0] [1:0]),
        .ce_expnd_i_1(ce_expnd_i_1));
  LUT5 #(
    .INIT(32'h000000E0)) 
    \MEM_DECODE_GEN[0].cs_out_i[0]_i_1 
       (.I0(\MEM_DECODE_GEN[0].cs_out_i_reg[0]_0 ),
        .I1(Q),
        .I2(s_axi_aresetn),
        .I3(ip2bus_rdack_i_D1_reg),
        .I4(ip2bus_wrack_i_D1_reg),
        .O(\MEM_DECODE_GEN[0].cs_out_i[0]_i_1_n_0 ));
  FDRE \MEM_DECODE_GEN[0].cs_out_i_reg[0] 
       (.C(s_axi_aclk),
        .CE(1'b1),
        .D(\MEM_DECODE_GEN[0].cs_out_i[0]_i_1_n_0 ),
        .Q(\MEM_DECODE_GEN[0].cs_out_i_reg[0]_0 ),
        .R(1'b0));
  LUT5 #(
    .INIT(32'hFFEAEAEA)) 
    \ip2bus_data_i_D1[0]_i_1 
       (.I0(\ip2bus_data_i_D1[0]_i_2_n_0 ),
        .I1(\ip2bus_data_i_D1[0]_i_3_n_0 ),
        .I2(\Dual.ALLOUT0_ND_G1.READ_REG_GEN[0].reg1_reg ),
        .I3(reg3[0]),
        .I4(\ip2bus_data_i_D1[0]_i_4_n_0 ),
        .O(D[31]));
  LUT5 #(
    .INIT(32'h00040400)) 
    \ip2bus_data_i_D1[0]_i_2 
       (.I0(\GEN_BKEND_CE_REGISTERS[2].ce_out_i_reg ),
        .I1(Bus_RNW_reg),
        .I2(\GEN_BKEND_CE_REGISTERS[0].ce_out_i_reg ),
        .I3(\GEN_BKEND_CE_REGISTERS[3].ce_out_i_reg ),
        .I4(\GEN_BKEND_CE_REGISTERS[1].ce_out_i_reg ),
        .O(\ip2bus_data_i_D1[0]_i_2_n_0 ));
  LUT5 #(
    .INIT(32'h00020000)) 
    \ip2bus_data_i_D1[0]_i_3 
       (.I0(Bus_RNW_reg),
        .I1(\GEN_BKEND_CE_REGISTERS[1].ce_out_i_reg ),
        .I2(\GEN_BKEND_CE_REGISTERS[3].ce_out_i_reg ),
        .I3(\GEN_BKEND_CE_REGISTERS[2].ce_out_i_reg ),
        .I4(\GEN_BKEND_CE_REGISTERS[0].ce_out_i_reg ),
        .O(\ip2bus_data_i_D1[0]_i_3_n_0 ));
  LUT5 #(
    .INIT(32'h00100000)) 
    \ip2bus_data_i_D1[0]_i_4 
       (.I0(\GEN_BKEND_CE_REGISTERS[1].ce_out_i_reg ),
        .I1(\GEN_BKEND_CE_REGISTERS[3].ce_out_i_reg ),
        .I2(Bus_RNW_reg),
        .I3(\GEN_BKEND_CE_REGISTERS[0].ce_out_i_reg ),
        .I4(\GEN_BKEND_CE_REGISTERS[2].ce_out_i_reg ),
        .O(\ip2bus_data_i_D1[0]_i_4_n_0 ));
  LUT5 #(
    .INIT(32'hFFEAEAEA)) 
    \ip2bus_data_i_D1[10]_i_1 
       (.I0(\ip2bus_data_i_D1[0]_i_2_n_0 ),
        .I1(\ip2bus_data_i_D1[0]_i_3_n_0 ),
        .I2(\Dual.ALLOUT0_ND_G1.READ_REG_GEN[10].reg1_reg ),
        .I3(reg3[10]),
        .I4(\ip2bus_data_i_D1[0]_i_4_n_0 ),
        .O(D[21]));
  LUT5 #(
    .INIT(32'hFFEAEAEA)) 
    \ip2bus_data_i_D1[11]_i_1 
       (.I0(\ip2bus_data_i_D1[0]_i_2_n_0 ),
        .I1(\ip2bus_data_i_D1[0]_i_3_n_0 ),
        .I2(\Dual.ALLOUT0_ND_G1.READ_REG_GEN[11].reg1_reg ),
        .I3(reg3[11]),
        .I4(\ip2bus_data_i_D1[0]_i_4_n_0 ),
        .O(D[20]));
  LUT5 #(
    .INIT(32'hFFEAEAEA)) 
    \ip2bus_data_i_D1[12]_i_1 
       (.I0(\ip2bus_data_i_D1[0]_i_2_n_0 ),
        .I1(\ip2bus_data_i_D1[0]_i_3_n_0 ),
        .I2(\Dual.ALLOUT0_ND_G1.READ_REG_GEN[12].reg1_reg ),
        .I3(reg3[12]),
        .I4(\ip2bus_data_i_D1[0]_i_4_n_0 ),
        .O(D[19]));
  LUT5 #(
    .INIT(32'hFFEAEAEA)) 
    \ip2bus_data_i_D1[13]_i_1 
       (.I0(\ip2bus_data_i_D1[0]_i_2_n_0 ),
        .I1(\ip2bus_data_i_D1[0]_i_3_n_0 ),
        .I2(\Dual.ALLOUT0_ND_G1.READ_REG_GEN[13].reg1_reg ),
        .I3(reg3[13]),
        .I4(\ip2bus_data_i_D1[0]_i_4_n_0 ),
        .O(D[18]));
  LUT5 #(
    .INIT(32'hFFEAEAEA)) 
    \ip2bus_data_i_D1[14]_i_1 
       (.I0(\ip2bus_data_i_D1[0]_i_2_n_0 ),
        .I1(\ip2bus_data_i_D1[0]_i_3_n_0 ),
        .I2(\Dual.ALLOUT0_ND_G1.READ_REG_GEN[14].reg1_reg ),
        .I3(reg3[14]),
        .I4(\ip2bus_data_i_D1[0]_i_4_n_0 ),
        .O(D[17]));
  LUT5 #(
    .INIT(32'hFFEAEAEA)) 
    \ip2bus_data_i_D1[15]_i_1 
       (.I0(\ip2bus_data_i_D1[0]_i_2_n_0 ),
        .I1(\ip2bus_data_i_D1[0]_i_3_n_0 ),
        .I2(\Dual.ALLOUT0_ND_G1.READ_REG_GEN[15].reg1_reg ),
        .I3(reg3[15]),
        .I4(\ip2bus_data_i_D1[0]_i_4_n_0 ),
        .O(D[16]));
  LUT5 #(
    .INIT(32'hFFEAEAEA)) 
    \ip2bus_data_i_D1[16]_i_1 
       (.I0(\ip2bus_data_i_D1[0]_i_2_n_0 ),
        .I1(\ip2bus_data_i_D1[0]_i_3_n_0 ),
        .I2(\Dual.ALLOUT0_ND_G1.READ_REG_GEN[16].reg1_reg ),
        .I3(reg3[16]),
        .I4(\ip2bus_data_i_D1[0]_i_4_n_0 ),
        .O(D[15]));
  LUT5 #(
    .INIT(32'hFFEAEAEA)) 
    \ip2bus_data_i_D1[17]_i_1 
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
       (.I0(\ip2bus_data_i_D1[0]_i_2_n_0 ),
        .I1(\ip2bus_data_i_D1[0]_i_3_n_0 ),
        .I2(\Dual.ALLOUT0_ND_G1.READ_REG_GEN[2].reg1_reg ),
        .I3(reg3[2]),
        .I4(\ip2bus_data_i_D1[0]_i_4_n_0 ),
        .O(D[29]));
  LUT5 #(
    .INIT(32'hFFEAEAEA)) 
    \ip2bus_data_i_D1[30]_i_1 
       (.I0(\ip2bus_data_i_D1[0]_i_2_n_0 ),
        .I1(\ip2bus_data_i_D1[0]_i_3_n_0 ),
        .I2(\Dual.ALLOUT0_ND_G1.READ_REG_GEN[30].reg1_reg ),
        .I3(reg3[30]),
        .I4(\ip2bus_data_i_D1[0]_i_4_n_0 ),
        .O(D[1]));
  LUT5 #(
    .INIT(32'hFFEAEAEA)) 
    \ip2bus_data_i_D1[31]_i_1 
       (.I0(\ip2bus_data_i_D1[0]_i_2_n_0 ),
        .I1(\ip2bus_data_i_D1[0]_i_3_n_0 ),
        .I2(\Dual.ALLOUT0_ND_G1.READ_REG_GEN[31].reg1_reg ),
        .I3(reg3[31]),
        .I4(\ip2bus_data_i_D1[0]_i_4_n_0 ),
        .O(D[0]));
  LUT5 #(
    .INIT(32'hFFEAEAEA)) 
    \ip2bus_data_i_D1[3]_i_1 
       (.I0(\ip2bus_data_i_D1[0]_i_2_n_0 ),
        .I1(\ip2bus_data_i_D1[0]_i_3_n_0 ),
        .I2(\Dual.ALLOUT0_ND_G1.READ_REG_GEN[3].reg1_reg ),
        .I3(reg3[3]),
        .I4(\ip2bus_data_i_D1[0]_i_4_n_0 ),
        .O(D[28]));
  LUT5 #(
    .INIT(32'hFFEAEAEA)) 
    \ip2bus_data_i_D1[4]_i_1 
       (.I0(\ip2bus_data_i_D1[0]_i_2_n_0 ),
        .I1(\ip2bus_data_i_D1[0]_i_3_n_0 ),
        .I2(\Dual.ALLOUT0_ND_G1.READ_REG_GEN[4].reg1_reg ),
        .I3(reg3[4]),
        .I4(\ip2bus_data_i_D1[0]_i_4_n_0 ),
        .O(D[27]));
  LUT5 #(
    .INIT(32'hFFEAEAEA)) 
    \ip2bus_data_i_D1[5]_i_1 
       (.I0(\ip2bus_data_i_D1[0]_i_2_n_0 ),
        .I1(\ip2bus_data_i_D1[0]_i_3_n_0 ),
        .I2(\Dual.ALLOUT0_ND_G1.READ_REG_GEN[5].reg1_reg ),
        .I3(reg3[5]),
        .I4(\ip2bus_data_i_D1[0]_i_4_n_0 ),
        .O(D[26]));
  LUT5 #(
    .INIT(32'hFFEAEAEA)) 
    \ip2bus_data_i_D1[6]_i_1 
       (.I0(\ip2bus_data_i_D1[0]_i_2_n_0 ),
        .I1(\ip2bus_data_i_D1[0]_i_3_n_0 ),
        .I2(\Dual.ALLOUT0_ND_G1.READ_REG_GEN[6].reg1_reg ),
        .I3(reg3[6]),
        .I4(\ip2bus_data_i_D1[0]_i_4_n_0 ),
        .O(D[25]));
  LUT5 #(
    .INIT(32'hFFEAEAEA)) 
    \ip2bus_data_i_D1[7]_i_1 
       (.I0(\ip2bus_data_i_D1[0]_i_2_n_0 ),
        .I1(\ip2bus_data_i_D1[0]_i_3_n_0 ),
        .I2(\Dual.ALLOUT0_ND_G1.READ_REG_GEN[7].reg1_reg ),
        .I3(reg3[7]),
        .I4(\ip2bus_data_i_D1[0]_i_4_n_0 ),
        .O(D[24]));
  LUT5 #(
    .INIT(32'hFFEAEAEA)) 
    \ip2bus_data_i_D1[8]_i_1 
       (.I0(\ip2bus_data_i_D1[0]_i_2_n_0 ),
        .I1(\ip2bus_data_i_D1[0]_i_3_n_0 ),
        .I2(\Dual.ALLOUT0_ND_G1.READ_REG_GEN[8].reg1_reg ),
        .I3(reg3[8]),
        .I4(\ip2bus_data_i_D1[0]_i_4_n_0 ),
        .O(D[23]));
  LUT5 #(
    .INIT(32'hFFEAEAEA)) 
    \ip2bus_data_i_D1[9]_i_1 
       (.I0(\ip2bus_data_i_D1[0]_i_2_n_0 ),
        .I1(\ip2bus_data_i_D1[0]_i_3_n_0 ),
        .I2(\Dual.ALLOUT0_ND_G1.READ_REG_GEN[9].reg1_reg ),
        .I3(reg3[9]),
        .I4(\ip2bus_data_i_D1[0]_i_4_n_0 ),
        .O(D[22]));
  LUT6 #(
    .INIT(64'hAAAAAAAAAAAEAAAA)) 
    s_axi_arready_INST_0
       (.I0(ip2bus_rdack_i_D1),
        .I1(s_axi_arready),
        .I2(s_axi_arready_0[2]),
        .I3(s_axi_arready_0[1]),
        .I4(s_axi_arready_0[3]),
        .I5(s_axi_arready_0[0]),
        .O(ip2bus_rdack_i_D1_reg));
  LUT6 #(
    .INIT(64'hAAAAAAAAAAAEAAAA)) 
    s_axi_wready_INST_0
       (.I0(ip2bus_wrack_i_D1),
        .I1(s_axi_wready),
        .I2(s_axi_arready_0[2]),
        .I3(s_axi_arready_0[1]),
        .I4(s_axi_arready_0[3]),
        .I5(s_axi_arready_0[0]),
        .O(ip2bus_wrack_i_D1_reg));
endmodule

(* C_ALL_INPUTS = "0" *) (* C_ALL_INPUTS_2 = "0" *) (* C_ALL_OUTPUTS = "1" *) 
(* C_ALL_OUTPUTS_2 = "1" *) (* C_DOUT_DEFAULT = "0" *) (* C_DOUT_DEFAULT_2 = "0" *) 
(* C_FAMILY = "zynq" *) (* C_GPIO2_WIDTH = "32" *) (* C_GPIO_WIDTH = "32" *) 
(* C_INTERRUPT_PRESENT = "0" *) (* C_IS_DUAL = "1" *) (* C_S_AXI_ADDR_WIDTH = "9" *) 
(* C_S_AXI_DATA_WIDTH = "32" *) (* C_TRI_DEFAULT = "-1" *) (* C_TRI_DEFAULT_2 = "-1" *) 
(* downgradeipidentifiedwarnings = "yes" *) (* ip_group = "LOGICORE" *) 
module decalper_eb_ot_sdeen_pot_pi_dehcac_xnilix_axi_gpio
   (s_axi_aclk,
    s_axi_aresetn,
    s_axi_awaddr,
    s_axi_awvalid,
    s_axi_awready,
    s_axi_wdata,
    s_axi_wstrb,
    s_axi_wvalid,
    s_axi_wready,
    s_axi_bresp,
    s_axi_bvalid,
    s_axi_bready,
    s_axi_araddr,
    s_axi_arvalid,
    s_axi_arready,
    s_axi_rdata,
    s_axi_rresp,
    s_axi_rvalid,
    s_axi_rready,
    ip2intc_irpt,
    gpio_io_i,
    gpio_io_o,
    gpio_io_t,
    gpio2_io_i,
    gpio2_io_o,
    gpio2_io_t);
  (* sigis = "Clk" *) input s_axi_aclk;
  (* sigis = "Rst" *) input s_axi_aresetn;
  input [8:0]s_axi_awaddr;
  input s_axi_awvalid;
  output s_axi_awready;
  input [31:0]s_axi_wdata;
  input [3:0]s_axi_wstrb;
  input s_axi_wvalid;
  output s_axi_wready;
  output [1:0]s_axi_bresp;
  output s_axi_bvalid;
  input s_axi_bready;
  input [8:0]s_axi_araddr;
  input s_axi_arvalid;
  output s_axi_arready;
  output [31:0]s_axi_rdata;
  output [1:0]s_axi_rresp;
  output s_axi_rvalid;
  input s_axi_rready;
  (* sigis = "INTR_LEVEL_HIGH" *) output ip2intc_irpt;
  input [31:0]gpio_io_i;
  output [31:0]gpio_io_o;
  output [31:0]gpio_io_t;
  input [31:0]gpio2_io_i;
  output [31:0]gpio2_io_o;
  output [31:0]gpio2_io_t;

  wire \<const0> ;
  wire AXI_LITE_IPIF_I_n_5;
  wire AXI_LITE_IPIF_I_n_6;
  wire AXI_LITE_IPIF_I_n_9;
  wire \Dual.ALLOUT0_ND_G1.READ_REG_GEN[0].reg1_reg ;
  wire \Dual.ALLOUT0_ND_G1.READ_REG_GEN[10].reg1_reg ;
  wire \Dual.ALLOUT0_ND_G1.READ_REG_GEN[11].reg1_reg ;
  wire \Dual.ALLOUT0_ND_G1.READ_REG_GEN[12].reg1_reg ;
  wire \Dual.ALLOUT0_ND_G1.READ_REG_GEN[13].reg1_reg ;
  wire \Dual.ALLOUT0_ND_G1.READ_REG_GEN[14].reg1_reg ;
  wire \Dual.ALLOUT0_ND_G1.READ_REG_GEN[15].reg1_reg ;
  wire \Dual.ALLOUT0_ND_G1.READ_REG_GEN[16].reg1_reg ;
  wire \Dual.ALLOUT0_ND_G1.READ_REG_GEN[17].reg1_reg ;
  wire \Dual.ALLOUT0_ND_G1.READ_REG_GEN[18].reg1_reg ;
  wire \Dual.ALLOUT0_ND_G1.READ_REG_GEN[19].reg1_reg ;
  wire \Dual.ALLOUT0_ND_G1.READ_REG_GEN[1].reg1_reg ;
  wire \Dual.ALLOUT0_ND_G1.READ_REG_GEN[20].reg1_reg ;
  wire \Dual.ALLOUT0_ND_G1.READ_REG_GEN[21].reg1_reg ;
  wire \Dual.ALLOUT0_ND_G1.READ_REG_GEN[22].reg1_reg ;
  wire \Dual.ALLOUT0_ND_G1.READ_REG_GEN[23].reg1_reg ;
  wire \Dual.ALLOUT0_ND_G1.READ_REG_GEN[24].reg1_reg ;
  wire \Dual.ALLOUT0_ND_G1.READ_REG_GEN[25].reg1_reg ;
  wire \Dual.ALLOUT0_ND_G1.READ_REG_GEN[26].reg1_reg ;
  wire \Dual.ALLOUT0_ND_G1.READ_REG_GEN[27].reg1_reg ;
  wire \Dual.ALLOUT0_ND_G1.READ_REG_GEN[28].reg1_reg ;
  wire \Dual.ALLOUT0_ND_G1.READ_REG_GEN[29].reg1_reg ;
  wire \Dual.ALLOUT0_ND_G1.READ_REG_GEN[2].reg1_reg ;
  wire \Dual.ALLOUT0_ND_G1.READ_REG_GEN[30].reg1_reg ;
  wire \Dual.ALLOUT0_ND_G1.READ_REG_GEN[31].reg1_reg ;
  wire \Dual.ALLOUT0_ND_G1.READ_REG_GEN[3].reg1_reg ;
  wire \Dual.ALLOUT0_ND_G1.READ_REG_GEN[4].reg1_reg ;
  wire \Dual.ALLOUT0_ND_G1.READ_REG_GEN[5].reg1_reg ;
  wire \Dual.ALLOUT0_ND_G1.READ_REG_GEN[6].reg1_reg ;
  wire \Dual.ALLOUT0_ND_G1.READ_REG_GEN[7].reg1_reg ;
  wire \Dual.ALLOUT0_ND_G1.READ_REG_GEN[8].reg1_reg ;
  wire \Dual.ALLOUT0_ND_G1.READ_REG_GEN[9].reg1_reg ;
  wire GPIO_xferAck_i;
  wire bus2ip_cs;
  wire bus2ip_reset;
  wire bus2ip_rnw;
  wire [31:0]gpio2_io_o;
  wire [31:0]gpio_io_o;
  wire gpio_xferAck_Reg;
  wire [0:31]ip2bus_data;
  wire [0:31]ip2bus_data_i_D1;
  wire ip2bus_rdack_i;
  wire ip2bus_rdack_i_D1;
  wire ip2bus_wrack_i;
  wire ip2bus_wrack_i_D1;
  wire [0:31]reg3;
  wire s_axi_aclk;
  wire [8:0]s_axi_araddr;
  wire s_axi_aresetn;
  wire s_axi_arready;
  wire s_axi_arvalid;
  wire [8:0]s_axi_awaddr;
  wire s_axi_awvalid;
  wire s_axi_bready;
  wire s_axi_bvalid;
  wire [31:0]s_axi_rdata;
  wire s_axi_rready;
  wire s_axi_rvalid;
  wire [31:0]s_axi_wdata;
  wire s_axi_wready;
  wire s_axi_wvalid;

  assign gpio2_io_t[31] = \<const0> ;
  assign gpio2_io_t[30] = \<const0> ;
  assign gpio2_io_t[29] = \<const0> ;
  assign gpio2_io_t[28] = \<const0> ;
  assign gpio2_io_t[27] = \<const0> ;
  assign gpio2_io_t[26] = \<const0> ;
  assign gpio2_io_t[25] = \<const0> ;
  assign gpio2_io_t[24] = \<const0> ;
  assign gpio2_io_t[23] = \<const0> ;
  assign gpio2_io_t[22] = \<const0> ;
  assign gpio2_io_t[21] = \<const0> ;
  assign gpio2_io_t[20] = \<const0> ;
  assign gpio2_io_t[19] = \<const0> ;
  assign gpio2_io_t[18] = \<const0> ;
  assign gpio2_io_t[17] = \<const0> ;
  assign gpio2_io_t[16] = \<const0> ;
  assign gpio2_io_t[15] = \<const0> ;
  assign gpio2_io_t[14] = \<const0> ;
  assign gpio2_io_t[13] = \<const0> ;
  assign gpio2_io_t[12] = \<const0> ;
  assign gpio2_io_t[11] = \<const0> ;
  assign gpio2_io_t[10] = \<const0> ;
  assign gpio2_io_t[9] = \<const0> ;
  assign gpio2_io_t[8] = \<const0> ;
  assign gpio2_io_t[7] = \<const0> ;
  assign gpio2_io_t[6] = \<const0> ;
  assign gpio2_io_t[5] = \<const0> ;
  assign gpio2_io_t[4] = \<const0> ;
  assign gpio2_io_t[3] = \<const0> ;
  assign gpio2_io_t[2] = \<const0> ;
  assign gpio2_io_t[1] = \<const0> ;
  assign gpio2_io_t[0] = \<const0> ;
  assign gpio_io_t[31] = \<const0> ;
  assign gpio_io_t[30] = \<const0> ;
  assign gpio_io_t[29] = \<const0> ;
  assign gpio_io_t[28] = \<const0> ;
  assign gpio_io_t[27] = \<const0> ;
  assign gpio_io_t[26] = \<const0> ;
  assign gpio_io_t[25] = \<const0> ;
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
        .\Dual.ALLOUT0_ND_G1.READ_REG_GEN[29].reg1_reg (\Dual.ALLOUT0_ND_G1.READ_REG_GEN[29].reg1_reg ),
        .\Dual.ALLOUT0_ND_G1.READ_REG_GEN[2].reg1_reg (\Dual.ALLOUT0_ND_G1.READ_REG_GEN[2].reg1_reg ),
        .\Dual.ALLOUT0_ND_G1.READ_REG_GEN[30].reg1_reg (\Dual.ALLOUT0_ND_G1.READ_REG_GEN[30].reg1_reg ),
        .\Dual.ALLOUT0_ND_G1.READ_REG_GEN[31].reg1_reg (\Dual.ALLOUT0_ND_G1.READ_REG_GEN[31].reg1_reg ),
        .\Dual.ALLOUT0_ND_G1.READ_REG_GEN[3].reg1_reg (\Dual.ALLOUT0_ND_G1.READ_REG_GEN[3].reg1_reg ),
        .\Dual.ALLOUT0_ND_G1.READ_REG_GEN[4].reg1_reg (\Dual.ALLOUT0_ND_G1.READ_REG_GEN[4].reg1_reg ),
        .\Dual.ALLOUT0_ND_G1.READ_REG_GEN[5].reg1_reg (\Dual.ALLOUT0_ND_G1.READ_REG_GEN[5].reg1_reg ),
        .\Dual.ALLOUT0_ND_G1.READ_REG_GEN[6].reg1_reg (\Dual.ALLOUT0_ND_G1.READ_REG_GEN[6].reg1_reg ),
        .\Dual.ALLOUT0_ND_G1.READ_REG_GEN[7].reg1_reg (\Dual.ALLOUT0_ND_G1.READ_REG_GEN[7].reg1_reg ),
        .\Dual.ALLOUT0_ND_G1.READ_REG_GEN[8].reg1_reg (\Dual.ALLOUT0_ND_G1.READ_REG_GEN[8].reg1_reg ),
        .\Dual.ALLOUT0_ND_G1.READ_REG_GEN[9].reg1_reg (\Dual.ALLOUT0_ND_G1.READ_REG_GEN[9].reg1_reg ),
        .E(AXI_LITE_IPIF_I_n_5),
        .GPIO_xferAck_i(GPIO_xferAck_i),
        .Q({ip2bus_data_i_D1[0],ip2bus_data_i_D1[1],ip2bus_data_i_D1[2],ip2bus_data_i_D1[3],ip2bus_data_i_D1[4],ip2bus_data_i_D1[5],ip2bus_data_i_D1[6],ip2bus_data_i_D1[7],ip2bus_data_i_D1[8],ip2bus_data_i_D1[9],ip2bus_data_i_D1[10],ip2bus_data_i_D1[11],ip2bus_data_i_D1[12],ip2bus_data_i_D1[13],ip2bus_data_i_D1[14],ip2bus_data_i_D1[15],ip2bus_data_i_D1[16],ip2bus_data_i_D1[17],ip2bus_data_i_D1[18],ip2bus_data_i_D1[19],ip2bus_data_i_D1[20],ip2bus_data_i_D1[21],ip2bus_data_i_D1[22],ip2bus_data_i_D1[23],ip2bus_data_i_D1[24],ip2bus_data_i_D1[25],ip2bus_data_i_D1[26],ip2bus_data_i_D1[27],ip2bus_data_i_D1[28],ip2bus_data_i_D1[29],ip2bus_data_i_D1[30],ip2bus_data_i_D1[31]}),
        .bus2ip_cs(bus2ip_cs),
        .bus2ip_reset(bus2ip_reset),
        .bus2ip_rnw(bus2ip_rnw),
        .bus2ip_rnw_i_reg(AXI_LITE_IPIF_I_n_6),
        .bus2ip_rnw_i_reg_0(AXI_LITE_IPIF_I_n_9),
        .gpio_xferAck_Reg(gpio_xferAck_Reg),
        .ip2bus_rdack_i_D1(ip2bus_rdack_i_D1),
        .ip2bus_rdack_i_D1_reg(s_axi_arready),
        .ip2bus_wrack_i_D1(ip2bus_wrack_i_D1),
        .ip2bus_wrack_i_D1_reg(s_axi_wready),
        .reg3(reg3),
        .s_axi_aclk(s_axi_aclk),
        .s_axi_araddr({s_axi_araddr[8],s_axi_araddr[3:2]}),
        .s_axi_aresetn(s_axi_aresetn),
        .s_axi_arvalid(s_axi_arvalid),
        .s_axi_awaddr({s_axi_awaddr[8],s_axi_awaddr[3:2]}),
        .s_axi_awvalid(s_axi_awvalid),
        .s_axi_bready(s_axi_bready),
        .s_axi_bvalid_i_reg(s_axi_bvalid),
        .s_axi_rdata(s_axi_rdata),
        .s_axi_rready(s_axi_rready),
        .s_axi_rvalid_i_reg(s_axi_rvalid),
        .s_axi_wvalid(s_axi_wvalid));
  GND GND
       (.G(\<const0> ));
  decalper_eb_ot_sdeen_pot_pi_dehcac_xnilix_GPIO_Core gpio_core_1
       (.\Dual.ALLOUT0_ND_G1.READ_REG_GEN[0].reg1_reg (\Dual.ALLOUT0_ND_G1.READ_REG_GEN[0].reg1_reg ),
        .\Dual.ALLOUT0_ND_G1.READ_REG_GEN[10].reg1_reg (\Dual.ALLOUT0_ND_G1.READ_REG_GEN[10].reg1_reg ),
        .\Dual.ALLOUT0_ND_G1.READ_REG_GEN[11].reg1_reg (\Dual.ALLOUT0_ND_G1.READ_REG_GEN[11].reg1_reg ),
        .\Dual.ALLOUT0_ND_G1.READ_REG_GEN[12].reg1_reg (\Dual.ALLOUT0_ND_G1.READ_REG_GEN[12].reg1_reg ),
        .\Dual.ALLOUT0_ND_G1.READ_REG_GEN[13].reg1_reg (\Dual.ALLOUT0_ND_G1.READ_REG_GEN[13].reg1_reg ),
        .\Dual.ALLOUT0_ND_G1.READ_REG_GEN[14].reg1_reg (\Dual.ALLOUT0_ND_G1.READ_REG_GEN[14].reg1_reg ),
        .\Dual.ALLOUT0_ND_G1.READ_REG_GEN[15].reg1_reg (\Dual.ALLOUT0_ND_G1.READ_REG_GEN[15].reg1_reg ),
        .\Dual.ALLOUT0_ND_G1.READ_REG_GEN[16].reg1_reg (\Dual.ALLOUT0_ND_G1.READ_REG_GEN[16].reg1_reg ),
        .\Dual.ALLOUT0_ND_G1.READ_REG_GEN[17].reg1_reg (\Dual.ALLOUT0_ND_G1.READ_REG_GEN[17].reg1_reg ),
        .\Dual.ALLOUT0_ND_G1.READ_REG_GEN[18].reg1_reg (\Dual.ALLOUT0_ND_G1.READ_REG_GEN[18].reg1_reg ),
        .\Dual.ALLOUT0_ND_G1.READ_REG_GEN[19].reg1_reg (\Dual.ALLOUT0_ND_G1.READ_REG_GEN[19].reg1_reg ),
        .\Dual.ALLOUT0_ND_G1.READ_REG_GEN[1].reg1_reg (\Dual.ALLOUT0_ND_G1.READ_REG_GEN[1].reg1_reg ),
        .\Dual.ALLOUT0_ND_G1.READ_REG_GEN[20].reg1_reg (\Dual.ALLOUT0_ND_G1.READ_REG_GEN[20].reg1_reg ),
        .\Dual.ALLOUT0_ND_G1.READ_REG_GEN[21].reg1_reg (\Dual.ALLOUT0_ND_G1.READ_REG_GEN[21].reg1_reg ),
        .\Dual.ALLOUT0_ND_G1.READ_REG_GEN[22].reg1_reg (\Dual.ALLOUT0_ND_G1.READ_REG_GEN[22].reg1_reg ),
        .\Dual.ALLOUT0_ND_G1.READ_REG_GEN[23].reg1_reg (\Dual.ALLOUT0_ND_G1.READ_REG_GEN[23].reg1_reg ),
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
       (.C(s_axi_aclk),
        .CE(1'b1),
        .D(ip2bus_data[7]),
        .Q(ip2bus_data_i_D1[7]),
        .R(bus2ip_reset));
  FDRE \ip2bus_data_i_D1_reg[8] 
       (.C(s_axi_aclk),
        .CE(1'b1),
        .D(ip2bus_data[8]),
        .Q(ip2bus_data_i_D1[8]),
        .R(bus2ip_reset));
  FDRE \ip2bus_data_i_D1_reg[9] 
       (.C(s_axi_aclk),
        .CE(1'b1),
        .D(ip2bus_data[9]),
        .Q(ip2bus_data_i_D1[9]),
        .R(bus2ip_reset));
  FDRE ip2bus_rdack_i_D1_reg
       (.C(s_axi_aclk),
        .CE(1'b1),
        .D(ip2bus_rdack_i),
        .Q(ip2bus_rdack_i_D1),
        .R(bus2ip_reset));
  FDRE ip2bus_wrack_i_D1_reg
       (.C(s_axi_aclk),
        .CE(1'b1),
        .D(ip2bus_wrack_i),
        .Q(ip2bus_wrack_i_D1),
        .R(bus2ip_reset));
endmodule

module decalper_eb_ot_sdeen_pot_pi_dehcac_xnilix_axi_lite_ipif
   (bus2ip_reset,
    bus2ip_rnw,
    s_axi_rvalid_i_reg,
    s_axi_bvalid_i_reg,
    bus2ip_cs,
    E,
    bus2ip_rnw_i_reg,
    ip2bus_rdack_i_D1_reg,
    ip2bus_wrack_i_D1_reg,
    bus2ip_rnw_i_reg_0,
    s_axi_rdata,
    D,
    s_axi_aclk,
    s_axi_arvalid,
    s_axi_rready,
    s_axi_bready,
    s_axi_aresetn,
    s_axi_awvalid,
    s_axi_wvalid,
    GPIO_xferAck_i,
    gpio_xferAck_Reg,
    Q,
    \Dual.ALLOUT0_ND_G1.READ_REG_GEN[31].reg1_reg ,
    reg3,
    \Dual.ALLOUT0_ND_G1.READ_REG_GEN[30].reg1_reg ,
    \Dual.ALLOUT0_ND_G1.READ_REG_GEN[29].reg1_reg ,
    \Dual.ALLOUT0_ND_G1.READ_REG_GEN[28].reg1_reg ,
    \Dual.ALLOUT0_ND_G1.READ_REG_GEN[27].reg1_reg ,
    \Dual.ALLOUT0_ND_G1.READ_REG_GEN[26].reg1_reg ,
    \Dual.ALLOUT0_ND_G1.READ_REG_GEN[25].reg1_reg ,
    \Dual.ALLOUT0_ND_G1.READ_REG_GEN[24].reg1_reg ,
    \Dual.ALLOUT0_ND_G1.READ_REG_GEN[23].reg1_reg ,
    \Dual.ALLOUT0_ND_G1.READ_REG_GEN[22].reg1_reg ,
    \Dual.ALLOUT0_ND_G1.READ_REG_GEN[21].reg1_reg ,
    \Dual.ALLOUT0_ND_G1.READ_REG_GEN[20].reg1_reg ,
    \Dual.ALLOUT0_ND_G1.READ_REG_GEN[19].reg1_reg ,
    \Dual.ALLOUT0_ND_G1.READ_REG_GEN[18].reg1_reg ,
    \Dual.ALLOUT0_ND_G1.READ_REG_GEN[17].reg1_reg ,
    \Dual.ALLOUT0_ND_G1.READ_REG_GEN[16].reg1_reg ,
    \Dual.ALLOUT0_ND_G1.READ_REG_GEN[15].reg1_reg ,
    \Dual.ALLOUT0_ND_G1.READ_REG_GEN[14].reg1_reg ,
    \Dual.ALLOUT0_ND_G1.READ_REG_GEN[13].reg1_reg ,
    \Dual.ALLOUT0_ND_G1.READ_REG_GEN[12].reg1_reg ,
    \Dual.ALLOUT0_ND_G1.READ_REG_GEN[11].reg1_reg ,
    \Dual.ALLOUT0_ND_G1.READ_REG_GEN[10].reg1_reg ,
    \Dual.ALLOUT0_ND_G1.READ_REG_GEN[9].reg1_reg ,
    \Dual.ALLOUT0_ND_G1.READ_REG_GEN[8].reg1_reg ,
    \Dual.ALLOUT0_ND_G1.READ_REG_GEN[7].reg1_reg ,
    \Dual.ALLOUT0_ND_G1.READ_REG_GEN[6].reg1_reg ,
    \Dual.ALLOUT0_ND_G1.READ_REG_GEN[5].reg1_reg ,
    \Dual.ALLOUT0_ND_G1.READ_REG_GEN[4].reg1_reg ,
    \Dual.ALLOUT0_ND_G1.READ_REG_GEN[3].reg1_reg ,
    \Dual.ALLOUT0_ND_G1.READ_REG_GEN[2].reg1_reg ,
    \Dual.ALLOUT0_ND_G1.READ_REG_GEN[1].reg1_reg ,
    \Dual.ALLOUT0_ND_G1.READ_REG_GEN[0].reg1_reg ,
    ip2bus_rdack_i_D1,
    ip2bus_wrack_i_D1,
    s_axi_araddr,
    s_axi_awaddr);
  output bus2ip_reset;
  output bus2ip_rnw;
  output s_axi_rvalid_i_reg;
  output s_axi_bvalid_i_reg;
  output bus2ip_cs;
  output [0:0]E;
  output [0:0]bus2ip_rnw_i_reg;
  output ip2bus_rdack_i_D1_reg;
  output ip2bus_wrack_i_D1_reg;
  output bus2ip_rnw_i_reg_0;
  output [31:0]s_axi_rdata;
  output [31:0]D;
  input s_axi_aclk;
  input s_axi_arvalid;
  input s_axi_rready;
  input s_axi_bready;
  input s_axi_aresetn;
  input s_axi_awvalid;
  input s_axi_wvalid;
  input GPIO_xferAck_i;
  input gpio_xferAck_Reg;
  input [31:0]Q;
  input \Dual.ALLOUT0_ND_G1.READ_REG_GEN[31].reg1_reg ;
  input [0:31]reg3;
  input \Dual.ALLOUT0_ND_G1.READ_REG_GEN[30].reg1_reg ;
  input \Dual.ALLOUT0_ND_G1.READ_REG_GEN[29].reg1_reg ;
  input \Dual.ALLOUT0_ND_G1.READ_REG_GEN[28].reg1_reg ;
  input \Dual.ALLOUT0_ND_G1.READ_REG_GEN[27].reg1_reg ;
  input \Dual.ALLOUT0_ND_G1.READ_REG_GEN[26].reg1_reg ;
  input \Dual.ALLOUT0_ND_G1.READ_REG_GEN[25].reg1_reg ;
  input \Dual.ALLOUT0_ND_G1.READ_REG_GEN[24].reg1_reg ;
  input \Dual.ALLOUT0_ND_G1.READ_REG_GEN[23].reg1_reg ;
  input \Dual.ALLOUT0_ND_G1.READ_REG_GEN[22].reg1_reg ;
  input \Dual.ALLOUT0_ND_G1.READ_REG_GEN[21].reg1_reg ;
  input \Dual.ALLOUT0_ND_G1.READ_REG_GEN[20].reg1_reg ;
  input \Dual.ALLOUT0_ND_G1.READ_REG_GEN[19].reg1_reg ;
  input \Dual.ALLOUT0_ND_G1.READ_REG_GEN[18].reg1_reg ;
  input \Dual.ALLOUT0_ND_G1.READ_REG_GEN[17].reg1_reg ;
  input \Dual.ALLOUT0_ND_G1.READ_REG_GEN[16].reg1_reg ;
  input \Dual.ALLOUT0_ND_G1.READ_REG_GEN[15].reg1_reg ;
  input \Dual.ALLOUT0_ND_G1.READ_REG_GEN[14].reg1_reg ;
  input \Dual.ALLOUT0_ND_G1.READ_REG_GEN[13].reg1_reg ;
  input \Dual.ALLOUT0_ND_G1.READ_REG_GEN[12].reg1_reg ;
  input \Dual.ALLOUT0_ND_G1.READ_REG_GEN[11].reg1_reg ;
  input \Dual.ALLOUT0_ND_G1.READ_REG_GEN[10].reg1_reg ;
  input \Dual.ALLOUT0_ND_G1.READ_REG_GEN[9].reg1_reg ;
  input \Dual.ALLOUT0_ND_G1.READ_REG_GEN[8].reg1_reg ;
  input \Dual.ALLOUT0_ND_G1.READ_REG_GEN[7].reg1_reg ;
  input \Dual.ALLOUT0_ND_G1.READ_REG_GEN[6].reg1_reg ;
  input \Dual.ALLOUT0_ND_G1.READ_REG_GEN[5].reg1_reg ;
  input \Dual.ALLOUT0_ND_G1.READ_REG_GEN[4].reg1_reg ;
  input \Dual.ALLOUT0_ND_G1.READ_REG_GEN[3].reg1_reg ;
  input \Dual.ALLOUT0_ND_G1.READ_REG_GEN[2].reg1_reg ;
  input \Dual.ALLOUT0_ND_G1.READ_REG_GEN[1].reg1_reg ;
  input \Dual.ALLOUT0_ND_G1.READ_REG_GEN[0].reg1_reg ;
  input ip2bus_rdack_i_D1;
  input ip2bus_wrack_i_D1;
  input [2:0]s_axi_araddr;
  input [2:0]s_axi_awaddr;

  wire [31:0]D;
  wire \Dual.ALLOUT0_ND_G1.READ_REG_GEN[0].reg1_reg ;
  wire \Dual.ALLOUT0_ND_G1.READ_REG_GEN[10].reg1_reg ;
  wire \Dual.ALLOUT0_ND_G1.READ_REG_GEN[11].reg1_reg ;
  wire \Dual.ALLOUT0_ND_G1.READ_REG_GEN[12].reg1_reg ;
  wire \Dual.ALLOUT0_ND_G1.READ_REG_GEN[13].reg1_reg ;
  wire \Dual.ALLOUT0_ND_G1.READ_REG_GEN[14].reg1_reg ;
  wire \Dual.ALLOUT0_ND_G1.READ_REG_GEN[15].reg1_reg ;
  wire \Dual.ALLOUT0_ND_G1.READ_REG_GEN[16].reg1_reg ;
  wire \Dual.ALLOUT0_ND_G1.READ_REG_GEN[17].reg1_reg ;
  wire \Dual.ALLOUT0_ND_G1.READ_REG_GEN[18].reg1_reg ;
  wire \Dual.ALLOUT0_ND_G1.READ_REG_GEN[19].reg1_reg ;
  wire \Dual.ALLOUT0_ND_G1.READ_REG_GEN[1].reg1_reg ;
  wire \Dual.ALLOUT0_ND_G1.READ_REG_GEN[20].reg1_reg ;
  wire \Dual.ALLOUT0_ND_G1.READ_REG_GEN[21].reg1_reg ;
  wire \Dual.ALLOUT0_ND_G1.READ_REG_GEN[22].reg1_reg ;
  wire \Dual.ALLOUT0_ND_G1.READ_REG_GEN[23].reg1_reg ;
  wire \Dual.ALLOUT0_ND_G1.READ_REG_GEN[24].reg1_reg ;
  wire \Dual.ALLOUT0_ND_G1.READ_REG_GEN[25].reg1_reg ;
  wire \Dual.ALLOUT0_ND_G1.READ_REG_GEN[26].reg1_reg ;
  wire \Dual.ALLOUT0_ND_G1.READ_REG_GEN[27].reg1_reg ;
  wire \Dual.ALLOUT0_ND_G1.READ_REG_GEN[28].reg1_reg ;
  wire \Dual.ALLOUT0_ND_G1.READ_REG_GEN[29].reg1_reg ;
  wire \Dual.ALLOUT0_ND_G1.READ_REG_GEN[2].reg1_reg ;
  wire \Dual.ALLOUT0_ND_G1.READ_REG_GEN[30].reg1_reg ;
  wire \Dual.ALLOUT0_ND_G1.READ_REG_GEN[31].reg1_reg ;
  wire \Dual.ALLOUT0_ND_G1.READ_REG_GEN[3].reg1_reg ;
  wire \Dual.ALLOUT0_ND_G1.READ_REG_GEN[4].reg1_reg ;
  wire \Dual.ALLOUT0_ND_G1.READ_REG_GEN[5].reg1_reg ;
  wire \Dual.ALLOUT0_ND_G1.READ_REG_GEN[6].reg1_reg ;
  wire \Dual.ALLOUT0_ND_G1.READ_REG_GEN[7].reg1_reg ;
  wire \Dual.ALLOUT0_ND_G1.READ_REG_GEN[8].reg1_reg ;
  wire \Dual.ALLOUT0_ND_G1.READ_REG_GEN[9].reg1_reg ;
  wire [0:0]E;
  wire GPIO_xferAck_i;
  wire [31:0]Q;
  wire bus2ip_cs;
  wire bus2ip_reset;
  wire bus2ip_rnw;
  wire [0:0]bus2ip_rnw_i_reg;
  wire bus2ip_rnw_i_reg_0;
  wire gpio_xferAck_Reg;
  wire ip2bus_rdack_i_D1;
  wire ip2bus_rdack_i_D1_reg;
  wire ip2bus_wrack_i_D1;
  wire ip2bus_wrack_i_D1_reg;
  wire [0:31]reg3;
  wire s_axi_aclk;
  wire [2:0]s_axi_araddr;
  wire s_axi_aresetn;
  wire s_axi_arvalid;
  wire [2:0]s_axi_awaddr;
  wire s_axi_awvalid;
  wire s_axi_bready;
  wire s_axi_bvalid_i_reg;
  wire [31:0]s_axi_rdata;
  wire s_axi_rready;
  wire s_axi_rvalid_i_reg;
  wire s_axi_wvalid;

  decalper_eb_ot_sdeen_pot_pi_dehcac_xnilix_slave_attachment I_SLAVE_ATTACHMENT
       (.D(D),
        .\Dual.ALLOUT0_ND_G1.READ_REG_GEN[0].reg1_reg (\Dual.ALLOUT0_ND_G1.READ_REG_GEN[0].reg1_reg ),
        .\Dual.ALLOUT0_ND_G1.READ_REG_GEN[10].reg1_reg (\Dual.ALLOUT0_ND_G1.READ_REG_GEN[10].reg1_reg ),
        .\Dual.ALLOUT0_ND_G1.READ_REG_GEN[11].reg1_reg (\Dual.ALLOUT0_ND_G1.READ_REG_GEN[11].reg1_reg ),
        .\Dual.ALLOUT0_ND_G1.READ_REG_GEN[12].reg1_reg (\Dual.ALLOUT0_ND_G1.READ_REG_GEN[12].reg1_reg ),
        .\Dual.ALLOUT0_ND_G1.READ_REG_GEN[13].reg1_reg (\Dual.ALLOUT0_ND_G1.READ_REG_GEN[13].reg1_reg ),
        .\Dual.ALLOUT0_ND_G1.READ_REG_GEN[14].reg1_reg (\Dual.ALLOUT0_ND_G1.READ_REG_GEN[14].reg1_reg ),
        .\Dual.ALLOUT0_ND_G1.READ_REG_GEN[15].reg1_reg (\Dual.ALLOUT0_ND_G1.READ_REG_GEN[15].reg1_reg ),
        .\Dual.ALLOUT0_ND_G1.READ_REG_GEN[16].reg1_reg (\Dual.ALLOUT0_ND_G1.READ_REG_GEN[16].reg1_reg ),
        .\Dual.ALLOUT0_ND_G1.READ_REG_GEN[17].reg1_reg (\Dual.ALLOUT0_ND_G1.READ_REG_GEN[17].reg1_reg ),
        .\Dual.ALLOUT0_ND_G1.READ_REG_GEN[18].reg1_reg (\Dual.ALLOUT0_ND_G1.READ_REG_GEN[18].reg1_reg ),
        .\Dual.ALLOUT0_ND_G1.READ_REG_GEN[19].reg1_reg (\Dual.ALLOUT0_ND_G1.READ_REG_GEN[19].reg1_reg ),
        .\Dual.ALLOUT0_ND_G1.READ_REG_GEN[1].reg1_reg (\Dual.ALLOUT0_ND_G1.READ_REG_GEN[1].reg1_reg ),
        .\Dual.ALLOUT0_ND_G1.READ_REG_GEN[20].reg1_reg (\Dual.ALLOUT0_ND_G1.READ_REG_GEN[20].reg1_reg ),
        .\Dual.ALLOUT0_ND_G1.READ_REG_GEN[21].reg1_reg (\Dual.ALLOUT0_ND_G1.READ_REG_GEN[21].reg1_reg ),
        .\Dual.ALLOUT0_ND_G1.READ_REG_GEN[22].reg1_reg (\Dual.ALLOUT0_ND_G1.READ_REG_GEN[22].reg1_reg ),
        .\Dual.ALLOUT0_ND_G1.READ_REG_GEN[23].reg1_reg (\Dual.ALLOUT0_ND_G1.READ_REG_GEN[23].reg1_reg ),
        .\Dual.ALLOUT0_ND_G1.READ_REG_GEN[24].reg1_reg (\Dual.ALLOUT0_ND_G1.READ_REG_GEN[24].reg1_reg ),
        .\Dual.ALLOUT0_ND_G1.READ_REG_GEN[25].reg1_reg (\Dual.ALLOUT0_ND_G1.READ_REG_GEN[25].reg1_reg ),
        .\Dual.ALLOUT0_ND_G1.READ_REG_GEN[26].reg1_reg (\Dual.ALLOUT0_ND_G1.READ_REG_GEN[26].reg1_reg ),
        .\Dual.ALLOUT0_ND_G1.READ_REG_GEN[27].reg1_reg (\Dual.ALLOUT0_ND_G1.READ_REG_GEN[27].reg1_reg ),
        .\Dual.ALLOUT0_ND_G1.READ_REG_GEN[28].reg1_reg (\Dual.ALLOUT0_ND_G1.READ_REG_GEN[28].reg1_reg ),
        .\Dual.ALLOUT0_ND_G1.READ_REG_GEN[29].reg1_reg (\Dual.ALLOUT0_ND_G1.READ_REG_GEN[29].reg1_reg ),
        .\Dual.ALLOUT0_ND_G1.READ_REG_GEN[2].reg1_reg (\Dual.ALLOUT0_ND_G1.READ_REG_GEN[2].reg1_reg ),
        .\Dual.ALLOUT0_ND_G1.READ_REG_GEN[30].reg1_reg (\Dual.ALLOUT0_ND_G1.READ_REG_GEN[30].reg1_reg ),
        .\Dual.ALLOUT0_ND_G1.READ_REG_GEN[31].reg1_reg (\Dual.ALLOUT0_ND_G1.READ_REG_GEN[31].reg1_reg ),
        .\Dual.ALLOUT0_ND_G1.READ_REG_GEN[3].reg1_reg (\Dual.ALLOUT0_ND_G1.READ_REG_GEN[3].reg1_reg ),
        .\Dual.ALLOUT0_ND_G1.READ_REG_GEN[4].reg1_reg (\Dual.ALLOUT0_ND_G1.READ_REG_GEN[4].reg1_reg ),
        .\Dual.ALLOUT0_ND_G1.READ_REG_GEN[5].reg1_reg (\Dual.ALLOUT0_ND_G1.READ_REG_GEN[5].reg1_reg ),
        .\Dual.ALLOUT0_ND_G1.READ_REG_GEN[6].reg1_reg (\Dual.ALLOUT0_ND_G1.READ_REG_GEN[6].reg1_reg ),
        .\Dual.ALLOUT0_ND_G1.READ_REG_GEN[7].reg1_reg (\Dual.ALLOUT0_ND_G1.READ_REG_GEN[7].reg1_reg ),
        .\Dual.ALLOUT0_ND_G1.READ_REG_GEN[8].reg1_reg (\Dual.ALLOUT0_ND_G1.READ_REG_GEN[8].reg1_reg ),
        .\Dual.ALLOUT0_ND_G1.READ_REG_GEN[9].reg1_reg (\Dual.ALLOUT0_ND_G1.READ_REG_GEN[9].reg1_reg ),
        .E(E),
        .GPIO_xferAck_i(GPIO_xferAck_i),
        .\MEM_DECODE_GEN[0].cs_out_i_reg[0] (bus2ip_cs),
        .Q(Q),
        .SR(bus2ip_reset),
        .bus2ip_rnw_i_reg_0(bus2ip_rnw),
        .bus2ip_rnw_i_reg_1(bus2ip_rnw_i_reg),
        .bus2ip_rnw_i_reg_2(bus2ip_rnw_i_reg_0),
        .gpio_xferAck_Reg(gpio_xferAck_Reg),
        .ip2bus_rdack_i_D1(ip2bus_rdack_i_D1),
        .ip2bus_rdack_i_D1_reg(ip2bus_rdack_i_D1_reg),
        .ip2bus_wrack_i_D1(ip2bus_wrack_i_D1),
        .ip2bus_wrack_i_D1_reg(ip2bus_wrack_i_D1_reg),
        .reg3(reg3),
        .s_axi_aclk(s_axi_aclk),
        .s_axi_araddr(s_axi_araddr),
        .s_axi_aresetn(s_axi_aresetn),
        .s_axi_arvalid(s_axi_arvalid),
        .s_axi_awaddr(s_axi_awaddr),
        .s_axi_awvalid(s_axi_awvalid),
        .s_axi_bready(s_axi_bready),
        .s_axi_bvalid_i_reg_0(s_axi_bvalid_i_reg),
        .s_axi_rdata(s_axi_rdata),
        .s_axi_rready(s_axi_rready),
        .s_axi_rvalid_i_reg_0(s_axi_rvalid_i_reg),
        .s_axi_wvalid(s_axi_wvalid));
endmodule

(* CHECK_LICENSE_TYPE = "projectHW_DAC2_CTRL_0,axi_gpio,{}" *) (* downgradeipidentifiedwarnings = "yes" *) (* x_core_info = "axi_gpio,Vivado 2021.1" *) 
(* NotValidForBitStream *)
module decalper_eb_ot_sdeen_pot_pi_dehcac_xnilix
   (s_axi_aclk,
    s_axi_aresetn,
    s_axi_awaddr,
    s_axi_awvalid,
    s_axi_awready,
    s_axi_wdata,
    s_axi_wstrb,
    s_axi_wvalid,
    s_axi_wready,
    s_axi_bresp,
    s_axi_bvalid,
    s_axi_bready,
    s_axi_araddr,
    s_axi_arvalid,
    s_axi_arready,
    s_axi_rdata,
    s_axi_rresp,
    s_axi_rvalid,
    s_axi_rready,
    gpio_io_o,
    gpio2_io_o);
  (* x_interface_info = "xilinx.com:signal:clock:1.0 S_AXI_ACLK CLK" *) (* x_interface_parameter = "XIL_INTERFACENAME S_AXI_ACLK, ASSOCIATED_BUSIF S_AXI, ASSOCIATED_RESET s_axi_aresetn, FREQ_HZ 125000000, FREQ_TOLERANCE_HZ 0, PHASE 0.0, CLK_DOMAIN projectHW_processing_system7_0_0_FCLK_CLK0, INSERT_VIP 0" *) input s_axi_aclk;
  (* x_interface_info = "xilinx.com:signal:reset:1.0 S_AXI_ARESETN RST" *) (* x_interface_parameter = "XIL_INTERFACENAME S_AXI_ARESETN, POLARITY ACTIVE_LOW, INSERT_VIP 0" *) input s_axi_aresetn;
  (* x_interface_info = "xilinx.com:interface:aximm:1.0 S_AXI AWADDR" *) (* x_interface_parameter = "XIL_INTERFACENAME S_AXI, DATA_WIDTH 32, PROTOCOL AXI4LITE, FREQ_HZ 125000000, ID_WIDTH 0, ADDR_WIDTH 9, AWUSER_WIDTH 0, ARUSER_WIDTH 0, WUSER_WIDTH 0, RUSER_WIDTH 0, BUSER_WIDTH 0, READ_WRITE_MODE READ_WRITE, HAS_BURST 0, HAS_LOCK 0, HAS_PROT 0, HAS_CACHE 0, HAS_QOS 0, HAS_REGION 0, HAS_WSTRB 1, HAS_BRESP 1, HAS_RRESP 1, SUPPORTS_NARROW_BURST 0, NUM_READ_OUTSTANDING 2, NUM_WRITE_OUTSTANDING 2, MAX_BURST_LENGTH 1, PHASE 0.0, CLK_DOMAIN projectHW_processing_system7_0_0_FCLK_CLK0, NUM_READ_THREADS 1, NUM_WRITE_THREADS 1, RUSER_BITS_PER_BYTE 0, WUSER_BITS_PER_BYTE 0, INSERT_VIP 0" *) input [8:0]s_axi_awaddr;
  (* x_interface_info = "xilinx.com:interface:aximm:1.0 S_AXI AWVALID" *) input s_axi_awvalid;
  (* x_interface_info = "xilinx.com:interface:aximm:1.0 S_AXI AWREADY" *) output s_axi_awready;
  (* x_interface_info = "xilinx.com:interface:aximm:1.0 S_AXI WDATA" *) input [31:0]s_axi_wdata;
  (* x_interface_info = "xilinx.com:interface:aximm:1.0 S_AXI WSTRB" *) input [3:0]s_axi_wstrb;
  (* x_interface_info = "xilinx.com:interface:aximm:1.0 S_AXI WVALID" *) input s_axi_wvalid;
  (* x_interface_info = "xilinx.com:interface:aximm:1.0 S_AXI WREADY" *) output s_axi_wready;
  (* x_interface_info = "xilinx.com:interface:aximm:1.0 S_AXI BRESP" *) output [1:0]s_axi_bresp;
  (* x_interface_info = "xilinx.com:interface:aximm:1.0 S_AXI BVALID" *) output s_axi_bvalid;
  (* x_interface_info = "xilinx.com:interface:aximm:1.0 S_AXI BREADY" *) input s_axi_bready;
  (* x_interface_info = "xilinx.com:interface:aximm:1.0 S_AXI ARADDR" *) input [8:0]s_axi_araddr;
  (* x_interface_info = "xilinx.com:interface:aximm:1.0 S_AXI ARVALID" *) input s_axi_arvalid;
  (* x_interface_info = "xilinx.com:interface:aximm:1.0 S_AXI ARREADY" *) output s_axi_arready;
  (* x_interface_info = "xilinx.com:interface:aximm:1.0 S_AXI RDATA" *) output [31:0]s_axi_rdata;
  (* x_interface_info = "xilinx.com:interface:aximm:1.0 S_AXI RRESP" *) output [1:0]s_axi_rresp;
  (* x_interface_info = "xilinx.com:interface:aximm:1.0 S_AXI RVALID" *) output s_axi_rvalid;
  (* x_interface_info = "xilinx.com:interface:aximm:1.0 S_AXI RREADY" *) input s_axi_rready;
  (* x_interface_info = "xilinx.com:interface:gpio:1.0 GPIO TRI_O" *) (* x_interface_parameter = "XIL_INTERFACENAME GPIO, BOARD.ASSOCIATED_PARAM GPIO_BOARD_INTERFACE" *) output [31:0]gpio_io_o;
  (* x_interface_info = "xilinx.com:interface:gpio:1.0 GPIO2 TRI_O" *) (* x_interface_parameter = "XIL_INTERFACENAME GPIO2, BOARD.ASSOCIATED_PARAM GPIO2_BOARD_INTERFACE" *) output [31:0]gpio2_io_o;

  wire \<const0> ;
  wire [31:0]gpio2_io_o;
  wire [31:0]gpio_io_o;
  wire s_axi_aclk;
  wire [8:0]s_axi_araddr;
  wire s_axi_aresetn;
  wire s_axi_arready;
  wire s_axi_arvalid;
  wire [8:0]s_axi_awaddr;
  wire s_axi_awready;
  wire s_axi_awvalid;
  wire s_axi_bready;
  wire s_axi_bvalid;
  wire [31:0]s_axi_rdata;
  wire s_axi_rready;
  wire s_axi_rvalid;
  wire [31:0]s_axi_wdata;
  wire s_axi_wready;
  wire s_axi_wvalid;
  wire NLW_U0_ip2intc_irpt_UNCONNECTED;
  wire [31:0]NLW_U0_gpio2_io_t_UNCONNECTED;
  wire [31:0]NLW_U0_gpio_io_t_UNCONNECTED;
  wire [1:0]NLW_U0_s_axi_bresp_UNCONNECTED;
  wire [1:0]NLW_U0_s_axi_rresp_UNCONNECTED;

  assign s_axi_bresp[1] = \<const0> ;
  assign s_axi_bresp[0] = \<const0> ;
  assign s_axi_rresp[1] = \<const0> ;
  assign s_axi_rresp[0] = \<const0> ;
  GND GND
       (.G(\<const0> ));
  (* C_ALL_INPUTS = "0" *) 
  (* C_ALL_INPUTS_2 = "0" *) 
  (* C_ALL_OUTPUTS = "1" *) 
  (* C_ALL_OUTPUTS_2 = "1" *) 
  (* C_DOUT_DEFAULT = "0" *) 
  (* C_DOUT_DEFAULT_2 = "0" *) 
  (* C_FAMILY = "zynq" *) 
  (* C_GPIO2_WIDTH = "32" *) 
  (* C_GPIO_WIDTH = "32" *) 
  (* C_INTERRUPT_PRESENT = "0" *) 
  (* C_IS_DUAL = "1" *) 
  (* C_S_AXI_ADDR_WIDTH = "9" *) 
  (* C_S_AXI_DATA_WIDTH = "32" *) 
  (* C_TRI_DEFAULT = "-1" *) 
  (* C_TRI_DEFAULT_2 = "-1" *) 
  (* downgradeipidentifiedwarnings = "yes" *) 
  (* ip_group = "LOGICORE" *) 
  decalper_eb_ot_sdeen_pot_pi_dehcac_xnilix_axi_gpio U0
       (.gpio2_io_i({1'b0,1'b0,1'b0,1'b0,1'b0,1'b0,1'b0,1'b0,1'b0,1'b0,1'b0,1'b0,1'b0,1'b0,1'b0,1'b0,1'b0,1'b0,1'b0,1'b0,1'b0,1'b0,1'b0,1'b0,1'b0,1'b0,1'b0,1'b0,1'b0,1'b0,1'b0,1'b0}),
        .gpio2_io_o(gpio2_io_o),
        .gpio2_io_t(NLW_U0_gpio2_io_t_UNCONNECTED[31:0]),
        .gpio_io_i({1'b0,1'b0,1'b0,1'b0,1'b0,1'b0,1'b0,1'b0,1'b0,1'b0,1'b0,1'b0,1'b0,1'b0,1'b0,1'b0,1'b0,1'b0,1'b0,1'b0,1'b0,1'b0,1'b0,1'b0,1'b0,1'b0,1'b0,1'b0,1'b0,1'b0,1'b0,1'b0}),
        .gpio_io_o(gpio_io_o),
        .gpio_io_t(NLW_U0_gpio_io_t_UNCONNECTED[31:0]),
        .ip2intc_irpt(NLW_U0_ip2intc_irpt_UNCONNECTED),
        .s_axi_aclk(s_axi_aclk),
        .s_axi_araddr({s_axi_araddr[8],1'b0,1'b0,1'b0,1'b0,s_axi_araddr[3:2],1'b0,1'b0}),
        .s_axi_aresetn(s_axi_aresetn),
        .s_axi_arready(s_axi_arready),
        .s_axi_arvalid(s_axi_arvalid),
        .s_axi_awaddr({s_axi_awaddr[8],1'b0,1'b0,1'b0,1'b0,s_axi_awaddr[3:2],1'b0,1'b0}),
        .s_axi_awready(s_axi_awready),
        .s_axi_awvalid(s_axi_awvalid),
        .s_axi_bready(s_axi_bready),
        .s_axi_bresp(NLW_U0_s_axi_bresp_UNCONNECTED[1:0]),
        .s_axi_bvalid(s_axi_bvalid),
        .s_axi_rdata(s_axi_rdata),
        .s_axi_rready(s_axi_rready),
        .s_axi_rresp(NLW_U0_s_axi_rresp_UNCONNECTED[1:0]),
        .s_axi_rvalid(s_axi_rvalid),
        .s_axi_wdata(s_axi_wdata),
        .s_axi_wready(s_axi_wready),
        .s_axi_wstrb({1'b0,1'b0,1'b0,1'b0}),
        .s_axi_wvalid(s_axi_wvalid));
endmodule

module decalper_eb_ot_sdeen_pot_pi_dehcac_xnilix_pselect_f
   (ce_expnd_i_3,
    \GEN_BKEND_CE_REGISTERS[0].ce_out_i_reg[0] );
  output ce_expnd_i_3;
  input [1:0]\GEN_BKEND_CE_REGISTERS[0].ce_out_i_reg[0] ;

  wire [1:0]\GEN_BKEND_CE_REGISTERS[0].ce_out_i_reg[0] ;
  wire ce_expnd_i_3;

  LUT2 #(
    .INIT(4'h1)) 
    CS
       (.I0(\GEN_BKEND_CE_REGISTERS[0].ce_out_i_reg[0] [0]),
        .I1(\GEN_BKEND_CE_REGISTERS[0].ce_out_i_reg[0] [1]),
        .O(ce_expnd_i_3));
endmodule

(* ORIG_REF_NAME = "pselect_f" *) 
module decalper_eb_ot_sdeen_pot_pi_dehcac_xnilix_pselect_f__parameterized1
   (ce_expnd_i_1,
    \GEN_BKEND_CE_REGISTERS[2].ce_out_i_reg[2] );
  output ce_expnd_i_1;
  input [1:0]\GEN_BKEND_CE_REGISTERS[2].ce_out_i_reg[2] ;

  wire [1:0]\GEN_BKEND_CE_REGISTERS[2].ce_out_i_reg[2] ;
  wire ce_expnd_i_1;

  LUT2 #(
    .INIT(4'h2)) 
    CS
       (.I0(\GEN_BKEND_CE_REGISTERS[2].ce_out_i_reg[2] [1]),
        .I1(\GEN_BKEND_CE_REGISTERS[2].ce_out_i_reg[2] [0]),
        .O(ce_expnd_i_1));
endmodule
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
