Tomash1A/FPGAPlatformController/VIVADO- PROJECT BUILDER SCRIPT/projectHW_ADC_build/adc/adc.cache/ip/2021.1/39b302ce77940c59/projectHW_DAC2_CTRL_0_sim_netlist.vhdl

-- Copyright 1986-2021 Xilinx, Inc. All Rights Reserved.
-- --------------------------------------------------------------------------------
-- Tool Version: Vivado v.2021.1 (win64) Build 3247384 Thu Jun 10 19:36:33 MDT 2021
-- Date        : Mon Jun 29 12:03:29 2026
-- Host        : CS-RO-PC29 running 64-bit major release  (build 9200)
-- Command     : write_vhdl -force -mode funcsim -rename_top decalper_eb_ot_sdeen_pot_pi_dehcac_xnilix -prefix
--               decalper_eb_ot_sdeen_pot_pi_dehcac_xnilix_ projectHW_DAC2_CTRL_0_sim_netlist.vhdl
-- Design      : projectHW_DAC2_CTRL_0
-- Purpose     : This VHDL netlist is a functional simulation representation of the design and should not be modified or
--               synthesized. This netlist cannot be used for SDF annotated simulation.
-- Device      : xc7z020clg400-1
-- --------------------------------------------------------------------------------
library IEEE;
use IEEE.STD_LOGIC_1164.ALL;
library UNISIM;
use UNISIM.VCOMPONENTS.ALL;
entity decalper_eb_ot_sdeen_pot_pi_dehcac_xnilix_GPIO_Core is
  port (
    \Dual.ALLOUT0_ND_G1.READ_REG_GEN[31].reg1_reg\ : out STD_LOGIC;
    gpio_io_o : out STD_LOGIC_VECTOR ( 31 downto 0 );
    \Dual.ALLOUT0_ND_G1.READ_REG_GEN[30].reg1_reg\ : out STD_LOGIC;
    \Dual.ALLOUT0_ND_G1.READ_REG_GEN[29].reg1_reg\ : out STD_LOGIC;
    \Dual.ALLOUT0_ND_G1.READ_REG_GEN[28].reg1_reg\ : out STD_LOGIC;
    \Dual.ALLOUT0_ND_G1.READ_REG_GEN[27].reg1_reg\ : out STD_LOGIC;
    \Dual.ALLOUT0_ND_G1.READ_REG_GEN[26].reg1_reg\ : out STD_LOGIC;
    \Dual.ALLOUT0_ND_G1.READ_REG_GEN[25].reg1_reg\ : out STD_LOGIC;
    \Dual.ALLOUT0_ND_G1.READ_REG_GEN[24].reg1_reg\ : out STD_LOGIC;
    \Dual.ALLOUT0_ND_G1.READ_REG_GEN[23].reg1_reg\ : out STD_LOGIC;
    \Dual.ALLOUT0_ND_G1.READ_REG_GEN[22].reg1_reg\ : out STD_LOGIC;
    \Dual.ALLOUT0_ND_G1.READ_REG_GEN[21].reg1_reg\ : out STD_LOGIC;
    \Dual.ALLOUT0_ND_G1.READ_REG_GEN[20].reg1_reg\ : out STD_LOGIC;
    \Dual.ALLOUT0_ND_G1.READ_REG_GEN[19].reg1_reg\ : out STD_LOGIC;
    \Dual.ALLOUT0_ND_G1.READ_REG_GEN[18].reg1_reg\ : out STD_LOGIC;
    \Dual.ALLOUT0_ND_G1.READ_REG_GEN[17].reg1_reg\ : out STD_LOGIC;
    \Dual.ALLOUT0_ND_G1.READ_REG_GEN[16].reg1_reg\ : out STD_LOGIC;
    \Dual.ALLOUT0_ND_G1.READ_REG_GEN[15].reg1_reg\ : out STD_LOGIC;
    \Dual.ALLOUT0_ND_G1.READ_REG_GEN[14].reg1_reg\ : out STD_LOGIC;
    \Dual.ALLOUT0_ND_G1.READ_REG_GEN[13].reg1_reg\ : out STD_LOGIC;
    \Dual.ALLOUT0_ND_G1.READ_REG_GEN[12].reg1_reg\ : out STD_LOGIC;
    \Dual.ALLOUT0_ND_G1.READ_REG_GEN[11].reg1_reg\ : out STD_LOGIC;
    \Dual.ALLOUT0_ND_G1.READ_REG_GEN[10].reg1_reg\ : out STD_LOGIC;
    \Dual.ALLOUT0_ND_G1.READ_REG_GEN[9].reg1_reg\ : out STD_LOGIC;
    \Dual.ALLOUT0_ND_G1.READ_REG_GEN[8].reg1_reg\ : out STD_LOGIC;
    \Dual.ALLOUT0_ND_G1.READ_REG_GEN[7].reg1_reg\ : out STD_LOGIC;
    \Dual.ALLOUT0_ND_G1.READ_REG_GEN[6].reg1_reg\ : out STD_LOGIC;
    \Dual.ALLOUT0_ND_G1.READ_REG_GEN[5].reg1_reg\ : out STD_LOGIC;
    \Dual.ALLOUT0_ND_G1.READ_REG_GEN[4].reg1_reg\ : out STD_LOGIC;
    \Dual.ALLOUT0_ND_G1.READ_REG_GEN[3].reg1_reg\ : out STD_LOGIC;
    \Dual.ALLOUT0_ND_G1.READ_REG_GEN[2].reg1_reg\ : out STD_LOGIC;
    \Dual.ALLOUT0_ND_G1.READ_REG_GEN[1].reg1_reg\ : out STD_LOGIC;
    \Dual.ALLOUT0_ND_G1.READ_REG_GEN[0].reg1_reg\ : out STD_LOGIC;
    reg3 : out STD_LOGIC_VECTOR ( 0 to 31 );
    gpio2_io_o : out STD_LOGIC_VECTOR ( 31 downto 0 );
    GPIO_xferAck_i : out STD_LOGIC;
    gpio_xferAck_Reg : out STD_LOGIC;
    ip2bus_wrack_i : out STD_LOGIC;
    ip2bus_rdack_i : out STD_LOGIC;
    \Dual.ALLOUT1_ND_G2.READ_REG2_GEN[0].reg3_reg[0]_0\ : in STD_LOGIC;
    s_axi_aclk : in STD_LOGIC;
    bus2ip_reset : in STD_LOGIC;
    bus2ip_cs : in STD_LOGIC;
    bus2ip_rnw : in STD_LOGIC;
    E : in STD_LOGIC_VECTOR ( 0 to 0 );
    s_axi_wdata : in STD_LOGIC_VECTOR ( 31 downto 0 );
    \Dual.gpio2_Data_Out_reg[0]_0\ : in STD_LOGIC_VECTOR ( 0 to 0 )
  );
end decalper_eb_ot_sdeen_pot_pi_dehcac_xnilix_GPIO_Core;

architecture STRUCTURE of decalper_eb_ot_sdeen_pot_pi_dehcac_xnilix_GPIO_Core is
  signal \^gpio_xferack_i\ : STD_LOGIC;
  signal \^gpio2_io_o\ : STD_LOGIC_VECTOR ( 31 downto 0 );
  signal \^gpio_io_o\ : STD_LOGIC_VECTOR ( 31 downto 0 );
  signal \^gpio_xferack_reg\ : STD_LOGIC;
  signal iGPIO_xferAck : STD_LOGIC;
  attribute SOFT_HLUTNM : string;
  attribute SOFT_HLUTNM of \/i_\ : label is "soft_lutpair6";
  attribute SOFT_HLUTNM of ip2bus_wrack_i_D1_i_1 : label is "soft_lutpair6";
begin
  GPIO_xferAck_i <= \^gpio_xferack_i\;
  gpio2_io_o(31 downto 0) <= \^gpio2_io_o\(31 downto 0);
  gpio_io_o(31 downto 0) <= \^gpio_io_o\(31 downto 0);
  gpio_xferAck_Reg <= \^gpio_xferack_reg\;
\/i_\: unisim.vcomponents.LUT3
    generic map(
      INIT => X"04"
    )
        port map (
      I0 => \^gpio_xferack_reg\,
      I1 => bus2ip_cs,
      I2 => \^gpio_xferack_i\,
      O => iGPIO_xferAck
    );
\Dual.ALLOUT0_ND_G1.READ_REG_GEN[0].reg1_reg[0]\: unisim.vcomponents.FDRE
     port map (
      C => s_axi_aclk,
      CE => '1',
      D => \^gpio_io_o\(31),
      Q => \Dual.ALLOUT0_ND_G1.READ_REG_GEN[0].reg1_reg\,
      R => \Dual.ALLOUT1_ND_G2.READ_REG2_GEN[0].reg3_reg[0]_0\
    );
\Dual.ALLOUT0_ND_G1.READ_REG_GEN[10].reg1_reg[10]\: unisim.vcomponents.FDRE
     port map (
      C => s_axi_aclk,
      CE => '1',
      D => \^gpio_io_o\(21),
      Q => \Dual.ALLOUT0_ND_G1.READ_REG_GEN[10].reg1_reg\,
      R => \Dual.ALLOUT1_ND_G2.READ_REG2_GEN[0].reg3_reg[0]_0\
    );
\Dual.ALLOUT0_ND_G1.READ_REG_GEN[11].reg1_reg[11]\: unisim.vcomponents.FDRE
     port map (
      C => s_axi_aclk,
      CE => '1',
      D => \^gpio_io_o\(20),
      Q => \Dual.ALLOUT0_ND_G1.READ_REG_GEN[11].reg1_reg\,
      R => \Dual.ALLOUT1_ND_G2.READ_REG2_GEN[0].reg3_reg[0]_0\
    );
\Dual.ALLOUT0_ND_G1.READ_REG_GEN[12].reg1_reg[12]\: unisim.vcomponents.FDRE
     port map (
      C => s_axi_aclk,
      CE => '1',
      D => \^gpio_io_o\(19),
      Q => \Dual.ALLOUT0_ND_G1.READ_REG_GEN[12].reg1_reg\,
      R => \Dual.ALLOUT1_ND_G2.READ_REG2_GEN[0].reg3_reg[0]_0\
    );
\Dual.ALLOUT0_ND_G1.READ_REG_GEN[13].reg1_reg[13]\: unisim.vcomponents.FDRE
     port map (
      C => s_axi_aclk,
      CE => '1',
      D => \^gpio_io_o\(18),
      Q => \Dual.ALLOUT0_ND_G1.READ_REG_GEN[13].reg1_reg\,
      R => \Dual.ALLOUT1_ND_G2.READ_REG2_GEN[0].reg3_reg[0]_0\
    );
\Dual.ALLOUT0_ND_G1.READ_REG_GEN[14].reg1_reg[14]\: unisim.vcomponents.FDRE
     port map (
      C => s_axi_aclk,
      CE => '1',
      D => \^gpio_io_o\(17),
      Q => \Dual.ALLOUT0_ND_G1.READ_REG_GEN[14].reg1_reg\,
      R => \Dual.ALLOUT1_ND_G2.READ_REG2_GEN[0].reg3_reg[0]_0\
    );
\Dual.ALLOUT0_ND_G1.READ_REG_GEN[15].reg1_reg[15]\: unisim.vcomponents.FDRE
     port map (
      C => s_axi_aclk,
      CE => '1',
      D => \^gpio_io_o\(16),
      Q => \Dual.ALLOUT0_ND_G1.READ_REG_GEN[15].reg1_reg\,
      R => \Dual.ALLOUT1_ND_G2.READ_REG2_GEN[0].reg3_reg[0]_0\
    );
\Dual.ALLOUT0_ND_G1.READ_REG_GEN[16].reg1_reg[16]\: unisim.vcomponents.FDRE
     port map (
      C => s_axi_aclk,
      CE => '1',
      D => \^gpio_io_o\(15),
      Q => \Dual.ALLOUT0_ND_G1.READ_REG_GEN[16].reg1_reg\,
      R => \Dual.ALLOUT1_ND_G2.READ_REG2_GEN[0].reg3_reg[0]_0\
    );
\Dual.ALLOUT0_ND_G1.READ_REG_GEN[17].reg1_reg[17]\: unisim.vcomponents.FDRE
     port map (
      C => s_axi_aclk,
      CE => '1',
      D => \^gpio_io_o\(14),
      Q => \Dual.ALLOUT0_ND_G1.READ_REG_GEN[17].reg1_reg\,
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
    generic map(
      INIT => '0'
    )
        port map (
      C => s_axi_aclk,
      CE => E(0),
      D => s_axi_wdata(22),
      Q => \^gpio_io_o\(22),
      R => bus2ip_reset
    );
gpio_xferAck_Reg_reg: unisim.vcomponents.FDRE
     port map (
      C => s_axi_aclk,
      CE => '1',
      D => \^gpio_xferack_i\,
      Q => \^gpio_xferack_reg\,
      R => bus2ip_reset
    );
iGPIO_xferAck_reg: unisim.vcomponents.FDRE
     port map (
      C => s_axi_aclk,
      CE => '1',
      D => iGPIO_xferAck,
      Q => \^gpio_xferack_i\,
      R => bus2ip_reset
    );
ip2bus_rdack_i_D1_i_1: unisim.vcomponents.LUT2
    generic map(
      INIT => X"8"
    )
        port map (
      I0 => \^gpio_xferack_i\,
      I1 => bus2ip_rnw,
      O => ip2bus_rdack_i
    );
ip2bus_wrack_i_D1_i_1: unisim.vcomponents.LUT2
    generic map(
      INIT => X"2"
    )
        port map (
      I0 => \^gpio_xferack_i\,
      I1 => bus2ip_rnw,
      O => ip2bus_wrack_i
    );
end STRUCTURE;
library IEEE;
use IEEE.STD_LOGIC_1164.ALL;
library UNISIM;
use UNISIM.VCOMPONENTS.ALL;
entity decalper_eb_ot_sdeen_pot_pi_dehcac_xnilix_pselect_f is
  port (
    ce_expnd_i_3 : out STD_LOGIC;
    \GEN_BKEND_CE_REGISTERS[0].ce_out_i_reg[0]\ : in STD_LOGIC_VECTOR ( 1 downto 0 )
  );
end decalper_eb_ot_sdeen_pot_pi_dehcac_xnilix_pselect_f;

architecture STRUCTURE of decalper_eb_ot_sdeen_pot_pi_dehcac_xnilix_pselect_f is
begin
CS: unisim.vcomponents.LUT2
    generic map(
      INIT => X"1"
    )
        port map (
      I0 => \GEN_BKEND_CE_REGISTERS[0].ce_out_i_reg[0]\(0),
      I1 => \GEN_BKEND_CE_REGISTERS[0].ce_out_i_reg[0]\(1),
      O => ce_expnd_i_3
    );
end STRUCTURE;
library IEEE;
use IEEE.STD_LOGIC_1164.ALL;
library UNISIM;
use UNISIM.VCOMPONENTS.ALL;
entity \decalper_eb_ot_sdeen_pot_pi_dehcac_xnilix_pselect_f__parameterized1\ is
  port (
    ce_expnd_i_1 : out STD_LOGIC;
    \GEN_BKEND_CE_REGISTERS[2].ce_out_i_reg[2]\ : in STD_LOGIC_VECTOR ( 1 downto 0 )
  );
  attribute ORIG_REF_NAME : string;
  attribute ORIG_REF_NAME of \decalper_eb_ot_sdeen_pot_pi_dehcac_xnilix_pselect_f__parameterized1\ : entity is "pselect_f";
end \decalper_eb_ot_sdeen_pot_pi_dehcac_xnilix_pselect_f__parameterized1\;

architecture STRUCTURE of \decalper_eb_ot_sdeen_pot_pi_dehcac_xnilix_pselect_f__parameterized1\ is
begin
CS: unisim.vcomponents.LUT2
    generic map(
      INIT => X"2"
    )
        port map (
      I0 => \GEN_BKEND_CE_REGISTERS[2].ce_out_i_reg[2]\(1),
      I1 => \GEN_BKEND_CE_REGISTERS[2].ce_out_i_reg[2]\(0),
      O => ce_expnd_i_1
    );
end STRUCTURE;
library IEEE;
use IEEE.STD_LOGIC_1164.ALL;
library UNISIM;
use UNISIM.VCOMPONENTS.ALL;
entity decalper_eb_ot_sdeen_pot_pi_dehcac_xnilix_address_decoder is
  port (
    \MEM_DECODE_GEN[0].cs_out_i_reg[0]_0\ : out STD_LOGIC;
    E : out STD_LOGIC_VECTOR ( 0 to 0 );
    bus2ip_rnw_i_reg : out STD_LOGIC_VECTOR ( 0 to 0 );
    ip2bus_rdack_i_D1_reg : out STD_LOGIC;
    ip2bus_wrack_i_D1_reg : out STD_LOGIC;
    bus2ip_rnw_i_reg_0 : out STD_LOGIC;
    D : out STD_LOGIC_VECTOR ( 31 downto 0 );
    Q : in STD_LOGIC;
    s_axi_aclk : in STD_LOGIC;
    \Dual.gpio_Data_Out_reg[0]\ : in STD_LOGIC_VECTOR ( 2 downto 0 );
    \Dual.ALLOUT1_ND_G2.READ_REG2_GEN[0].reg3_reg[0]\ : in STD_LOGIC;
    s_axi_aresetn : in STD_LOGIC;
    GPIO_xferAck_i : in STD_LOGIC;
    gpio_xferAck_Reg : in STD_LOGIC;
    ip2bus_rdack_i_D1 : in STD_LOGIC;
    s_axi_arready : in STD_LOGIC;
    s_axi_arready_0 : in STD_LOGIC_VECTOR ( 3 downto 0 );
    ip2bus_wrack_i_D1 : in STD_LOGIC;
    s_axi_wready : in STD_LOGIC;
    \Dual.ALLOUT0_ND_G1.READ_REG_GEN[31].reg1_reg\ : in STD_LOGIC;
    reg3 : in STD_LOGIC_VECTOR ( 0 to 31 );
    \Dual.ALLOUT0_ND_G1.READ_REG_GEN[30].reg1_reg\ : in STD_LOGIC;
    \Dual.ALLOUT0_ND_G1.READ_REG_GEN[29].reg1_reg\ : in STD_LOGIC;
    \Dual.ALLOUT0_ND_G1.READ_REG_GEN[28].reg1_reg\ : in STD_LOGIC;
    \Dual.ALLOUT0_ND_G1.READ_REG_GEN[27].reg1_reg\ : in STD_LOGIC;
    \Dual.ALLOUT0_ND_G1.READ_REG_GEN[26].reg1_reg\ : in STD_LOGIC;
    \Dual.ALLOUT0_ND_G1.READ_REG_GEN[25].reg1_reg\ : in STD_LOGIC;
    \Dual.ALLOUT0_ND_G1.READ_REG_GEN[24].reg1_reg\ : in STD_LOGIC;
    \Dual.ALLOUT0_ND_G1.READ_REG_GEN[23].reg1_reg\ : in STD_LOGIC;
    \Dual.ALLOUT0_ND_G1.READ_REG_GEN[22].reg1_reg\ : in STD_LOGIC;
    \Dual.ALLOUT0_ND_G1.READ_REG_GEN[21].reg1_reg\ : in STD_LOGIC;
    \Dual.ALLOUT0_ND_G1.READ_REG_GEN[20].reg1_reg\ : in STD_LOGIC;
    \Dual.ALLOUT0_ND_G1.READ_REG_GEN[19].reg1_reg\ : in STD_LOGIC;
    \Dual.ALLOUT0_ND_G1.READ_REG_GEN[18].reg1_reg\ : in STD_LOGIC;
    \Dual.ALLOUT0_ND_G1.READ_REG_GEN[17].reg1_reg\ : in STD_LOGIC;
    \Dual.ALLOUT0_ND_G1.READ_REG_GEN[16].reg1_reg\ : in STD_LOGIC;
    \Dual.ALLOUT0_ND_G1.READ_REG_GEN[15].reg1_reg\ : in STD_LOGIC;
    \Dual.ALLOUT0_ND_G1.READ_REG_GEN[14].reg1_reg\ : in STD_LOGIC;
    \Dual.ALLOUT0_ND_G1.READ_REG_GEN[13].reg1_reg\ : in STD_LOGIC;
    \Dual.ALLOUT0_ND_G1.READ_REG_GEN[12].reg1_reg\ : in STD_LOGIC;
    \Dual.ALLOUT0_ND_G1.READ_REG_GEN[11].reg1_reg\ : in STD_LOGIC;
    \Dual.ALLOUT0_ND_G1.READ_REG_GEN[10].reg1_reg\ : in STD_LOGIC;
    \Dual.ALLOUT0_ND_G1.READ_REG_GEN[9].reg1_reg\ : in STD_LOGIC;
    \Dual.ALLOUT0_ND_G1.READ_REG_GEN[8].reg1_reg\ : in STD_LOGIC;
    \Dual.ALLOUT0_ND_G1.READ_REG_GEN[7].reg1_reg\ : in STD_LOGIC;
    \Dual.ALLOUT0_ND_G1.READ_REG_GEN[6].reg1_reg\ : in STD_LOGIC;
    \Dual.ALLOUT0_ND_G1.READ_REG_GEN[5].reg1_reg\ : in STD_LOGIC;
    \Dual.ALLOUT0_ND_G1.READ_REG_GEN[4].reg1_reg\ : in STD_LOGIC;
    \Dual.ALLOUT0_ND_G1.READ_REG_GEN[3].reg1_reg\ : in STD_LOGIC;
    \Dual.ALLOUT0_ND_G1.READ_REG_GEN[2].reg1_reg\ : in STD_LOGIC;
    \Dual.ALLOUT0_ND_G1.READ_REG_GEN[1].reg1_reg\ : in STD_LOGIC;
    \Dual.ALLOUT0_ND_G1.READ_REG_GEN[0].reg1_reg\ : in STD_LOGIC
  );
end decalper_eb_ot_sdeen_pot_pi_dehcac_xnilix_address_decoder;

architecture STRUCTURE of decalper_eb_ot_sdeen_pot_pi_dehcac_xnilix_address_decoder is
  signal Bus_RNW_reg : STD_LOGIC;
  signal Bus_RNW_reg_i_1_n_0 : STD_LOGIC;
  signal \GEN_BKEND_CE_REGISTERS[0].ce_out_i_reg\ : STD_LOGIC;
  signal \GEN_BKEND_CE_REGISTERS[1].ce_out_i_reg\ : STD_LOGIC;
  signal \GEN_BKEND_CE_REGISTERS[2].ce_out_i_reg\ : STD_LOGIC;
  signal \GEN_BKEND_CE_REGISTERS[3].ce_out_i_reg\ : STD_LOGIC;
  signal \MEM_DECODE_GEN[0].cs_out_i[0]_i_1_n_0\ : STD_LOGIC;
  signal \^mem_decode_gen[0].cs_out_i_reg[0]_0\ : STD_LOGIC;
  signal ce_expnd_i_0 : STD_LOGIC;
  signal ce_expnd_i_1 : STD_LOGIC;
  signal ce_expnd_i_2 : STD_LOGIC;
  signal ce_expnd_i_3 : STD_LOGIC;
  signal cs_ce_clr : STD_LOGIC;
  signal \ip2bus_data_i_D1[0]_i_2_n_0\ : STD_LOGIC;
  signal \ip2bus_data_i_D1[0]_i_3_n_0\ : STD_LOGIC;
  signal \ip2bus_data_i_D1[0]_i_4_n_0\ : STD_LOGIC;
  signal \^ip2bus_rdack_i_d1_reg\ : STD_LOGIC;
  signal \^ip2bus_wrack_i_d1_reg\ : STD_LOGIC;
  attribute SOFT_HLUTNM : string;
  attribute SOFT_HLUTNM of \Dual.gpio2_Data_Out[0]_i_1\ : label is "soft_lutpair0";
  attribute SOFT_HLUTNM of \Dual.gpio_Data_Out[0]_i_1\ : label is "soft_lutpair0";
  attribute SOFT_HLUTNM of \GEN_BKEND_CE_REGISTERS[1].ce_out_i[1]_i_1\ : label is "soft_lutpair1";
  attribute SOFT_HLUTNM of \GEN_BKEND_CE_REGISTERS[3].ce_out_i[3]_i_2\ : label is "soft_lutpair1";
begin
  \MEM_DECODE_GEN[0].cs_out_i_reg[0]_0\ <= \^mem_decode_gen[0].cs_out_i_reg[0]_0\;
  ip2bus_rdack_i_D1_reg <= \^ip2bus_rdack_i_d1_reg\;
  ip2bus_wrack_i_D1_reg <= \^ip2bus_wrack_i_d1_reg\;
Bus_RNW_reg_i_1: unisim.vcomponents.LUT3
    generic map(
      INIT => X"B8"
    )
        port map (
      I0 => \Dual.ALLOUT1_ND_G2.READ_REG2_GEN[0].reg3_reg[0]\,
      I1 => Q,
      I2 => Bus_RNW_reg,
      O => Bus_RNW_reg_i_1_n_0
    );
Bus_RNW_reg_reg: unisim.vcomponents.FDRE
     port map (
      C => s_axi_aclk,
      CE => '1',
      D => Bus_RNW_reg_i_1_n_0,
      Q => Bus_RNW_reg,
      R => '0'
    );
\Dual.ALLOUT0_ND_G1.READ_REG_GEN[31].reg1[31]_i_1\: unisim.vcomponents.LUT4
    generic map(
      INIT => X"FDFF"
    )
        port map (
      I0 => \Dual.ALLOUT1_ND_G2.READ_REG2_GEN[0].reg3_reg[0]\,
      I1 => GPIO_xferAck_i,
      I2 => gpio_xferAck_Reg,
      I3 => \^mem_decode_gen[0].cs_out_i_reg[0]_0\,
      O => bus2ip_rnw_i_reg_0
    );
\Dual.gpio2_Data_Out[0]_i_1\: unisim.vcomponents.LUT5
    generic map(
      INIT => X"00100000"
    )
        port map (
      I0 => \Dual.ALLOUT1_ND_G2.READ_REG2_GEN[0].reg3_reg[0]\,
      I1 => \Dual.gpio_Data_Out_reg[0]\(2),
      I2 => \^mem_decode_gen[0].cs_out_i_reg[0]_0\,
      I3 => \Dual.gpio_Data_Out_reg[0]\(0),
      I4 => \Dual.gpio_Data_Out_reg[0]\(1),
      O => bus2ip_rnw_i_reg(0)
    );
\Dual.gpio_Data_Out[0]_i_1\: unisim.vcomponents.LUT5
    generic map(
      INIT => X"00000010"
    )
        port map (
      I0 => \Dual.ALLOUT1_ND_G2.READ_REG2_GEN[0].reg3_reg[0]\,
      I1 => \Dual.gpio_Data_Out_reg[0]\(2),
      I2 => \^mem_decode_gen[0].cs_out_i_reg[0]_0\,
      I3 => \Dual.gpio_Data_Out_reg[0]\(1),
      I4 => \Dual.gpio_Data_Out_reg[0]\(0),
      O => E(0)
    );
\GEN_BKEND_CE_REGISTERS[0].ce_out_i_reg[0]\: unisim.vcomponents.FDRE
     port map (
      C => s_axi_aclk,
      CE => Q,
      D => ce_expnd_i_3,
      Q => \GEN_BKEND_CE_REGISTERS[0].ce_out_i_reg\,
      R => cs_ce_clr
    );
\GEN_BKEND_CE_REGISTERS[1].ce_out_i[1]_i_1\: unisim.vcomponents.LUT2
    generic map(
      INIT => X"2"
    )
        port map (
      I0 => \Dual.gpio_Data_Out_reg[0]\(0),
      I1 => \Dual.gpio_Data_Out_reg[0]\(1),
      O => ce_expnd_i_2
    );
\GEN_BKEND_CE_REGISTERS[1].ce_out_i_reg[1]\: unisim.vcomponents.FDRE
     port map (
      C => s_axi_aclk,
      CE => Q,
      D => ce_expnd_i_2,
      Q => \GEN_BKEND_CE_REGISTERS[1].ce_out_i_reg\,
      R => cs_ce_clr
    );
\GEN_BKEND_CE_REGISTERS[2].ce_out_i_reg[2]\: unisim.vcomponents.FDRE
     port map (
      C => s_axi_aclk,
      CE => Q,
      D => ce_expnd_i_1,
      Q => \GEN_BKEND_CE_REGISTERS[2].ce_out_i_reg\,
      R => cs_ce_clr
    );
\GEN_BKEND_CE_REGISTERS[3].ce_out_i[3]_i_1\: unisim.vcomponents.LUT3
    generic map(
      INIT => X"EF"
    )
        port map (
      I0 => \^ip2bus_wrack_i_d1_reg\,
      I1 => \^ip2bus_rdack_i_d1_reg\,
      I2 => s_axi_aresetn,
      O => cs_ce_clr
    );
\GEN_BKEND_CE_REGISTERS[3].ce_out_i[3]_i_2\: unisim.vcomponents.LUT2
    generic map(
      INIT => X"8"
    )
        port map (
      I0 => \Dual.gpio_Data_Out_reg[0]\(1),
      I1 => \Dual.gpio_Data_Out_reg[0]\(0),
      O => ce_expnd_i_0
    );
\GEN_BKEND_CE_REGISTERS[3].ce_out_i_reg[3]\: unisim.vcomponents.FDRE
     port map (
      C => s_axi_aclk,
      CE => Q,
      D => ce_expnd_i_0,
      Q => \GEN_BKEND_CE_REGISTERS[3].ce_out_i_reg\,
      R => cs_ce_clr
    );
\MEM_DECODE_GEN[0].PER_CE_GEN[0].MULTIPLE_CES_THIS_CS_GEN.CE_I\: entity work.decalper_eb_ot_sdeen_pot_pi_dehcac_xnilix_pselect_f
     port map (
      \GEN_BKEND_CE_REGISTERS[0].ce_out_i_reg[0]\(1 downto 0) => \Dual.gpio_Data_Out_reg[0]\(1 downto 0),
      ce_expnd_i_3 => ce_expnd_i_3
    );
\MEM_DECODE_GEN[0].PER_CE_GEN[2].MULTIPLE_CES_THIS_CS_GEN.CE_I\: entity work.\decalper_eb_ot_sdeen_pot_pi_dehcac_xnilix_pselect_f__parameterized1\
     port map (
      \GEN_BKEND_CE_REGISTERS[2].ce_out_i_reg[2]\(1 downto 0) => \Dual.gpio_Data_Out_reg[0]\(1 downto 0),
      ce_expnd_i_1 => ce_expnd_i_1
    );
\MEM_DECODE_GEN[0].cs_out_i[0]_i_1\: unisim.vcomponents.LUT5
    generic map(
      INIT => X"000000E0"
    )
        port map (
      I0 => \^mem_decode_gen[0].cs_out_i_reg[0]_0\,
      I1 => Q,
      I2 => s_axi_aresetn,
      I3 => \^ip2bus_rdack_i_d1_reg\,
      I4 => \^ip2bus_wrack_i_d1_reg\,
      O => \MEM_DECODE_GEN[0].cs_out_i[0]_i_1_n_0\
    );
\MEM_DECODE_GEN[0].cs_out_i_reg[0]\: unisim.vcomponents.FDRE
     port map (
      C => s_axi_aclk,
      CE => '1',
      D => \MEM_DECODE_GEN[0].cs_out_i[0]_i_1_n_0\,
      Q => \^mem_decode_gen[0].cs_out_i_reg[0]_0\,
      R => '0'
    );
\ip2bus_data_i_D1[0]_i_1\: unisim.vcomponents.LUT5
    generic map(
      INIT => X"FFEAEAEA"
    )
        port map (
      I0 => \ip2bus_data_i_D1[0]_i_2_n_0\,
      I1 => \ip2bus_data_i_D1[0]_i_3_n_0\,
      I2 => \Dual.ALLOUT0_ND_G1.READ_REG_GEN[0].reg1_reg\,
      I3 => reg3(0),
      I4 => \ip2bus_data_i_D1[0]_i_4_n_0\,
      O => D(31)
    );
\ip2bus_data_i_D1[0]_i_2\: unisim.vcomponents.LUT5
    generic map(
      INIT => X"00040400"
    )
        port map (
      I0 => \GEN_BKEND_CE_REGISTERS[2].ce_out_i_reg\,
      I1 => Bus_RNW_reg,
      I2 => \GEN_BKEND_CE_REGISTERS[0].ce_out_i_reg\,
      I3 => \GEN_BKEND_CE_REGISTERS[3].ce_out_i_reg\,
      I4 => \GEN_BKEND_CE_REGISTERS[1].ce_out_i_reg\,
      O => \ip2bus_data_i_D1[0]_i_2_n_0\
    );
\ip2bus_data_i_D1[0]_i_3\: unisim.vcomponents.LUT5
    generic map(
      INIT => X"00020000"
    )
        port map (
      I0 => Bus_RNW_reg,
      I1 => \GEN_BKEND_CE_REGISTERS[1].ce_out_i_reg\,
      I2 => \GEN_BKEND_CE_REGISTERS[3].ce_out_i_reg\,
      I3 => \GEN_BKEND_CE_REGISTERS[2].ce_out_i_reg\,
      I4 => \GEN_BKEND_CE_REGISTERS[0].ce_out_i_reg\,
      O => \ip2bus_data_i_D1[0]_i_3_n_0\
    );
\ip2bus_data_i_D1[0]_i_4\: unisim.vcomponents.LUT5
    generic map(
      INIT => X"00100000"
    )
        port map (
      I0 => \GEN_BKEND_CE_REGISTERS[1].ce_out_i_reg\,
      I1 => \GEN_BKEND_CE_REGISTERS[3].ce_out_i_reg\,
      I2 => Bus_RNW_reg,
      I3 => \GEN_BKEND_CE_REGISTERS[0].ce_out_i_reg\,
      I4 => \GEN_BKEND_CE_REGISTERS[2].ce_out_i_reg\,
      O => \ip2bus_data_i_D1[0]_i_4_n_0\
    );
\ip2bus_data_i_D1[10]_i_1\: unisim.vcomponents.LUT5
    generic map(
      INIT => X"FFEAEAEA"
    )
        port map (
      I0 => \ip2bus_data_i_D1[0]_i_2_n_0\,
      I1 => \ip2bus_data_i_D1[0]_i_3_n_0\,
      I2 => \Dual.ALLOUT0_ND_G1.READ_REG_GEN[10].reg1_reg\,
      I3 => reg3(10),
      I4 => \ip2bus_data_i_D1[0]_i_4_n_0\,
      O => D(21)
    );
\ip2bus_data_i_D1[11]_i_1\: unisim.vcomponents.LUT5
    generic map(
      INIT => X"FFEAEAEA"
    )
        port map (
      I0 => \ip2bus_data_i_D1[0]_i_2_n_0\,
      I1 => \ip2bus_data_i_D1[0]_i_3_n_0\,
      I2 => \Dual.ALLOUT0_ND_G1.READ_REG_GEN[11].reg1_reg\,
      I3 => reg3(11),
      I4 => \ip2bus_data_i_D1[0]_i_4_n_0\,
      O => D(20)
    );
\ip2bus_data_i_D1[12]_i_1\: unisim.vcomponents.LUT5
    generic map(
      INIT => X"FFEAEAEA"
    )
        port map (
      I0 => \ip2bus_data_i_D1[0]_i_2_n_0\,
      I1 => \ip2bus_data_i_D1[0]_i_3_n_0\,
      I2 => \Dual.ALLOUT0_ND_G1.READ_REG_GEN[12].reg1_reg\,
      I3 => reg3(12),
      I4 => \ip2bus_data_i_D1[0]_i_4_n_0\,
      O => D(19)
    );
\ip2bus_data_i_D1[13]_i_1\: unisim.vcomponents.LUT5
    generic map(
      INIT => X"FFEAEAEA"
    )
        port map (
      I0 => \ip2bus_data_i_D1[0]_i_2_n_0\,
      I1 => \ip2bus_data_i_D1[0]_i_3_n_0\,
      I2 => \Dual.ALLOUT0_ND_G1.READ_REG_GEN[13].reg1_reg\,
      I3 => reg3(13),
      I4 => \ip2bus_data_i_D1[0]_i_4_n_0\,
      O => D(18)
    );
\ip2bus_data_i_D1[14]_i_1\: unisim.vcomponents.LUT5
    generic map(
      INIT => X"FFEAEAEA"
    )
        port map (
      I0 => \ip2bus_data_i_D1[0]_i_2_n_0\,
      I1 => \ip2bus_data_i_D1[0]_i_3_n_0\,
      I2 => \Dual.ALLOUT0_ND_G1.READ_REG_GEN[14].reg1_reg\,
      I3 => reg3(14),
      I4 => \ip2bus_data_i_D1[0]_i_4_n_0\,
      O => D(17)
    );
\ip2bus_data_i_D1[15]_i_1\: unisim.vcomponents.LUT5
    generic map(
      INIT => X"FFEAEAEA"
    )
        port map (
      I0 => \ip2bus_data_i_D1[0]_i_2_n_0\,
      I1 => \ip2bus_data_i_D1[0]_i_3_n_0\,
      I2 => \Dual.ALLOUT0_ND_G1.READ_REG_GEN[15].reg1_reg\,
      I3 => reg3(15),
      I4 => \ip2bus_data_i_D1[0]_i_4_n_0\,
      O => D(16)
    );
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
      INIT => X"FFEAEAEA"
    )
        port map (
      I0 => \ip2bus_data_i_D1[0]_i_2_n_0\,
      I1 => \ip2bus_data_i_D1[0]_i_3_n_0\,
      I2 => \Dual.ALLOUT0_ND_G1.READ_REG_GEN[5].reg1_reg\,
      I3 => reg3(5),
      I4 => \ip2bus_data_i_D1[0]_i_4_n_0\,
      O => D(26)
    );
\ip2bus_data_i_D1[6]_i_1\: unisim.vcomponents.LUT5
    generic map(
      INIT => X"FFEAEAEA"
    )
        port map (
      I0 => \ip2bus_data_i_D1[0]_i_2_n_0\,
      I1 => \ip2bus_data_i_D1[0]_i_3_n_0\,
      I2 => \Dual.ALLOUT0_ND_G1.READ_REG_GEN[6].reg1_reg\,
      I3 => reg3(6),
      I4 => \ip2bus_data_i_D1[0]_i_4_n_0\,
      O => D(25)
    );
\ip2bus_data_i_D1[7]_i_1\: unisim.vcomponents.LUT5
    generic map(
      INIT => X"FFEAEAEA"
    )
        port map (
      I0 => \ip2bus_data_i_D1[0]_i_2_n_0\,
      I1 => \ip2bus_data_i_D1[0]_i_3_n_0\,
      I2 => \Dual.ALLOUT0_ND_G1.READ_REG_GEN[7].reg1_reg\,
      I3 => reg3(7),
      I4 => \ip2bus_data_i_D1[0]_i_4_n_0\,
      O => D(24)
    );
\ip2bus_data_i_D1[8]_i_1\: unisim.vcomponents.LUT5
    generic map(
      INIT => X"FFEAEAEA"
    )
        port map (
      I0 => \ip2bus_data_i_D1[0]_i_2_n_0\,
      I1 => \ip2bus_data_i_D1[0]_i_3_n_0\,
      I2 => \Dual.ALLOUT0_ND_G1.READ_REG_GEN[8].reg1_reg\,
      I3 => reg3(8),
      I4 => \ip2bus_data_i_D1[0]_i_4_n_0\,
      O => D(23)
    );
\ip2bus_data_i_D1[9]_i_1\: unisim.vcomponents.LUT5
    generic map(
      INIT => X"FFEAEAEA"
    )
        port map (
      I0 => \ip2bus_data_i_D1[0]_i_2_n_0\,
      I1 => \ip2bus_data_i_D1[0]_i_3_n_0\,
      I2 => \Dual.ALLOUT0_ND_G1.READ_REG_GEN[9].reg1_reg\,
      I3 => reg3(9),
      I4 => \ip2bus_data_i_D1[0]_i_4_n_0\,
      O => D(22)
    );
s_axi_arready_INST_0: unisim.vcomponents.LUT6
    generic map(
      INIT => X"AAAAAAAAAAAEAAAA"
    )
        port map (
      I0 => ip2bus_rdack_i_D1,
      I1 => s_axi_arready,
      I2 => s_axi_arready_0(2),
      I3 => s_axi_arready_0(1),
      I4 => s_axi_arready_0(3),
      I5 => s_axi_arready_0(0),
      O => \^ip2bus_rdack_i_d1_reg\
    );
s_axi_wready_INST_0: unisim.vcomponents.LUT6
    generic map(
      INIT => X"AAAAAAAAAAAEAAAA"
    )
        port map (
      I0 => ip2bus_wrack_i_D1,
      I1 => s_axi_wready,
      I2 => s_axi_arready_0(2),
      I3 => s_axi_arready_0(1),
      I4 => s_axi_arready_0(3),
      I5 => s_axi_arready_0(0),
      O => \^ip2bus_wrack_i_d1_reg\
    );
end STRUCTURE;
library IEEE;
use IEEE.STD_LOGIC_1164.ALL;
library UNISIM;
use UNISIM.VCOMPONENTS.ALL;
entity decalper_eb_ot_sdeen_pot_pi_dehcac_xnilix_slave_attachment is
  port (
    SR : out STD_LOGIC_VECTOR ( 0 to 0 );
    bus2ip_rnw_i_reg_0 : out STD_LOGIC;
    s_axi_rvalid_i_reg_0 : out STD_LOGIC;
    s_axi_bvalid_i_reg_0 : out STD_LOGIC;
    \MEM_DECODE_GEN[0].cs_out_i_reg[0]\ : out STD_LOGIC;
    E : out STD_LOGIC_VECTOR ( 0 to 0 );
    bus2ip_rnw_i_reg_1 : out STD_LOGIC_VECTOR ( 0 to 0 );
    ip2bus_rdack_i_D1_reg : out STD_LOGIC;
    ip2bus_wrack_i_D1_reg : out STD_LOGIC;
    bus2ip_rnw_i_reg_2 : out STD_LOGIC;
    s_axi_rdata : out STD_LOGIC_VECTOR ( 31 downto 0 );
    D : out STD_LOGIC_VECTOR ( 31 downto 0 );
    s_axi_aclk : in STD_LOGIC;
    s_axi_arvalid : in STD_LOGIC;
    s_axi_rready : in STD_LOGIC;
    s_axi_bready : in STD_LOGIC;
    s_axi_aresetn : in STD_LOGIC;
    s_axi_awvalid : in STD_LOGIC;
    s_axi_wvalid : in STD_LOGIC;
    GPIO_xferAck_i : in STD_LOGIC;
    gpio_xferAck_Reg : in STD_LOGIC;
    Q : in STD_LOGIC_VECTOR ( 31 downto 0 );
    \Dual.ALLOUT0_ND_G1.READ_REG_GEN[31].reg1_reg\ : in STD_LOGIC;
    reg3 : in STD_LOGIC_VECTOR ( 0 to 31 );
    \Dual.ALLOUT0_ND_G1.READ_REG_GEN[30].reg1_reg\ : in STD_LOGIC;
    \Dual.ALLOUT0_ND_G1.READ_REG_GEN[29].reg1_reg\ : in STD_LOGIC;
    \Dual.ALLOUT0_ND_G1.READ_REG_GEN[28].reg1_reg\ : in STD_LOGIC;
    \Dual.ALLOUT0_ND_G1.READ_REG_GEN[27].reg1_reg\ : in STD_LOGIC;
    \Dual.ALLOUT0_ND_G1.READ_REG_GEN[26].reg1_reg\ : in STD_LOGIC;
    \Dual.ALLOUT0_ND_G1.READ_REG_GEN[25].reg1_reg\ : in STD_LOGIC;
    \Dual.ALLOUT0_ND_G1.READ_REG_GEN[24].reg1_reg\ : in STD_LOGIC;
    \Dual.ALLOUT0_ND_G1.READ_REG_GEN[23].reg1_reg\ : in STD_LOGIC;
    \Dual.ALLOUT0_ND_G1.READ_REG_GEN[22].reg1_reg\ : in STD_LOGIC;
    \Dual.ALLOUT0_ND_G1.READ_REG_GEN[21].reg1_reg\ : in STD_LOGIC;
    \Dual.ALLOUT0_ND_G1.READ_REG_GEN[20].reg1_reg\ : in STD_LOGIC;
    \Dual.ALLOUT0_ND_G1.READ_REG_GEN[19].reg1_reg\ : in STD_LOGIC;
    \Dual.ALLOUT0_ND_G1.READ_REG_GEN[18].reg1_reg\ : in STD_LOGIC;
    \Dual.ALLOUT0_ND_G1.READ_REG_GEN[17].reg1_reg\ : in STD_LOGIC;
    \Dual.ALLOUT0_ND_G1.READ_REG_GEN[16].reg1_reg\ : in STD_LOGIC;
    \Dual.ALLOUT0_ND_G1.READ_REG_GEN[15].reg1_reg\ : in STD_LOGIC;
    \Dual.ALLOUT0_ND_G1.READ_REG_GEN[14].reg1_reg\ : in STD_LOGIC;
    \Dual.ALLOUT0_ND_G1.READ_REG_GEN[13].reg1_reg\ : in STD_LOGIC;
    \Dual.ALLOUT0_ND_G1.READ_REG_GEN[12].reg1_reg\ : in STD_LOGIC;
    \Dual.ALLOUT0_ND_G1.READ_REG_GEN[11].reg1_reg\ : in STD_LOGIC;
    \Dual.ALLOUT0_ND_G1.READ_REG_GEN[10].reg1_reg\ : in STD_LOGIC;
    \Dual.ALLOUT0_ND_G1.READ_REG_GEN[9].reg1_reg\ : in STD_LOGIC;
    \Dual.ALLOUT0_ND_G1.READ_REG_GEN[8].reg1_reg\ : in STD_LOGIC;
    \Dual.ALLOUT0_ND_G1.READ_REG_GEN[7].reg1_reg\ : in STD_LOGIC;
    \Dual.ALLOUT0_ND_G1.READ_REG_GEN[6].reg1_reg\ : in STD_LOGIC;
    \Dual.ALLOUT0_ND_G1.READ_REG_GEN[5].reg1_reg\ : in STD_LOGIC;
    \Dual.ALLOUT0_ND_G1.READ_REG_GEN[4].reg1_reg\ : in STD_LOGIC;
    \Dual.ALLOUT0_ND_G1.READ_REG_GEN[3].reg1_reg\ : in STD_LOGIC;
    \Dual.ALLOUT0_ND_G1.READ_REG_GEN[2].reg1_reg\ : in STD_LOGIC;
    \Dual.ALLOUT0_ND_G1.READ_REG_GEN[1].reg1_reg\ : in STD_LOGIC;
    \Dual.ALLOUT0_ND_G1.READ_REG_GEN[0].reg1_reg\ : in STD_LOGIC;
    ip2bus_rdack_i_D1 : in STD_LOGIC;
    ip2bus_wrack_i_D1 : in STD_LOGIC;
    s_axi_araddr : in STD_LOGIC_VECTOR ( 2 downto 0 );
    s_axi_awaddr : in STD_LOGIC_VECTOR ( 2 downto 0 )
  );
end decalper_eb_ot_sdeen_pot_pi_dehcac_xnilix_slave_attachment;

architecture STRUCTURE of decalper_eb_ot_sdeen_pot_pi_dehcac_xnilix_slave_attachment is
  signal \FSM_onehot_state[0]_i_1_n_0\ : STD_LOGIC;
  signal \FSM_onehot_state[1]_i_1_n_0\ : STD_LOGIC;
  signal \FSM_onehot_state[2]_i_1_n_0\ : STD_LOGIC;
  signal \FSM_onehot_state[3]_i_1_n_0\ : STD_LOGIC;
  signal \FSM_onehot_state_reg_n_0_[0]\ : STD_LOGIC;
  signal \FSM_onehot_state_reg_n_0_[3]\ : STD_LOGIC;
  signal \INCLUDE_DPHASE_TIMER.dpto_cnt_reg\ : STD_LOGIC_VECTOR ( 3 downto 0 );
  signal \^sr\ : STD_LOGIC_VECTOR ( 0 to 0 );
  signal bus2ip_addr : STD_LOGIC_VECTOR ( 0 to 6 );
  signal \bus2ip_addr_i[8]_i_1_n_0\ : STD_LOGIC;
  signal \^bus2ip_rnw_i_reg_0\ : STD_LOGIC;
  signal clear : STD_LOGIC;
  signal \^ip2bus_rdack_i_d1_reg\ : STD_LOGIC;
  signal \^ip2bus_wrack_i_d1_reg\ : STD_LOGIC;
  signal is_read_i_1_n_0 : STD_LOGIC;
  signal is_read_reg_n_0 : STD_LOGIC;
  signal is_write_i_1_n_0 : STD_LOGIC;
  signal is_write_i_2_n_0 : STD_LOGIC;
  signal is_write_reg_n_0 : STD_LOGIC;
  signal p_0_in : STD_LOGIC;
  signal p_0_out : STD_LOGIC_VECTOR ( 1 downto 0 );
  signal p_1_in : STD_LOGIC_VECTOR ( 8 downto 2 );
  signal p_5_in : STD_LOGIC;
  signal plusOp : STD_LOGIC_VECTOR ( 3 downto 0 );
  signal s_axi_bresp_i : STD_LOGIC;
  signal s_axi_bvalid_i_i_1_n_0 : STD_LOGIC;
  signal \^s_axi_bvalid_i_reg_0\ : STD_LOGIC;
  signal s_axi_rresp_i : STD_LOGIC;
  signal s_axi_rvalid_i_i_1_n_0 : STD_LOGIC;
  signal \^s_axi_rvalid_i_reg_0\ : STD_LOGIC;
  signal start2 : STD_LOGIC;
  signal start2_i_1_n_0 : STD_LOGIC;
  signal state : STD_LOGIC_VECTOR ( 1 downto 0 );
  signal \state1__2\ : STD_LOGIC;
  attribute FSM_ENCODED_STATES : string;
  attribute FSM_ENCODED_STATES of \FSM_onehot_state_reg[0]\ : label is "iSTATE:0010,iSTATE0:0100,iSTATE1:1000,iSTATE2:0001";
  attribute FSM_ENCODED_STATES of \FSM_onehot_state_reg[1]\ : label is "iSTATE:0010,iSTATE0:0100,iSTATE1:1000,iSTATE2:0001";
  attribute FSM_ENCODED_STATES of \FSM_onehot_state_reg[2]\ : label is "iSTATE:0010,iSTATE0:0100,iSTATE1:1000,iSTATE2:0001";
  attribute FSM_ENCODED_STATES of \FSM_onehot_state_reg[3]\ : label is "iSTATE:0010,iSTATE0:0100,iSTATE1:1000,iSTATE2:0001";
  attribute SOFT_HLUTNM : string;
  attribute SOFT_HLUTNM of \INCLUDE_DPHASE_TIMER.dpto_cnt[0]_i_1\ : label is "soft_lutpair5";
  attribute SOFT_HLUTNM of \INCLUDE_DPHASE_TIMER.dpto_cnt[1]_i_1\ : label is "soft_lutpair5";
  attribute SOFT_HLUTNM of \INCLUDE_DPHASE_TIMER.dpto_cnt[2]_i_1\ : label is "soft_lutpair3";
  attribute SOFT_HLUTNM of \INCLUDE_DPHASE_TIMER.dpto_cnt[3]_i_2\ : label is "soft_lutpair3";
  attribute SOFT_HLUTNM of \bus2ip_addr_i[3]_i_1\ : label is "soft_lutpair4";
  attribute SOFT_HLUTNM of \bus2ip_addr_i[8]_i_2\ : label is "soft_lutpair4";
  attribute SOFT_HLUTNM of start2_i_1 : label is "soft_lutpair2";
  attribute SOFT_HLUTNM of \state[1]_i_2\ : label is "soft_lutpair2";
begin
  SR(0) <= \^sr\(0);
  bus2ip_rnw_i_reg_0 <= \^bus2ip_rnw_i_reg_0\;
  ip2bus_rdack_i_D1_reg <= \^ip2bus_rdack_i_d1_reg\;
  ip2bus_wrack_i_D1_reg <= \^ip2bus_wrack_i_d1_reg\;
  s_axi_bvalid_i_reg_0 <= \^s_axi_bvalid_i_reg_0\;
  s_axi_rvalid_i_reg_0 <= \^s_axi_rvalid_i_reg_0\;
\FSM_onehot_state[0]_i_1\: unisim.vcomponents.LUT6
    generic map(
      INIT => X"FFFF150015001500"
    )
        port map (
      I0 => s_axi_arvalid,
      I1 => s_axi_wvalid,
      I2 => s_axi_awvalid,
      I3 => \FSM_onehot_state_reg_n_0_[0]\,
      I4 => \state1__2\,
      I5 => \FSM_onehot_state_reg_n_0_[3]\,
      O => \FSM_onehot_state[0]_i_1_n_0\
    );
\FSM_onehot_state[1]_i_1\: unisim.vcomponents.LUT4
    generic map(
      INIT => X"8F88"
    )
        port map (
      I0 => s_axi_arvalid,
      I1 => \FSM_onehot_state_reg_n_0_[0]\,
      I2 => \^ip2bus_rdack_i_d1_reg\,
      I3 => s_axi_rresp_i,
      O => \FSM_onehot_state[1]_i_1_n_0\
    );
\FSM_onehot_state[2]_i_1\: unisim.vcomponents.LUT6
    generic map(
      INIT => X"0800FFFF08000800"
    )
        port map (
      I0 => s_axi_wvalid,
      I1 => s_axi_awvalid,
      I2 => s_axi_arvalid,
      I3 => \FSM_onehot_state_reg_n_0_[0]\,
      I4 => \^ip2bus_wrack_i_d1_reg\,
      I5 => s_axi_bresp_i,
      O => \FSM_onehot_state[2]_i_1_n_0\
    );
\FSM_onehot_state[3]_i_1\: unisim.vcomponents.LUT6
    generic map(
      INIT => X"F888F888FFFFF888"
    )
        port map (
      I0 => \^ip2bus_wrack_i_d1_reg\,
      I1 => s_axi_bresp_i,
      I2 => s_axi_rresp_i,
      I3 => \^ip2bus_rdack_i_d1_reg\,
      I4 => \FSM_onehot_state_reg_n_0_[3]\,
      I5 => \state1__2\,
      O => \FSM_onehot_state[3]_i_1_n_0\
    );
\FSM_onehot_state[3]_i_2\: unisim.vcomponents.LUT4
    generic map(
      INIT => X"F888"
    )
        port map (
      I0 => s_axi_bready,
      I1 => \^s_axi_bvalid_i_reg_0\,
      I2 => s_axi_rready,
      I3 => \^s_axi_rvalid_i_reg_0\,
      O => \state1__2\
    );
\FSM_onehot_state_reg[0]\: unisim.vcomponents.FDSE
    generic map(
      INIT => '1'
    )
        port map (
      C => s_axi_aclk,
      CE => '1',
      D => \FSM_onehot_state[0]_i_1_n_0\,
      Q => \FSM_onehot_state_reg_n_0_[0]\,
      S => \^sr\(0)
    );
\FSM_onehot_state_reg[1]\: unisim.vcomponents.FDRE
    generic map(
      INIT => '0'
    )
        port map (
      C => s_axi_aclk,
      CE => '1',
      D => \FSM_onehot_state[1]_i_1_n_0\,
      Q => s_axi_rresp_i,
      R => \^sr\(0)
    );
\FSM_onehot_state_reg[2]\: unisim.vcomponents.FDRE
    generic map(
      INIT => '0'
    )
        port map (
      C => s_axi_aclk,
      CE => '1',
      D => \FSM_onehot_state[2]_i_1_n_0\,
      Q => s_axi_bresp_i,
      R => \^sr\(0)
    );
\FSM_onehot_state_reg[3]\: unisim.vcomponents.FDRE
    generic map(
      INIT => '0'
    )
        port map (
      C => s_axi_aclk,
      CE => '1',
      D => \FSM_onehot_state[3]_i_1_n_0\,
      Q => \FSM_onehot_state_reg_n_0_[3]\,
      R => \^sr\(0)
    );
\INCLUDE_DPHASE_TIMER.dpto_cnt[0]_i_1\: unisim.vcomponents.LUT1
    generic map(
      INIT => X"1"
    )
        port map (
      I0 => \INCLUDE_DPHASE_TIMER.dpto_cnt_reg\(0),
      O => plusOp(0)
    );
\INCLUDE_DPHASE_TIMER.dpto_cnt[1]_i_1\: unisim.vcomponents.LUT2
    generic map(
      INIT => X"6"
    )
        port map (
      I0 => \INCLUDE_DPHASE_TIMER.dpto_cnt_reg\(0),
      I1 => \INCLUDE_DPHASE_TIMER.dpto_cnt_reg\(1),
      O => plusOp(1)
    );
\INCLUDE_DPHASE_TIMER.dpto_cnt[2]_i_1\: unisim.vcomponents.LUT3
    generic map(
      INIT => X"78"
    )
        port map (
      I0 => \INCLUDE_DPHASE_TIMER.dpto_cnt_reg\(0),
      I1 => \INCLUDE_DPHASE_TIMER.dpto_cnt_reg\(1),
      I2 => \INCLUDE_DPHASE_TIMER.dpto_cnt_reg\(2),
      O => plusOp(2)
    );
\INCLUDE_DPHASE_TIMER.dpto_cnt[3]_i_1\: unisim.vcomponents.LUT2
    generic map(
      INIT => X"9"
    )
        port map (
      I0 => state(0),
      I1 => state(1),
      O => clear
    );
\INCLUDE_DPHASE_TIMER.dpto_cnt[3]_i_2\: unisim.vcomponents.LUT4
    generic map(
      INIT => X"7F80"
    )
        port map (
      I0 => \INCLUDE_DPHASE_TIMER.dpto_cnt_reg\(1),
      I1 => \INCLUDE_DPHASE_TIMER.dpto_cnt_reg\(0),
      I2 => \INCLUDE_DPHASE_TIMER.dpto_cnt_reg\(2),
      I3 => \INCLUDE_DPHASE_TIMER.dpto_cnt_reg\(3),
      O => plusOp(3)
    );
\INCLUDE_DPHASE_TIMER.dpto_cnt_reg[0]\: unisim.vcomponents.FDRE
     port map (
      C => s_axi_aclk,
      CE => '1',
      D => plusOp(0),
      Q => \INCLUDE_DPHASE_TIMER.dpto_cnt_reg\(0),
      R => clear
    );
\INCLUDE_DPHASE_TIMER.dpto_cnt_reg[1]\: unisim.vcomponents.FDRE
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
      \Dual.gpio_Data_Out_reg[0]\(1) => bus2ip_addr(5),
      \Dual.gpio_Data_Out_reg[0]\(0) => bus2ip_addr(6),
      E(0) => E(0),
      GPIO_xferAck_i => GPIO_xferAck_i,
      \MEM_DECODE_GEN[0].cs_out_i_reg[0]_0\ => \MEM_DECODE_GEN[0].cs_out_i_reg[0]\,
      Q => start2,
      bus2ip_rnw_i_reg(0) => bus2ip_rnw_i_reg_1(0),
      bus2ip_rnw_i_reg_0 => bus2ip_rnw_i_reg_2,
      gpio_xferAck_Reg => gpio_xferAck_Reg,
      ip2bus_rdack_i_D1 => ip2bus_rdack_i_D1,
      ip2bus_rdack_i_D1_reg => \^ip2bus_rdack_i_d1_reg\,
      ip2bus_wrack_i_D1 => ip2bus_wrack_i_D1,
      ip2bus_wrack_i_D1_reg => \^ip2bus_wrack_i_d1_reg\,
      reg3(0 to 31) => reg3(0 to 31),
      s_axi_aclk => s_axi_aclk,
      s_axi_aresetn => s_axi_aresetn,
      s_axi_arready => is_read_reg_n_0,
      s_axi_arready_0(3 downto 0) => \INCLUDE_DPHASE_TIMER.dpto_cnt_reg\(3 downto 0),
      s_axi_wready => is_write_reg_n_0
    );
\bus2ip_addr_i[2]_i_1\: unisim.vcomponents.LUT3
    generic map(
      INIT => X"AC"
    )
        port map (
      I0 => s_axi_araddr(0),
      I1 => s_axi_awaddr(0),
      I2 => s_axi_arvalid,
      O => p_1_in(2)
    );
\bus2ip_addr_i[3]_i_1\: unisim.vcomponents.LUT3
    generic map(
      INIT => X"AC"
    )
        port map (
      I0 => s_axi_araddr(1),
      I1 => s_axi_awaddr(1),
      I2 => s_axi_arvalid,
      O => p_1_in(3)
    );
\bus2ip_addr_i[8]_i_1\: unisim.vcomponents.LUT5
    generic map(
      INIT => X"000000EA"
    )
        port map (
      I0 => s_axi_arvalid,
      I1 => s_axi_awvalid,
      I2 => s_axi_wvalid,
      I3 => state(1),
      I4 => state(0),
      O => \bus2ip_addr_i[8]_i_1_n_0\
    );
\bus2ip_addr_i[8]_i_2\: unisim.vcomponents.LUT3
    generic map(
      INIT => X"AC"
    )
        port map (
      I0 => s_axi_araddr(2),
      I1 => s_axi_awaddr(2),
      I2 => s_axi_arvalid,
      O => p_1_in(8)
    );
\bus2ip_addr_i_reg[2]\: unisim.vcomponents.FDRE
     port map (
      C => s_axi_aclk,
      CE => \bus2ip_addr_i[8]_i_1_n_0\,
      D => p_1_in(2),
      Q => bus2ip_addr(6),
      R => \^sr\(0)
    );
\bus2ip_addr_i_reg[3]\: unisim.vcomponents.FDRE
     port map (
      C => s_axi_aclk,
      CE => \bus2ip_addr_i[8]_i_1_n_0\,
      D => p_1_in(3),
      Q => bus2ip_addr(5),
      R => \^sr\(0)
    );
\bus2ip_addr_i_reg[8]\: unisim.vcomponents.FDRE
     port map (
      C => s_axi_aclk,
      CE => \bus2ip_addr_i[8]_i_1_n_0\,
      D => p_1_in(8),
      Q => bus2ip_addr(0),
      R => \^sr\(0)
    );
bus2ip_rnw_i_reg: unisim.vcomponents.FDRE
     port map (
      C => s_axi_aclk,
      CE => \bus2ip_addr_i[8]_i_1_n_0\,
      D => s_axi_arvalid,
      Q => \^bus2ip_rnw_i_reg_0\,
      R => \^sr\(0)
    );
is_read_i_1: unisim.vcomponents.LUT5
    generic map(
      INIT => X"8BBB8888"
    )
        port map (
      I0 => s_axi_arvalid,
      I1 => \FSM_onehot_state_reg_n_0_[0]\,
      I2 => \state1__2\,
      I3 => \FSM_onehot_state_reg_n_0_[3]\,
      I4 => is_read_reg_n_0,
      O => is_read_i_1_n_0
    );
is_read_reg: unisim.vcomponents.FDRE
     port map (
      C => s_axi_aclk,
      CE => '1',
      D => is_read_i_1_n_0,
      Q => is_read_reg_n_0,
      R => \^sr\(0)
    );
is_write_i_1: unisim.vcomponents.LUT6
    generic map(
      INIT => X"2000FFFF20000000"
    )
        port map (
      I0 => \FSM_onehot_state_reg_n_0_[0]\,
      I1 => s_axi_arvalid,
      I2 => s_axi_awvalid,
      I3 => s_axi_wvalid,
      I4 => is_write_i_2_n_0,
      I5 => is_write_reg_n_0,
      O => is_write_i_1_n_0
    );
is_write_i_2: unisim.vcomponents.LUT6
    generic map(
      INIT => X"FFEAEAEAAAAAAAAA"
    )
        port map (
      I0 => \FSM_onehot_state_reg_n_0_[0]\,
      I1 => s_axi_bready,
      I2 => \^s_axi_bvalid_i_reg_0\,
      I3 => s_axi_rready,
      I4 => \^s_axi_rvalid_i_reg_0\,
      I5 => \FSM_onehot_state_reg_n_0_[3]\,
      O => is_write_i_2_n_0
    );
is_write_reg: unisim.vcomponents.FDRE
     port map (
      C => s_axi_aclk,
      CE => '1',
      D => is_write_i_1_n_0,
      Q => is_write_reg_n_0,
      R => \^sr\(0)
    );
rst_i_1: unisim.vcomponents.LUT1
    generic map(
      INIT => X"1"
    )
        port map (
      I0 => s_axi_aresetn,
      O => p_0_in
    );
rst_reg: unisim.vcomponents.FDRE
     port map (
      C => s_axi_aclk,
      CE => '1',
      D => p_0_in,
      Q => \^sr\(0),
      R => '0'
    );
s_axi_bvalid_i_i_1: unisim.vcomponents.LUT5
    generic map(
      INIT => X"08FF0808"
    )
        port map (
      I0 => \^ip2bus_wrack_i_d1_reg\,
      I1 => state(1),
      I2 => state(0),
      I3 => s_axi_bready,
      I4 => \^s_axi_bvalid_i_reg_0\,
      O => s_axi_bvalid_i_i_1_n_0
    );
s_axi_bvalid_i_reg: unisim.vcomponents.FDRE
    generic map(
      INIT => '0'
    )
        port map (
      C => s_axi_aclk,
      CE => '1',
      D => s_axi_bvalid_i_i_1_n_0,
      Q => \^s_axi_bvalid_i_reg_0\,
      R => \^sr\(0)
    );
\s_axi_rdata_i_reg[0]\: unisim.vcomponents.FDRE
    generic map(
      INIT => '0'
    )
        port map (
      C => s_axi_aclk,
      CE => s_axi_rresp_i,
      D => Q(0),
      Q => s_axi_rdata(0),
      R => \^sr\(0)
    );
\s_axi_rdata_i_reg[10]\: unisim.vcomponents.FDRE
    generic map(
      INIT => '0'
    )
        port map (
      C => s_axi_aclk,
      CE => s_axi_rresp_i,
      D => Q(10),
      Q => s_axi_rdata(10),
      R => \^sr\(0)
    );
\s_axi_rdata_i_reg[11]\: unisim.vcomponents.FDRE
    generic map(
      INIT => '0'
    )
        port map (
      C => s_axi_aclk,
      CE => s_axi_rresp_i,
      D => Q(11),
      Q => s_axi_rdata(11),
      R => \^sr\(0)
    );
\s_axi_rdata_i_reg[12]\: unisim.vcomponents.FDRE
    generic map(
      INIT => '0'
    )
        port map (
      C => s_axi_aclk,
      CE => s_axi_rresp_i,
      D => Q(12),
      Q => s_axi_rdata(12),
      R => \^sr\(0)
    );
\s_axi_rdata_i_reg[13]\: unisim.vcomponents.FDRE
    generic map(
      INIT => '0'
    )
        port map (
      C => s_axi_aclk,
      CE => s_axi_rresp_i,
      D => Q(13),
      Q => s_axi_rdata(13),
      R => \^sr\(0)
    );
\s_axi_rdata_i_reg[14]\: unisim.vcomponents.FDRE
    generic map(
      INIT => '0'
    )
        port map (
      C => s_axi_aclk,
      CE => s_axi_rresp_i,
      D => Q(14),
      Q => s_axi_rdata(14),
      R => \^sr\(0)
    );
\s_axi_rdata_i_reg[15]\: unisim.vcomponents.FDRE
    generic map(
      INIT => '0'
    )
        port map (
      C => s_axi_aclk,
      CE => s_axi_rresp_i,
      D => Q(15),
      Q => s_axi_rdata(15),
      R => \^sr\(0)
    );
\s_axi_rdata_i_reg[16]\: unisim.vcomponents.FDRE
    generic map(
      INIT => '0'
    )
        port map (
      C => s_axi_aclk,
      CE => s_axi_rresp_i,
      D => Q(16),
      Q => s_axi_rdata(16),
      R => \^sr\(0)
    );
\s_axi_rdata_i_reg[17]\: unisim.vcomponents.FDRE
    generic map(
      INIT => '0'
    )
        port map (
      C => s_axi_aclk,
      CE => s_axi_rresp_i,
      D => Q(17),
      Q => s_axi_rdata(17),
      R => \^sr\(0)
    );
\s_axi_rdata_i_reg[18]\: unisim.vcomponents.FDRE
    generic map(
      INIT => '0'
    )
        port map (
      C => s_axi_aclk,
      CE => s_axi_rresp_i,
      D => Q(18),
      Q => s_axi_rdata(18),
      R => \^sr\(0)
    );
\s_axi_rdata_i_reg[19]\: unisim.vcomponents.FDRE
    generic map(
      INIT => '0'
    )
        port map (
      C => s_axi_aclk,
      CE => s_axi_rresp_i,
      D => Q(19),
      Q => s_axi_rdata(19),
      R => \^sr\(0)
    );
\s_axi_rdata_i_reg[1]\: unisim.vcomponents.FDRE
    generic map(
      INIT => '0'
    )
        port map (
      C => s_axi_aclk,
      CE => s_axi_rresp_i,
      D => Q(1),
      Q => s_axi_rdata(1),
      R => \^sr\(0)
    );
\s_axi_rdata_i_reg[20]\: unisim.vcomponents.FDRE
    generic map(
      INIT => '0'
    )
        port map (
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
      D => Q(8),
      Q => s_axi_rdata(8),
      R => \^sr\(0)
    );
\s_axi_rdata_i_reg[9]\: unisim.vcomponents.FDRE
    generic map(
      INIT => '0'
    )
        port map (
      C => s_axi_aclk,
      CE => s_axi_rresp_i,
      D => Q(9),
      Q => s_axi_rdata(9),
      R => \^sr\(0)
    );
s_axi_rvalid_i_i_1: unisim.vcomponents.LUT5
    generic map(
      INIT => X"08FF0808"
    )
        port map (
      I0 => \^ip2bus_rdack_i_d1_reg\,
      I1 => state(0),
      I2 => state(1),
      I3 => s_axi_rready,
      I4 => \^s_axi_rvalid_i_reg_0\,
      O => s_axi_rvalid_i_i_1_n_0
    );
s_axi_rvalid_i_reg: unisim.vcomponents.FDRE
    generic map(
      INIT => '0'
    )
        port map (
      C => s_axi_aclk,
      CE => '1',
      D => s_axi_rvalid_i_i_1_n_0,
      Q => \^s_axi_rvalid_i_reg_0\,
      R => \^sr\(0)
    );
start2_i_1: unisim.vcomponents.LUT5
    generic map(
      INIT => X"000000F8"
    )
        port map (
      I0 => s_axi_awvalid,
      I1 => s_axi_wvalid,
      I2 => s_axi_arvalid,
      I3 => state(1),
      I4 => state(0),
      O => start2_i_1_n_0
    );
start2_reg: unisim.vcomponents.FDRE
     port map (
      C => s_axi_aclk,
      CE => '1',
      D => start2_i_1_n_0,
      Q => start2,
      R => \^sr\(0)
    );
\state[0]_i_1\: unisim.vcomponents.LUT5
    generic map(
      INIT => X"77FC44FC"
    )
        port map (
      I0 => \state1__2\,
      I1 => state(0),
      I2 => s_axi_arvalid,
      I3 => state(1),
      I4 => \^ip2bus_wrack_i_d1_reg\,
      O => p_0_out(0)
    );
\state[1]_i_1\: unisim.vcomponents.LUT6
    generic map(
      INIT => X"55FFFF0C5500FF0C"
    )
        port map (
      I0 => \state1__2\,
      I1 => p_5_in,
      I2 => s_axi_arvalid,
      I3 => state(1),
      I4 => state(0),
      I5 => \^ip2bus_rdack_i_d1_reg\,
      O => p_0_out(1)
    );
\state[1]_i_2\: unisim.vcomponents.LUT2
    generic map(
      INIT => X"8"
    )
        port map (
      I0 => s_axi_awvalid,
      I1 => s_axi_wvalid,
      O => p_5_in
    );
\state_reg[0]\: unisim.vcomponents.FDRE
     port map (
      C => s_axi_aclk,
      CE => '1',
      D => p_0_out(0),
      Q => state(0),
      R => \^sr\(0)
    );
\state_reg[1]\: unisim.vcomponents.FDRE
     port map (
      C => s_axi_aclk,
      CE => '1',
      D => p_0_out(1),
      Q => state(1),
      R => \^sr\(0)
    );
end STRUCTURE;
library IEEE;
use IEEE.STD_LOGIC_1164.ALL;
library UNISIM;
use UNISIM.VCOMPONENTS.ALL;
entity decalper_eb_ot_sdeen_pot_pi_dehcac_xnilix_axi_lite_ipif is
  port (
    bus2ip_reset : out STD_LOGIC;
    bus2ip_rnw : out STD_LOGIC;
    s_axi_rvalid_i_reg : out STD_LOGIC;
    s_axi_bvalid_i_reg : out STD_LOGIC;
    bus2ip_cs : out STD_LOGIC;
    E : out STD_LOGIC_VECTOR ( 0 to 0 );
    bus2ip_rnw_i_reg : out STD_LOGIC_VECTOR ( 0 to 0 );
    ip2bus_rdack_i_D1_reg : out STD_LOGIC;
    ip2bus_wrack_i_D1_reg : out STD_LOGIC;
    bus2ip_rnw_i_reg_0 : out STD_LOGIC;
    s_axi_rdata : out STD_LOGIC_VECTOR ( 31 downto 0 );
    D : out STD_LOGIC_VECTOR ( 31 downto 0 );
    s_axi_aclk : in STD_LOGIC;
    s_axi_arvalid : in STD_LOGIC;
    s_axi_rready : in STD_LOGIC;
    s_axi_bready : in STD_LOGIC;
    s_axi_aresetn : in STD_LOGIC;
    s_axi_awvalid : in STD_LOGIC;
    s_axi_wvalid : in STD_LOGIC;
    GPIO_xferAck_i : in STD_LOGIC;
    gpio_xferAck_Reg : in STD_LOGIC;
    Q : in STD_LOGIC_VECTOR ( 31 downto 0 );
    \Dual.ALLOUT0_ND_G1.READ_REG_GEN[31].reg1_reg\ : in STD_LOGIC;
    reg3 : in STD_LOGIC_VECTOR ( 0 to 31 );
    \Dual.ALLOUT0_ND_G1.READ_REG_GEN[30].reg1_reg\ : in STD_LOGIC;
    \Dual.ALLOUT0_ND_G1.READ_REG_GEN[29].reg1_reg\ : in STD_LOGIC;
    \Dual.ALLOUT0_ND_G1.READ_REG_GEN[28].reg1_reg\ : in STD_LOGIC;
    \Dual.ALLOUT0_ND_G1.READ_REG_GEN[27].reg1_reg\ : in STD_LOGIC;
    \Dual.ALLOUT0_ND_G1.READ_REG_GEN[26].reg1_reg\ : in STD_LOGIC;
    \Dual.ALLOUT0_ND_G1.READ_REG_GEN[25].reg1_reg\ : in STD_LOGIC;
    \Dual.ALLOUT0_ND_G1.READ_REG_GEN[24].reg1_reg\ : in STD_LOGIC;
    \Dual.ALLOUT0_ND_G1.READ_REG_GEN[23].reg1_reg\ : in STD_LOGIC;
    \Dual.ALLOUT0_ND_G1.READ_REG_GEN[22].reg1_reg\ : in STD_LOGIC;
    \Dual.ALLOUT0_ND_G1.READ_REG_GEN[21].reg1_reg\ : in STD_LOGIC;
    \Dual.ALLOUT0_ND_G1.READ_REG_GEN[20].reg1_reg\ : in STD_LOGIC;
    \Dual.ALLOUT0_ND_G1.READ_REG_GEN[19].reg1_reg\ : in STD_LOGIC;
    \Dual.ALLOUT0_ND_G1.READ_REG_GEN[18].reg1_reg\ : in STD_LOGIC;
    \Dual.ALLOUT0_ND_G1.READ_REG_GEN[17].reg1_reg\ : in STD_LOGIC;
    \Dual.ALLOUT0_ND_G1.READ_REG_GEN[16].reg1_reg\ : in STD_LOGIC;
    \Dual.ALLOUT0_ND_G1.READ_REG_GEN[15].reg1_reg\ : in STD_LOGIC;
    \Dual.ALLOUT0_ND_G1.READ_REG_GEN[14].reg1_reg\ : in STD_LOGIC;
    \Dual.ALLOUT0_ND_G1.READ_REG_GEN[13].reg1_reg\ : in STD_LOGIC;
    \Dual.ALLOUT0_ND_G1.READ_REG_GEN[12].reg1_reg\ : in STD_LOGIC;
    \Dual.ALLOUT0_ND_G1.READ_REG_GEN[11].reg1_reg\ : in STD_LOGIC;
    \Dual.ALLOUT0_ND_G1.READ_REG_GEN[10].reg1_reg\ : in STD_LOGIC;
    \Dual.ALLOUT0_ND_G1.READ_REG_GEN[9].reg1_reg\ : in STD_LOGIC;
    \Dual.ALLOUT0_ND_G1.READ_REG_GEN[8].reg1_reg\ : in STD_LOGIC;
    \Dual.ALLOUT0_ND_G1.READ_REG_GEN[7].reg1_reg\ : in STD_LOGIC;
    \Dual.ALLOUT0_ND_G1.READ_REG_GEN[6].reg1_reg\ : in STD_LOGIC;
    \Dual.ALLOUT0_ND_G1.READ_REG_GEN[5].reg1_reg\ : in STD_LOGIC;
    \Dual.ALLOUT0_ND_G1.READ_REG_GEN[4].reg1_reg\ : in STD_LOGIC;
    \Dual.ALLOUT0_ND_G1.READ_REG_GEN[3].reg1_reg\ : in STD_LOGIC;
    \Dual.ALLOUT0_ND_G1.READ_REG_GEN[2].reg1_reg\ : in STD_LOGIC;
    \Dual.ALLOUT0_ND_G1.READ_REG_GEN[1].reg1_reg\ : in STD_LOGIC;
    \Dual.ALLOUT0_ND_G1.READ_REG_GEN[0].reg1_reg\ : in STD_LOGIC;
    ip2bus_rdack_i_D1 : in STD_LOGIC;
    ip2bus_wrack_i_D1 : in STD_LOGIC;
    s_axi_araddr : in STD_LOGIC_VECTOR ( 2 downto 0 );
    s_axi_awaddr : in STD_LOGIC_VECTOR ( 2 downto 0 )
  );
end decalper_eb_ot_sdeen_pot_pi_dehcac_xnilix_axi_lite_ipif;

architecture STRUCTURE of decalper_eb_ot_sdeen_pot_pi_dehcac_xnilix_axi_lite_ipif is
begin
I_SLAVE_ATTACHMENT: entity work.decalper_eb_ot_sdeen_pot_pi_dehcac_xnilix_slave_attachment
     port map (
      D(31 downto 0) => D(31 downto 0),
      \Dual.ALLOUT0_ND_G1.READ_REG_GEN[0].reg1_reg\ => \Dual.ALLOUT0_ND_G1.READ_REG_GEN[0].reg1_reg\,
      \Dual.ALLOUT0_ND_G1.READ_REG_GEN[10].reg1_reg\ => \Dual.ALLOUT0_ND_G1.READ_REG_GEN[10].reg1_reg\,
      \Dual.ALLOUT0_ND_G1.READ_REG_GEN[11].reg1_reg\ => \Dual.ALLOUT0_ND_G1.READ_REG_GEN[11].reg1_reg\,
      \Dual.ALLOUT0_ND_G1.READ_REG_GEN[12].reg1_reg\ => \Dual.ALLOUT0_ND_G1.READ_REG_GEN[12].reg1_reg\,
      \Dual.ALLOUT0_ND_G1.READ_REG_GEN[13].reg1_reg\ => \Dual.ALLOUT0_ND_G1.READ_REG_GEN[13].reg1_reg\,
      \Dual.ALLOUT0_ND_G1.READ_REG_GEN[14].reg1_reg\ => \Dual.ALLOUT0_ND_G1.READ_REG_GEN[14].reg1_reg\,
      \Dual.ALLOUT0_ND_G1.READ_REG_GEN[15].reg1_reg\ => \Dual.ALLOUT0_ND_G1.READ_REG_GEN[15].reg1_reg\,
      \Dual.ALLOUT0_ND_G1.READ_REG_GEN[16].reg1_reg\ => \Dual.ALLOUT0_ND_G1.READ_REG_GEN[16].reg1_reg\,
      \Dual.ALLOUT0_ND_G1.READ_REG_GEN[17].reg1_reg\ => \Dual.ALLOUT0_ND_G1.READ_REG_GEN[17].reg1_reg\,
      \Dual.ALLOUT0_ND_G1.READ_REG_GEN[18].reg1_reg\ => \Dual.ALLOUT0_ND_G1.READ_REG_GEN[18].reg1_reg\,
      \Dual.ALLOUT0_ND_G1.READ_REG_GEN[19].reg1_reg\ => \Dual.ALLOUT0_ND_G1.READ_REG_GEN[19].reg1_reg\,
      \Dual.ALLOUT0_ND_G1.READ_REG_GEN[1].reg1_reg\ => \Dual.ALLOUT0_ND_G1.READ_REG_GEN[1].reg1_reg\,
      \Dual.ALLOUT0_ND_G1.READ_REG_GEN[20].reg1_reg\ => \Dual.ALLOUT0_ND_G1.READ_REG_GEN[20].reg1_reg\,
      \Dual.ALLOUT0_ND_G1.READ_REG_GEN[21].reg1_reg\ => \Dual.ALLOUT0_ND_G1.READ_REG_GEN[21].reg1_reg\,
      \Dual.ALLOUT0_ND_G1.READ_REG_GEN[22].reg1_reg\ => \Dual.ALLOUT0_ND_G1.READ_REG_GEN[22].reg1_reg\,
      \Dual.ALLOUT0_ND_G1.READ_REG_GEN[23].reg1_reg\ => \Dual.ALLOUT0_ND_G1.READ_REG_GEN[23].reg1_reg\,
      \Dual.ALLOUT0_ND_G1.READ_REG_GEN[24].reg1_reg\ => \Dual.ALLOUT0_ND_G1.READ_REG_GEN[24].reg1_reg\,
      \Dual.ALLOUT0_ND_G1.READ_REG_GEN[25].reg1_reg\ => \Dual.ALLOUT0_ND_G1.READ_REG_GEN[25].reg1_reg\,
      \Dual.ALLOUT0_ND_G1.READ_REG_GEN[26].reg1_reg\ => \Dual.ALLOUT0_ND_G1.READ_REG_GEN[26].reg1_reg\,
      \Dual.ALLOUT0_ND_G1.READ_REG_GEN[27].reg1_reg\ => \Dual.ALLOUT0_ND_G1.READ_REG_GEN[27].reg1_reg\,
      \Dual.ALLOUT0_ND_G1.READ_REG_GEN[28].reg1_reg\ => \Dual.ALLOUT0_ND_G1.READ_REG_GEN[28].reg1_reg\,
      \Dual.ALLOUT0_ND_G1.READ_REG_GEN[29].reg1_reg\ => \Dual.ALLOUT0_ND_G1.READ_REG_GEN[29].reg1_reg\,
      \Dual.ALLOUT0_ND_G1.READ_REG_GEN[2].reg1_reg\ => \Dual.ALLOUT0_ND_G1.READ_REG_GEN[2].reg1_reg\,
      \Dual.ALLOUT0_ND_G1.READ_REG_GEN[30].reg1_reg\ => \Dual.ALLOUT0_ND_G1.READ_REG_GEN[30].reg1_reg\,
      \Dual.ALLOUT0_ND_G1.READ_REG_GEN[31].reg1_reg\ => \Dual.ALLOUT0_ND_G1.READ_REG_GEN[31].reg1_reg\,
      \Dual.ALLOUT0_ND_G1.READ_REG_GEN[3].reg1_reg\ => \Dual.ALLOUT0_ND_G1.READ_REG_GEN[3].reg1_reg\,
      \Dual.ALLOUT0_ND_G1.READ_REG_GEN[4].reg1_reg\ => \Dual.ALLOUT0_ND_G1.READ_REG_GEN[4].reg1_reg\,
      \Dual.ALLOUT0_ND_G1.READ_REG_GEN[5].reg1_reg\ => \Dual.ALLOUT0_ND_G1.READ_REG_GEN[5].reg1_reg\,
      \Dual.ALLOUT0_ND_G1.READ_REG_GEN[6].reg1_reg\ => \Dual.ALLOUT0_ND_G1.READ_REG_GEN[6].reg1_reg\,
      \Dual.ALLOUT0_ND_G1.READ_REG_GEN[7].reg1_reg\ => \Dual.ALLOUT0_ND_G1.READ_REG_GEN[7].reg1_reg\,
      \Dual.ALLOUT0_ND_G1.READ_REG_GEN[8].reg1_reg\ => \Dual.ALLOUT0_ND_G1.READ_REG_GEN[8].reg1_reg\,
      \Dual.ALLOUT0_ND_G1.READ_REG_GEN[9].reg1_reg\ => \Dual.ALLOUT0_ND_G1.READ_REG_GEN[9].reg1_reg\,
      E(0) => E(0),
      GPIO_xferAck_i => GPIO_xferAck_i,
      \MEM_DECODE_GEN[0].cs_out_i_reg[0]\ => bus2ip_cs,
      Q(31 downto 0) => Q(31 downto 0),
      SR(0) => bus2ip_reset,
      bus2ip_rnw_i_reg_0 => bus2ip_rnw,
      bus2ip_rnw_i_reg_1(0) => bus2ip_rnw_i_reg(0),
      bus2ip_rnw_i_reg_2 => bus2ip_rnw_i_reg_0,
      gpio_xferAck_Reg => gpio_xferAck_Reg,
      ip2bus_rdack_i_D1 => ip2bus_rdack_i_D1,
      ip2bus_rdack_i_D1_reg => ip2bus_rdack_i_D1_reg,
      ip2bus_wrack_i_D1 => ip2bus_wrack_i_D1,
      ip2bus_wrack_i_D1_reg => ip2bus_wrack_i_D1_reg,
      reg3(0 to 31) => reg3(0 to 31),
      s_axi_aclk => s_axi_aclk,
      s_axi_araddr(2 downto 0) => s_axi_araddr(2 downto 0),
      s_axi_aresetn => s_axi_aresetn,
      s_axi_arvalid => s_axi_arvalid,
      s_axi_awaddr(2 downto 0) => s_axi_awaddr(2 downto 0),
      s_axi_awvalid => s_axi_awvalid,
      s_axi_bready => s_axi_bready,
      s_axi_bvalid_i_reg_0 => s_axi_bvalid_i_reg,
      s_axi_rdata(31 downto 0) => s_axi_rdata(31 downto 0),
      s_axi_rready => s_axi_rready,
      s_axi_rvalid_i_reg_0 => s_axi_rvalid_i_reg,
      s_axi_wvalid => s_axi_wvalid
    );
end STRUCTURE;
library IEEE;
use IEEE.STD_LOGIC_1164.ALL;
library UNISIM;
use UNISIM.VCOMPONENTS.ALL;
entity decalper_eb_ot_sdeen_pot_pi_dehcac_xnilix_axi_gpio is
  port (
    s_axi_aclk : in STD_LOGIC;
    s_axi_aresetn : in STD_LOGIC;
    s_axi_awaddr : in STD_LOGIC_VECTOR ( 8 downto 0 );
    s_axi_awvalid : in STD_LOGIC;
    s_axi_awready : out STD_LOGIC;
    s_axi_wdata : in STD_LOGIC_VECTOR ( 31 downto 0 );
    s_axi_wstrb : in STD_LOGIC_VECTOR ( 3 downto 0 );
    s_axi_wvalid : in STD_LOGIC;
    s_axi_wready : out STD_LOGIC;
    s_axi_bresp : out STD_LOGIC_VECTOR ( 1 downto 0 );
    s_axi_bvalid : out STD_LOGIC;
    s_axi_bready : in STD_LOGIC;
    s_axi_araddr : in STD_LOGIC_VECTOR ( 8 downto 0 );
    s_axi_arvalid : in STD_LOGIC;
    s_axi_arready : out STD_LOGIC;
    s_axi_rdata : out STD_LOGIC_VECTOR ( 31 downto 0 );
    s_axi_rresp : out STD_LOGIC_VECTOR ( 1 downto 0 );
    s_axi_rvalid : out STD_LOGIC;
    s_axi_rready : in STD_LOGIC;
    ip2intc_irpt : out STD_LOGIC;
    gpio_io_i : in STD_LOGIC_VECTOR ( 31 downto 0 );
    gpio_io_o : out STD_LOGIC_VECTOR ( 31 downto 0 );
    gpio_io_t : out STD_LOGIC_VECTOR ( 31 downto 0 );
    gpio2_io_i : in STD_LOGIC_VECTOR ( 31 downto 0 );
    gpio2_io_o : out STD_LOGIC_VECTOR ( 31 downto 0 );
    gpio2_io_t : out STD_LOGIC_VECTOR ( 31 downto 0 )
  );
  attribute C_ALL_INPUTS : integer;
  attribute C_ALL_INPUTS of decalper_eb_ot_sdeen_pot_pi_dehcac_xnilix_axi_gpio : entity is 0;
  attribute C_ALL_INPUTS_2 : integer;
  attribute C_ALL_INPUTS_2 of decalper_eb_ot_sdeen_pot_pi_dehcac_xnilix_axi_gpio : entity is 0;
  attribute C_ALL_OUTPUTS : integer;
  attribute C_ALL_OUTPUTS of decalper_eb_ot_sdeen_pot_pi_dehcac_xnilix_axi_gpio : entity is 1;
  attribute C_ALL_OUTPUTS_2 : integer;
  attribute C_ALL_OUTPUTS_2 of decalper_eb_ot_sdeen_pot_pi_dehcac_xnilix_axi_gpio : entity is 1;
  attribute C_DOUT_DEFAULT : integer;
  attribute C_DOUT_DEFAULT of decalper_eb_ot_sdeen_pot_pi_dehcac_xnilix_axi_gpio : entity is 0;
  attribute C_DOUT_DEFAULT_2 : integer;
  attribute C_DOUT_DEFAULT_2 of decalper_eb_ot_sdeen_pot_pi_dehcac_xnilix_axi_gpio : entity is 0;
  attribute C_FAMILY : string;
  attribute C_FAMILY of decalper_eb_ot_sdeen_pot_pi_dehcac_xnilix_axi_gpio : entity is "zynq";
  attribute C_GPIO2_WIDTH : integer;
  attribute C_GPIO2_WIDTH of decalper_eb_ot_sdeen_pot_pi_dehcac_xnilix_axi_gpio : entity is 32;
  attribute C_GPIO_WIDTH : integer;
  attribute C_GPIO_WIDTH of decalper_eb_ot_sdeen_pot_pi_dehcac_xnilix_axi_gpio : entity is 32;
  attribute C_INTERRUPT_PRESENT : integer;
  attribute C_INTERRUPT_PRESENT of decalper_eb_ot_sdeen_pot_pi_dehcac_xnilix_axi_gpio : entity is 0;
  attribute C_IS_DUAL : integer;
  attribute C_IS_DUAL of decalper_eb_ot_sdeen_pot_pi_dehcac_xnilix_axi_gpio : entity is 1;
  attribute C_S_AXI_ADDR_WIDTH : integer;
  attribute C_S_AXI_ADDR_WIDTH of decalper_eb_ot_sdeen_pot_pi_dehcac_xnilix_axi_gpio : entity is 9;
  attribute C_S_AXI_DATA_WIDTH : integer;
  attribute C_S_AXI_DATA_WIDTH of decalper_eb_ot_sdeen_pot_pi_dehcac_xnilix_axi_gpio : entity is 32;
  attribute C_TRI_DEFAULT : integer;
  attribute C_TRI_DEFAULT of decalper_eb_ot_sdeen_pot_pi_dehcac_xnilix_axi_gpio : entity is -1;
  attribute C_TRI_DEFAULT_2 : integer;
  attribute C_TRI_DEFAULT_2 of decalper_eb_ot_sdeen_pot_pi_dehcac_xnilix_axi_gpio : entity is -1;
  attribute downgradeipidentifiedwarnings : string;
  attribute downgradeipidentifiedwarnings of decalper_eb_ot_sdeen_pot_pi_dehcac_xnilix_axi_gpio : entity is "yes";
  attribute ip_group : string;
  attribute ip_group of decalper_eb_ot_sdeen_pot_pi_dehcac_xnilix_axi_gpio : entity is "LOGICORE";
end decalper_eb_ot_sdeen_pot_pi_dehcac_xnilix_axi_gpio;
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
