Tomash1A/FPGAPlatformController/VIVADO- PROJECT BUILDER SCRIPT/projectHW_ADC_build/projectHW/projectHW.cache/ip/2021.1/4a25d5d43b5d6e86/projectHW_dds_config_ctrl_0_0_sim_netlist.v

// Copyright 1986-2021 Xilinx, Inc. All Rights Reserved.
// --------------------------------------------------------------------------------
// Tool Version: Vivado v.2021.1 (win64) Build 3247384 Thu Jun 10 19:36:33 MDT 2021
// Date        : Sun Jun 28 14:59:48 2026
// Host        : CS-RO-PC29 running 64-bit major release  (build 9200)
// Command     : write_verilog -force -mode funcsim -rename_top decalper_eb_ot_sdeen_pot_pi_dehcac_xnilix -prefix
//               decalper_eb_ot_sdeen_pot_pi_dehcac_xnilix_ projectHW_dds_config_ctrl_0_0_sim_netlist.v
// Design      : projectHW_dds_config_ctrl_0_0
// Purpose     : This verilog netlist is a functional simulation representation of the design and should not be modified
//               or synthesized. This netlist cannot be used for SDF annotated simulation.
// Device      : xc7z020clg400-1
// --------------------------------------------------------------------------------
`timescale 1 ps / 1 ps

module decalper_eb_ot_sdeen_pot_pi_dehcac_xnilix_dds_config_ctrl
   (tlast,
    aresetn_o,
    tvalid,
    tdata,
    clk,
    strobe,
    data_word,
    tready);
  output tlast;
  output aresetn_o;
  output tvalid;
  output [63:0]tdata;
  input clk;
  input [2:0]strobe;
  input [31:0]data_word;
  input tready;

  wire \FSM_onehot_state[6]_i_1_n_0 ;
  wire \FSM_onehot_state[6]_i_2_n_0 ;
  wire \FSM_onehot_state_reg_n_0_[0] ;
  wire \FSM_onehot_state_reg_n_0_[1] ;
  wire \FSM_onehot_state_reg_n_0_[2] ;
  wire \FSM_onehot_state_reg_n_0_[3] ;
  wire \FSM_onehot_state_reg_n_0_[4] ;
  wire \FSM_onehot_state_reg_n_0_[5] ;
  wire aresetn_o;
  wire clk;
  wire [31:0]data_word;
  wire [63:0]in10;
  wire [63:0]in9;
  wire out_pinc_ab;
  wire [31:0]pinc_ab_r;
  wire pinc_ab_r1__4;
  wire \pinc_ab_r[31]_i_2_n_0 ;
  wire pinc_ab_r_0;
  wire [31:0]pinc_cd_r;
  wire pinc_cd_r_1;
  wire [31:0]poff_ab_r;
  wire \poff_ab_r[31]_i_2_n_0 ;
  wire poff_ab_r_2;
  wire \reset_cnt[0]_i_1_n_0 ;
  wire \reset_cnt[1]_i_1_n_0 ;
  wire \reset_cnt_reg_n_0_[0] ;
  wire \reset_cnt_reg_n_0_[1] ;
  wire [2:0]strobe;
  wire [2:0]strobe_prev;
  wire [63:0]tdata;
  wire tlast;
  wire tready;
  wire tvalid;

  LUT5 #(
    .INIT(32'hFFFFFFFE)) 
    \FSM_onehot_state[6]_i_1 
       (.I0(\FSM_onehot_state[6]_i_2_n_0 ),
        .I1(pinc_ab_r_0),
        .I2(out_pinc_ab),
        .I3(poff_ab_r_2),
        .I4(pinc_cd_r_1),
        .O(\FSM_onehot_state[6]_i_1_n_0 ));
  (* SOFT_HLUTNM = "soft_lutpair0" *) 
  LUT5 #(
    .INIT(32'hFFA8A8A8)) 
    \FSM_onehot_state[6]_i_2 
       (.I0(tready),
        .I1(\FSM_onehot_state_reg_n_0_[5] ),
        .I2(tlast),
        .I3(\FSM_onehot_state_reg_n_0_[4] ),
        .I4(\reset_cnt_reg_n_0_[1] ),
        .O(\FSM_onehot_state[6]_i_2_n_0 ));
  (* FSM_ENCODED_STATES = "rx_w0:0000001,rx_w1:0000010,rx_w2:0000100,rx_w3:0001000,reset_dds:0010000,tx_chan0:0100000,tx_chan1:1000000," *) 
  FDRE #(
    .INIT(1'b1)) 
    \FSM_onehot_state_reg[0] 
       (.C(clk),
        .CE(\FSM_onehot_state[6]_i_1_n_0 ),
        .D(tlast),
        .Q(\FSM_onehot_state_reg_n_0_[0] ),
        .R(1'b0));
  (* FSM_ENCODED_STATES = "rx_w0:0000001,rx_w1:0000010,rx_w2:0000100,rx_w3:0001000,reset_dds:0010000,tx_chan0:0100000,tx_chan1:1000000," *) 
  FDRE #(
    .INIT(1'b0)) 
    \FSM_onehot_state_reg[1] 
       (.C(clk),
        .CE(\FSM_onehot_state[6]_i_1_n_0 ),
        .D(\FSM_onehot_state_reg_n_0_[0] ),
        .Q(\FSM_onehot_state_reg_n_0_[1] ),
        .R(1'b0));
  (* FSM_ENCODED_STATES = "rx_w0:0000001,rx_w1:0000010,rx_w2:0000100,rx_w3:0001000,reset_dds:0010000,tx_chan0:0100000,tx_chan1:1000000," *) 
  FDRE #(
    .INIT(1'b0)) 
    \FSM_onehot_state_reg[2] 
       (.C(clk),
        .CE(\FSM_onehot_state[6]_i_1_n_0 ),
        .D(\FSM_onehot_state_reg_n_0_[1] ),
        .Q(\FSM_onehot_state_reg_n_0_[2] ),
        .R(1'b0));
  (* FSM_ENCODED_STATES = "rx_w0:0000001,rx_w1:0000010,rx_w2:0000100,rx_w3:0001000,reset_dds:0010000,tx_chan0:0100000,tx_chan1:1000000," *) 
  FDRE #(
    .INIT(1'b0)) 
    \FSM_onehot_state_reg[3] 
       (.C(clk),
        .CE(\FSM_onehot_state[6]_i_1_n_0 ),
        .D(\FSM_onehot_state_reg_n_0_[2] ),
        .Q(\FSM_onehot_state_reg_n_0_[3] ),
        .R(1'b0));
  (* FSM_ENCODED_STATES = "rx_w0:0000001,rx_w1:0000010,rx_w2:0000100,rx_w3:0001000,reset_dds:0010000,tx_chan0:0100000,tx_chan1:1000000," *) 
  FDRE #(
    .INIT(1'b0)) 
    \FSM_onehot_state_reg[4] 
       (.C(clk),
        .CE(\FSM_onehot_state[6]_i_1_n_0 ),
        .D(\FSM_onehot_state_reg_n_0_[3] ),
        .Q(\FSM_onehot_state_reg_n_0_[4] ),
        .R(1'b0));
  (* FSM_ENCODED_STATES = "rx_w0:0000001,rx_w1:0000010,rx_w2:0000100,rx_w3:0001000,reset_dds:0010000,tx_chan0:0100000,tx_chan1:1000000," *) 
  FDRE #(
    .INIT(1'b0)) 
    \FSM_onehot_state_reg[5] 
       (.C(clk),
        .CE(\FSM_onehot_state[6]_i_1_n_0 ),
        .D(\FSM_onehot_state_reg_n_0_[4] ),
        .Q(\FSM_onehot_state_reg_n_0_[5] ),
        .R(1'b0));
  (* FSM_ENCODED_STATES = "rx_w0:0000001,rx_w1:0000010,rx_w2:0000100,rx_w3:0001000,reset_dds:0010000,tx_chan0:0100000,tx_chan1:1000000," *) 
  FDRE #(
    .INIT(1'b0)) 
    \FSM_onehot_state_reg[6] 
       (.C(clk),
        .CE(\FSM_onehot_state[6]_i_1_n_0 ),
        .D(\FSM_onehot_state_reg_n_0_[5] ),
        .Q(tlast),
        .R(1'b0));
  LUT1 #(
    .INIT(2'h1)) 
    aresetn_o_INST_0
       (.I0(\FSM_onehot_state_reg_n_0_[4] ),
        .O(aresetn_o));
  LUT5 #(
    .INIT(32'h00080000)) 
    \out_pinc_ab[31]_i_1 
       (.I0(strobe[2]),
        .I1(\FSM_onehot_state_reg_n_0_[3] ),
        .I2(strobe[0]),
        .I3(strobe[1]),
        .I4(pinc_ab_r1__4),
        .O(out_pinc_ab));
  LUT6 #(
    .INIT(64'h6FF6FFFFFFFF6FF6)) 
    \out_pinc_ab[31]_i_2 
       (.I0(strobe_prev[0]),
        .I1(strobe[0]),
        .I2(strobe_prev[1]),
        .I3(strobe[1]),
        .I4(strobe[2]),
        .I5(strobe_prev[2]),
        .O(pinc_ab_r1__4));
  FDRE #(
    .INIT(1'b0)) 
    \out_pinc_ab_reg[0] 
       (.C(clk),
        .CE(out_pinc_ab),
        .D(pinc_ab_r[0]),
        .Q(in9[0]),
        .R(1'b0));
  FDRE #(
    .INIT(1'b0)) 
    \out_pinc_ab_reg[10] 
       (.C(clk),
        .CE(out_pinc_ab),
        .D(pinc_ab_r[10]),
        .Q(in9[10]),
        .R(1'b0));
  FDRE #(
    .INIT(1'b0)) 
    \out_pinc_ab_reg[11] 
       (.C(clk),
        .CE(out_pinc_ab),
        .D(pinc_ab_r[11]),
        .Q(in9[11]),
        .R(1'b0));
  FDRE #(
    .INIT(1'b0)) 
    \out_pinc_ab_reg[12] 
       (.C(clk),
        .CE(out_pinc_ab),
        .D(pinc_ab_r[12]),
        .Q(in9[12]),
        .R(1'b0));
  FDRE #(
    .INIT(1'b0)) 
    \out_pinc_ab_reg[13] 
       (.C(clk),
        .CE(out_pinc_ab),
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
        .I3(\FSM_onehot_state_reg_n_0_[5] ),
        .O(tdata[59]));
  LUT4 #(
    .INIT(16'hF888)) 
    \tdata[5]_INST_0 
       (.I0(in10[5]),
        .I1(tlast),
        .I2(in9[5]),
        .I3(\FSM_onehot_state_reg_n_0_[5] ),
        .O(tdata[5]));
  LUT4 #(
    .INIT(16'hF888)) 
    \tdata[60]_INST_0 
       (.I0(in10[60]),
        .I1(tlast),
        .I2(in9[60]),
        .I3(\FSM_onehot_state_reg_n_0_[5] ),
        .O(tdata[60]));
  LUT4 #(
    .INIT(16'hF888)) 
    \tdata[61]_INST_0 
       (.I0(in10[61]),
        .I1(tlast),
        .I2(in9[61]),
        .I3(\FSM_onehot_state_reg_n_0_[5] ),
        .O(tdata[61]));
  LUT4 #(
    .INIT(16'hF888)) 
    \tdata[62]_INST_0 
       (.I0(in10[62]),
        .I1(tlast),
        .I2(in9[62]),
        .I3(\FSM_onehot_state_reg_n_0_[5] ),
        .O(tdata[62]));
  LUT4 #(
    .INIT(16'hF888)) 
    \tdata[63]_INST_0 
       (.I0(in10[63]),
        .I1(tlast),
        .I2(in9[63]),
        .I3(\FSM_onehot_state_reg_n_0_[5] ),
        .O(tdata[63]));
  LUT4 #(
    .INIT(16'hF888)) 
    \tdata[6]_INST_0 
       (.I0(in10[6]),
        .I1(tlast),
        .I2(in9[6]),
        .I3(\FSM_onehot_state_reg_n_0_[5] ),
        .O(tdata[6]));
  LUT4 #(
    .INIT(16'hF888)) 
    \tdata[7]_INST_0 
       (.I0(in10[7]),
        .I1(tlast),
        .I2(in9[7]),
        .I3(\FSM_onehot_state_reg_n_0_[5] ),
        .O(tdata[7]));
  LUT4 #(
    .INIT(16'hF888)) 
    \tdata[8]_INST_0 
       (.I0(in10[8]),
        .I1(tlast),
        .I2(in9[8]),
        .I3(\FSM_onehot_state_reg_n_0_[5] ),
        .O(tdata[8]));
  LUT4 #(
    .INIT(16'hF888)) 
    \tdata[9]_INST_0 
       (.I0(in10[9]),
        .I1(tlast),
        .I2(in9[9]),
        .I3(\FSM_onehot_state_reg_n_0_[5] ),
        .O(tdata[9]));
  (* SOFT_HLUTNM = "soft_lutpair0" *) 
  LUT2 #(
    .INIT(4'hE)) 
    tvalid_INST_0
       (.I0(\FSM_onehot_state_reg_n_0_[5] ),
        .I1(tlast),
        .O(tvalid));
endmodule

(* CHECK_LICENSE_TYPE = "projectHW_dds_config_ctrl_0_0,dds_config_ctrl,{}" *) (* DowngradeIPIdentifiedWarnings = "yes" *) (* IP_DEFINITION_SOURCE = "module_ref" *) 
(* X_CORE_INFO = "dds_config_ctrl,Vivado 2021.1" *) 
(* NotValidForBitStream *)
module decalper_eb_ot_sdeen_pot_pi_dehcac_xnilix
   (clk,
    data_word,
    strobe,
    tready,
    tdata,
    tvalid,
    tlast,
    aresetn_o);
  (* X_INTERFACE_INFO = "xilinx.com:signal:clock:1.0 clk CLK" *) (* X_INTERFACE_PARAMETER = "XIL_INTERFACENAME clk, ASSOCIATED_BUSIF interface_axis, FREQ_HZ 100000000, FREQ_TOLERANCE_HZ 0, PHASE 0.0, CLK_DOMAIN projectHW_FPGA_CLK_BUF_0_IBUF_OUT, INSERT_VIP 0" *) input clk;
  input [31:0]data_word;
  input [2:0]strobe;
  (* X_INTERFACE_INFO = "xilinx.com:interface:axis:1.0 interface_axis TREADY" *) input tready;
  (* X_INTERFACE_INFO = "xilinx.com:interface:axis:1.0 interface_axis TDATA" *) output [63:0]tdata;
  (* X_INTERFACE_INFO = "xilinx.com:interface:axis:1.0 interface_axis TVALID" *) output tvalid;
  (* X_INTERFACE_INFO = "xilinx.com:interface:axis:1.0 interface_axis TLAST" *) (* X_INTERFACE_PARAMETER = "XIL_INTERFACENAME interface_axis, TDATA_NUM_BYTES 8, TDEST_WIDTH 0, TID_WIDTH 0, TUSER_WIDTH 0, HAS_TREADY 1, HAS_TSTRB 0, HAS_TKEEP 0, HAS_TLAST 1, FREQ_HZ 100000000, PHASE 0.0, CLK_DOMAIN projectHW_FPGA_CLK_BUF_0_IBUF_OUT, LAYERED_METADATA undef, INSERT_VIP 0" *) output tlast;
  output aresetn_o;

  wire aresetn_o;
  wire clk;
  wire [31:0]data_word;
  wire [2:0]strobe;
  wire [63:0]tdata;
  wire tlast;
  wire tready;
  wire tvalid;

  decalper_eb_ot_sdeen_pot_pi_dehcac_xnilix_dds_config_ctrl inst
       (.aresetn_o(aresetn_o),
        .clk(clk),
        .data_word(data_word),
        .strobe(strobe),
        .tdata(tdata),
        .tlast(tlast),
        .tready(tready),
        .tvalid(tvalid));
endmodule
`ifndef GLBL
`define GLBL
`timescale  1 ps / 1 ps

module glbl ();

    parameter ROC_WIDTH = 100000;
    parameter TOC_WIDTH = 0;
    parameter GRES_WIDTH = 10000;
    parameter GRES_START = 10000;

//--------   STARTUP Globals --------------
    wire GSR;
    wire GTS;
    wire GWE;
    wire PRLD;
    wire GRESTORE;
    tri1 p_up_tmp;
    tri (weak1, strong0) PLL_LOCKG = p_up_tmp;

    wire PROGB_GLBL;
    wire CCLKO_GLBL;
    wire FCSBO_GLBL;
    wire [3:0] DO_GLBL;
    wire [3:0] DI_GLBL;
   
    reg GSR_int;
    reg GTS_int;
    reg PRLD_int;
    reg GRESTORE_int;

//--------   JTAG Globals --------------
    wire JTAG_TDO_GLBL;
    wire JTAG_TCK_GLBL;
    wire JTAG_TDI_GLBL;
    wire JTAG_TMS_GLBL;
    wire JTAG_TRST_GLBL;

    reg JTAG_CAPTURE_GLBL;
    reg JTAG_RESET_GLBL;
    reg JTAG_SHIFT_GLBL;
    reg JTAG_UPDATE_GLBL;
    reg JTAG_RUNTEST_GLBL;

    reg JTAG_SEL1_GLBL = 0;
    reg JTAG_SEL2_GLBL = 0 ;
    reg JTAG_SEL3_GLBL = 0;
    reg JTAG_SEL4_GLBL = 0;

    reg JTAG_USER_TDO1_GLBL = 1'bz;
    reg JTAG_USER_TDO2_GLBL = 1'bz;
    reg JTAG_USER_TDO3_GLBL = 1'bz;
    reg JTAG_USER_TDO4_GLBL = 1'bz;

    assign (strong1, weak0) GSR = GSR_int;
    assign (strong1, weak0) GTS = GTS_int;
    assign (weak1, weak0) PRLD = PRLD_int;
    assign (strong1, weak0) GRESTORE = GRESTORE_int;

    initial begin
	GSR_int = 1'b1;
	PRLD_int = 1'b1;
	#(ROC_WIDTH)
	GSR_int = 1'b0;
	PRLD_int = 1'b0;
    end

    initial begin
	GTS_int = 1'b1;
	#(TOC_WIDTH)
	GTS_int = 1'b0;
    end

    initial begin 
	GRESTORE_int = 1'b0;
	#(GRES_START);
	GRESTORE_int = 1'b1;
	#(GRES_WIDTH);
	GRESTORE_int = 1'b0;
    end

endmodule
`endif
