Tomash1A/FPGAPlatformController/VIVADO- PROJECT BUILDER SCRIPT/projectHW_ADC_build/projectHW/projectHW.cache/ip/2021.1/4a25d5d43b5d6e86/projectHW_dds_config_ctrl_0_0_sim_netlist.vhdl

-- Copyright 1986-2021 Xilinx, Inc. All Rights Reserved.
-- --------------------------------------------------------------------------------
-- Tool Version: Vivado v.2021.1 (win64) Build 3247384 Thu Jun 10 19:36:33 MDT 2021
-- Date        : Sun Jun 28 14:59:48 2026
-- Host        : CS-RO-PC29 running 64-bit major release  (build 9200)
-- Command     : write_vhdl -force -mode funcsim -rename_top decalper_eb_ot_sdeen_pot_pi_dehcac_xnilix -prefix
--               decalper_eb_ot_sdeen_pot_pi_dehcac_xnilix_ projectHW_dds_config_ctrl_0_0_sim_netlist.vhdl
-- Design      : projectHW_dds_config_ctrl_0_0
-- Purpose     : This VHDL netlist is a functional simulation representation of the design and should not be modified or
--               synthesized. This netlist cannot be used for SDF annotated simulation.
-- Device      : xc7z020clg400-1
-- --------------------------------------------------------------------------------
library IEEE;
use IEEE.STD_LOGIC_1164.ALL;
library UNISIM;
use UNISIM.VCOMPONENTS.ALL;
entity decalper_eb_ot_sdeen_pot_pi_dehcac_xnilix_dds_config_ctrl is
  port (
    tlast : out STD_LOGIC;
    aresetn_o : out STD_LOGIC;
    tvalid : out STD_LOGIC;
    tdata : out STD_LOGIC_VECTOR ( 63 downto 0 );
    clk : in STD_LOGIC;
    strobe : in STD_LOGIC_VECTOR ( 2 downto 0 );
    data_word : in STD_LOGIC_VECTOR ( 31 downto 0 );
    tready : in STD_LOGIC
  );
end decalper_eb_ot_sdeen_pot_pi_dehcac_xnilix_dds_config_ctrl;

architecture STRUCTURE of decalper_eb_ot_sdeen_pot_pi_dehcac_xnilix_dds_config_ctrl is
  signal \FSM_onehot_state[6]_i_1_n_0\ : STD_LOGIC;
  signal \FSM_onehot_state[6]_i_2_n_0\ : STD_LOGIC;
  signal \FSM_onehot_state_reg_n_0_[0]\ : STD_LOGIC;
  signal \FSM_onehot_state_reg_n_0_[1]\ : STD_LOGIC;
  signal \FSM_onehot_state_reg_n_0_[2]\ : STD_LOGIC;
  signal \FSM_onehot_state_reg_n_0_[3]\ : STD_LOGIC;
  signal \FSM_onehot_state_reg_n_0_[4]\ : STD_LOGIC;
  signal \FSM_onehot_state_reg_n_0_[5]\ : STD_LOGIC;
  signal in10 : STD_LOGIC_VECTOR ( 63 downto 0 );
  signal in9 : STD_LOGIC_VECTOR ( 63 downto 0 );
  signal out_pinc_ab : STD_LOGIC;
  signal pinc_ab_r : STD_LOGIC_VECTOR ( 31 downto 0 );
  signal \pinc_ab_r1__4\ : STD_LOGIC;
  signal \pinc_ab_r[31]_i_2_n_0\ : STD_LOGIC;
  signal pinc_ab_r_0 : STD_LOGIC;
  signal pinc_cd_r : STD_LOGIC_VECTOR ( 31 downto 0 );
  signal pinc_cd_r_1 : STD_LOGIC;
  signal poff_ab_r : STD_LOGIC_VECTOR ( 31 downto 0 );
  signal \poff_ab_r[31]_i_2_n_0\ : STD_LOGIC;
  signal poff_ab_r_2 : STD_LOGIC;
  signal \reset_cnt[0]_i_1_n_0\ : STD_LOGIC;
  signal \reset_cnt[1]_i_1_n_0\ : STD_LOGIC;
  signal \reset_cnt_reg_n_0_[0]\ : STD_LOGIC;
  signal \reset_cnt_reg_n_0_[1]\ : STD_LOGIC;
  signal strobe_prev : STD_LOGIC_VECTOR ( 2 downto 0 );
  signal \^tlast\ : STD_LOGIC;
  attribute SOFT_HLUTNM : string;
  attribute SOFT_HLUTNM of \FSM_onehot_state[6]_i_2\ : label is "soft_lutpair0";
  attribute FSM_ENCODED_STATES : string;
  attribute FSM_ENCODED_STATES of \FSM_onehot_state_reg[0]\ : label is "rx_w0:0000001,rx_w1:0000010,rx_w2:0000100,rx_w3:0001000,reset_dds:0010000,tx_chan0:0100000,tx_chan1:1000000,";
  attribute FSM_ENCODED_STATES of \FSM_onehot_state_reg[1]\ : label is "rx_w0:0000001,rx_w1:0000010,rx_w2:0000100,rx_w3:0001000,reset_dds:0010000,tx_chan0:0100000,tx_chan1:1000000,";
  attribute FSM_ENCODED_STATES of \FSM_onehot_state_reg[2]\ : label is "rx_w0:0000001,rx_w1:0000010,rx_w2:0000100,rx_w3:0001000,reset_dds:0010000,tx_chan0:0100000,tx_chan1:1000000,";
  attribute FSM_ENCODED_STATES of \FSM_onehot_state_reg[3]\ : label is "rx_w0:0000001,rx_w1:0000010,rx_w2:0000100,rx_w3:0001000,reset_dds:0010000,tx_chan0:0100000,tx_chan1:1000000,";
  attribute FSM_ENCODED_STATES of \FSM_onehot_state_reg[4]\ : label is "rx_w0:0000001,rx_w1:0000010,rx_w2:0000100,rx_w3:0001000,reset_dds:0010000,tx_chan0:0100000,tx_chan1:1000000,";
  attribute FSM_ENCODED_STATES of \FSM_onehot_state_reg[5]\ : label is "rx_w0:0000001,rx_w1:0000010,rx_w2:0000100,rx_w3:0001000,reset_dds:0010000,tx_chan0:0100000,tx_chan1:1000000,";
  attribute FSM_ENCODED_STATES of \FSM_onehot_state_reg[6]\ : label is "rx_w0:0000001,rx_w1:0000010,rx_w2:0000100,rx_w3:0001000,reset_dds:0010000,tx_chan0:0100000,tx_chan1:1000000,";
  attribute SOFT_HLUTNM of \reset_cnt[0]_i_1\ : label is "soft_lutpair1";
  attribute SOFT_HLUTNM of \reset_cnt[1]_i_1\ : label is "soft_lutpair1";
  attribute SOFT_HLUTNM of tvalid_INST_0 : label is "soft_lutpair0";
begin
  tlast <= \^tlast\;
\FSM_onehot_state[6]_i_1\: unisim.vcomponents.LUT5
    generic map(
      INIT => X"FFFFFFFE"
    )
        port map (
      I0 => \FSM_onehot_state[6]_i_2_n_0\,
      I1 => pinc_ab_r_0,
      I2 => out_pinc_ab,
      I3 => poff_ab_r_2,
      I4 => pinc_cd_r_1,
      O => \FSM_onehot_state[6]_i_1_n_0\
    );
\FSM_onehot_state[6]_i_2\: unisim.vcomponents.LUT5
    generic map(
      INIT => X"FFA8A8A8"
    )
        port map (
      I0 => tready,
      I1 => \FSM_onehot_state_reg_n_0_[5]\,
      I2 => \^tlast\,
      I3 => \FSM_onehot_state_reg_n_0_[4]\,
      I4 => \reset_cnt_reg_n_0_[1]\,
      O => \FSM_onehot_state[6]_i_2_n_0\
    );
\FSM_onehot_state_reg[0]\: unisim.vcomponents.FDRE
    generic map(
      INIT => '1'
    )
        port map (
      C => clk,
      CE => \FSM_onehot_state[6]_i_1_n_0\,
      D => \^tlast\,
      Q => \FSM_onehot_state_reg_n_0_[0]\,
      R => '0'
    );
\FSM_onehot_state_reg[1]\: unisim.vcomponents.FDRE
    generic map(
      INIT => '0'
    )
        port map (
      C => clk,
      CE => \FSM_onehot_state[6]_i_1_n_0\,
      D => \FSM_onehot_state_reg_n_0_[0]\,
      Q => \FSM_onehot_state_reg_n_0_[1]\,
      R => '0'
    );
\FSM_onehot_state_reg[2]\: unisim.vcomponents.FDRE
    generic map(
      INIT => '0'
    )
        port map (
      C => clk,
      CE => \FSM_onehot_state[6]_i_1_n_0\,
      D => \FSM_onehot_state_reg_n_0_[1]\,
      Q => \FSM_onehot_state_reg_n_0_[2]\,
      R => '0'
    );
\FSM_onehot_state_reg[3]\: unisim.vcomponents.FDRE
    generic map(
      INIT => '0'
    )
        port map (
      C => clk,
      CE => \FSM_onehot_state[6]_i_1_n_0\,
      D => \FSM_onehot_state_reg_n_0_[2]\,
      Q => \FSM_onehot_state_reg_n_0_[3]\,
      R => '0'
    );
\FSM_onehot_state_reg[4]\: unisim.vcomponents.FDRE
    generic map(
      INIT => '0'
    )
        port map (
      C => clk,
      CE => \FSM_onehot_state[6]_i_1_n_0\,
      D => \FSM_onehot_state_reg_n_0_[3]\,
      Q => \FSM_onehot_state_reg_n_0_[4]\,
      R => '0'
    );
\FSM_onehot_state_reg[5]\: unisim.vcomponents.FDRE
    generic map(
      INIT => '0'
    )
        port map (
      C => clk,
      CE => \FSM_onehot_state[6]_i_1_n_0\,
      D => \FSM_onehot_state_reg_n_0_[4]\,
      Q => \FSM_onehot_state_reg_n_0_[5]\,
      R => '0'
    );
\FSM_onehot_state_reg[6]\: unisim.vcomponents.FDRE
    generic map(
      INIT => '0'
    )
        port map (
      C => clk,
      CE => \FSM_onehot_state[6]_i_1_n_0\,
      D => \FSM_onehot_state_reg_n_0_[5]\,
      Q => \^tlast\,
      R => '0'
    );
aresetn_o_INST_0: unisim.vcomponents.LUT1
    generic map(
      INIT => X"1"
    )
        port map (
      I0 => \FSM_onehot_state_reg_n_0_[4]\,
      O => aresetn_o
    );
\out_pinc_ab[31]_i_1\: unisim.vcomponents.LUT5
    generic map(
      INIT => X"00080000"
    )
        port map (
      I0 => strobe(2),
      I1 => \FSM_onehot_state_reg_n_0_[3]\,
      I2 => strobe(0),
      I3 => strobe(1),
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
    )
        port map (
      C => clk,
      CE => '1',
      D => strobe(1),
      Q => strobe_prev(1),
      R => '0'
    );
\strobe_prev_reg[2]\: unisim.vcomponents.FDRE
    generic map(
      INIT => '0'
    )
        port map (
      C => clk,
      CE => '1',
      D => strobe(2),
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
