Tomash1A/FPGAPlatformController/(commit log)

2026-06-09 Initial commit: MT and ADC build folders, PYNQ code, XSA files, docs
2026-06-09 Fix pynq_bram: remove MT_2/MT_3 entries, design only has MT_0 and MT_1
    [pynq_bram.py]
2026-06-09 Fix pynq_bram: set _VALID_CHANNELS to (1, 2) only
    [pynq_bram.py]
2026-07-20 Full project backup- w/o image)
    [Clock_Generator_REV2.SchDoc, DACֹֹ_Sources_REV2.PrjPcb, DACֹֹ_Sources_REV2.SchDoc, Power_Supply_REV2.SchDoc]
2026-07-20 Restore ADC build folder and merge PYNQ folders into one
2026-07-20 Update ADC block design diagram with new layout
2026-07-23 Update repository from CheckPoint directory
    - Renamed PYNQ FILES to PYNQ with updated content, preserving README.md
    - Replaced ALTIUM directory with latest PCB design from checkpoint
    - Added clock_configuration_for_zynq directory with configuration files
    - Refreshed DATASHEETS AND DOCUMENTS with latest files
    - Kept existing directories (docs, xsa, VIVADO script, projectHW_ADC_build)
    All updates synchronized from: C:\Users\shtomer\WIS_work\CheckPoint
    [Clock_Generator.SchDoc, Clock_Generator_REV2.SchDoc, DACֹֹ_Sources.PrjPcb, DACֹֹ_Sources.SchDoc, DACֹֹ_Sources.xlsx, DACֹֹ_Sources_REV2.PrjPcb, DACֹֹ_Sources_REV2.SchDoc, Power_Supply.SchDoc]
